ChinaClever/CleverDoc/管理软件/CleverManager项目研发资料输出一览表及相关表单/网络压力可靠性试验/Docker模拟测试/模拟udp管理程序/执行说明.txt

1.打开终端 

Ctrl + Alt + T

2.进入超级管理员权限
sudo su
password：123456

3.执行程序
./test
