ChinaClever/CleverDoc/公司文件/定制文件表格/样品定制申请表.docx

样品定制申请表

发出部门 | | | 发出日期 | | | | | | 编号
产品名称 | | | | | | | | | 客户信息
产品定制简述 （定制内容） | 技术要求简述
| 订单量 预估 | | | | | | 订单需求 时间
定制责任人（部门）确认 | 技术可行性评估及建议
| 定制完成期限
| 责任人 | | | | | | 部门
编制 | | | | 审核 | | | | 批准
公司审批
接受部门 | | | | | 市场技术支持部

存档：市场技术支持部，定制发出业务部门。 表格编号：QR-JSZC-001 A/0
