ChinaClever/CleverDoc/管理软件/CleverManager项目研发资料输出一览表及相关表单/网络压力可靠性试验/网络压力测试纪录.docx

网络压力测试纪录

100ip 500dev

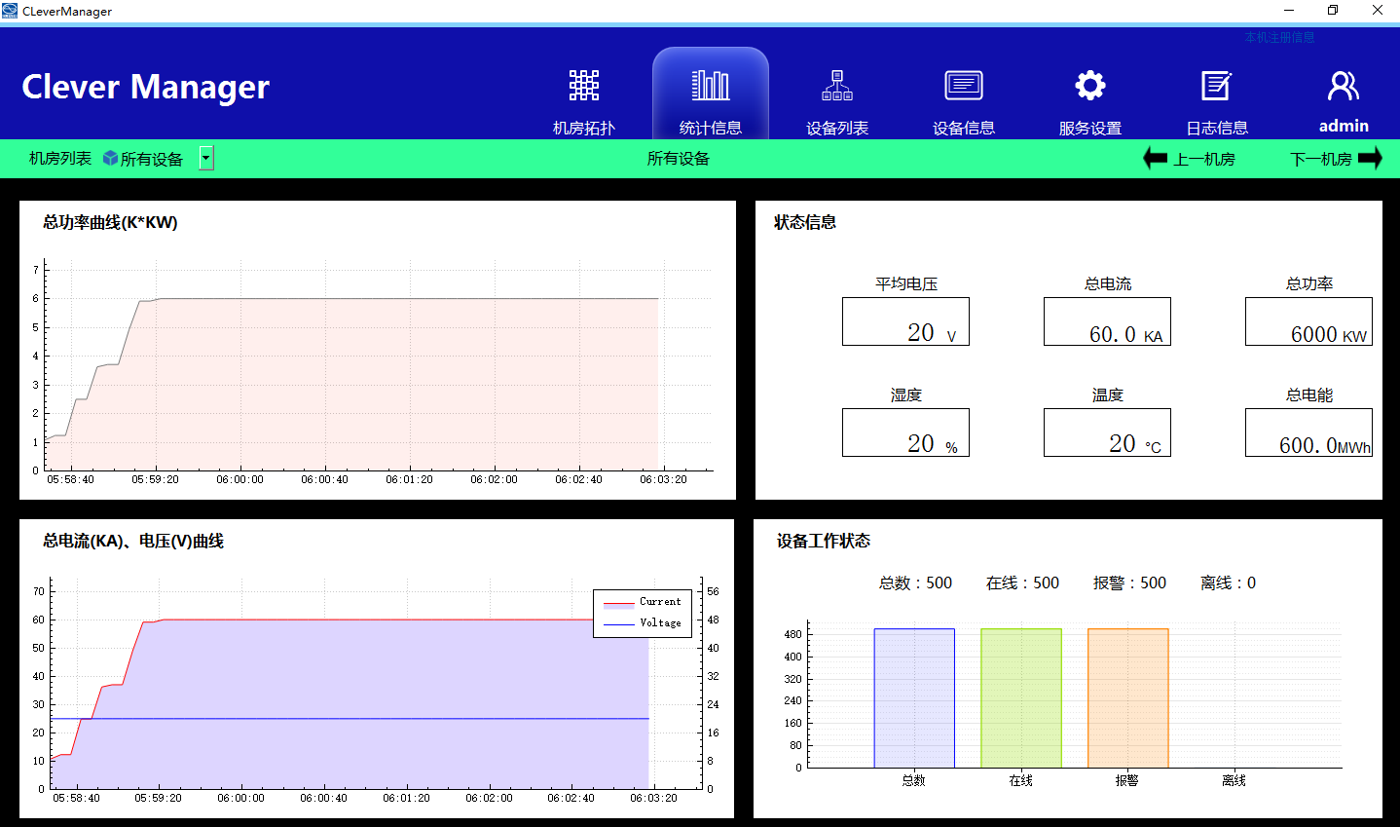
[picture p35: figure]

100ip 1000dev

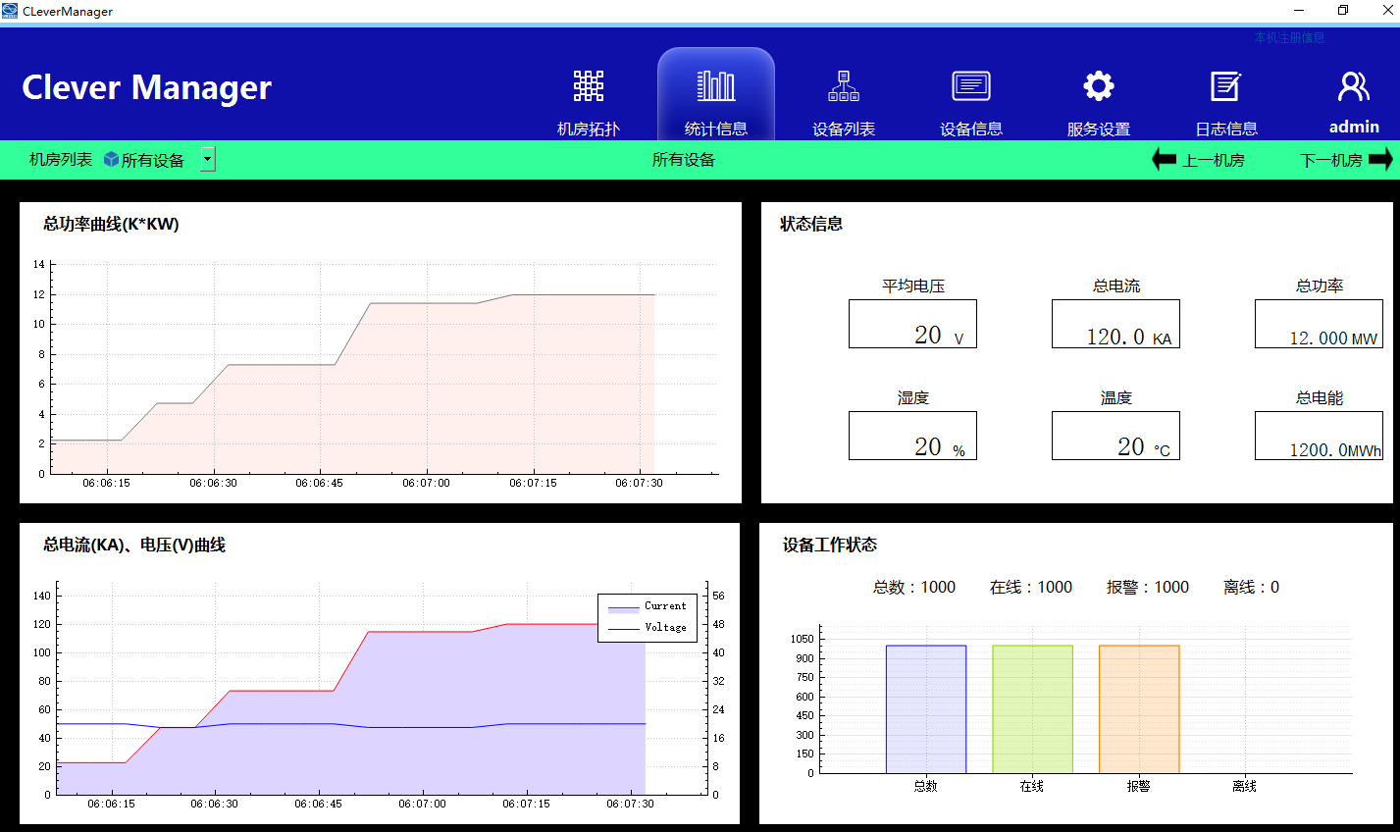
[picture p36: figure]

200ip 1000dev

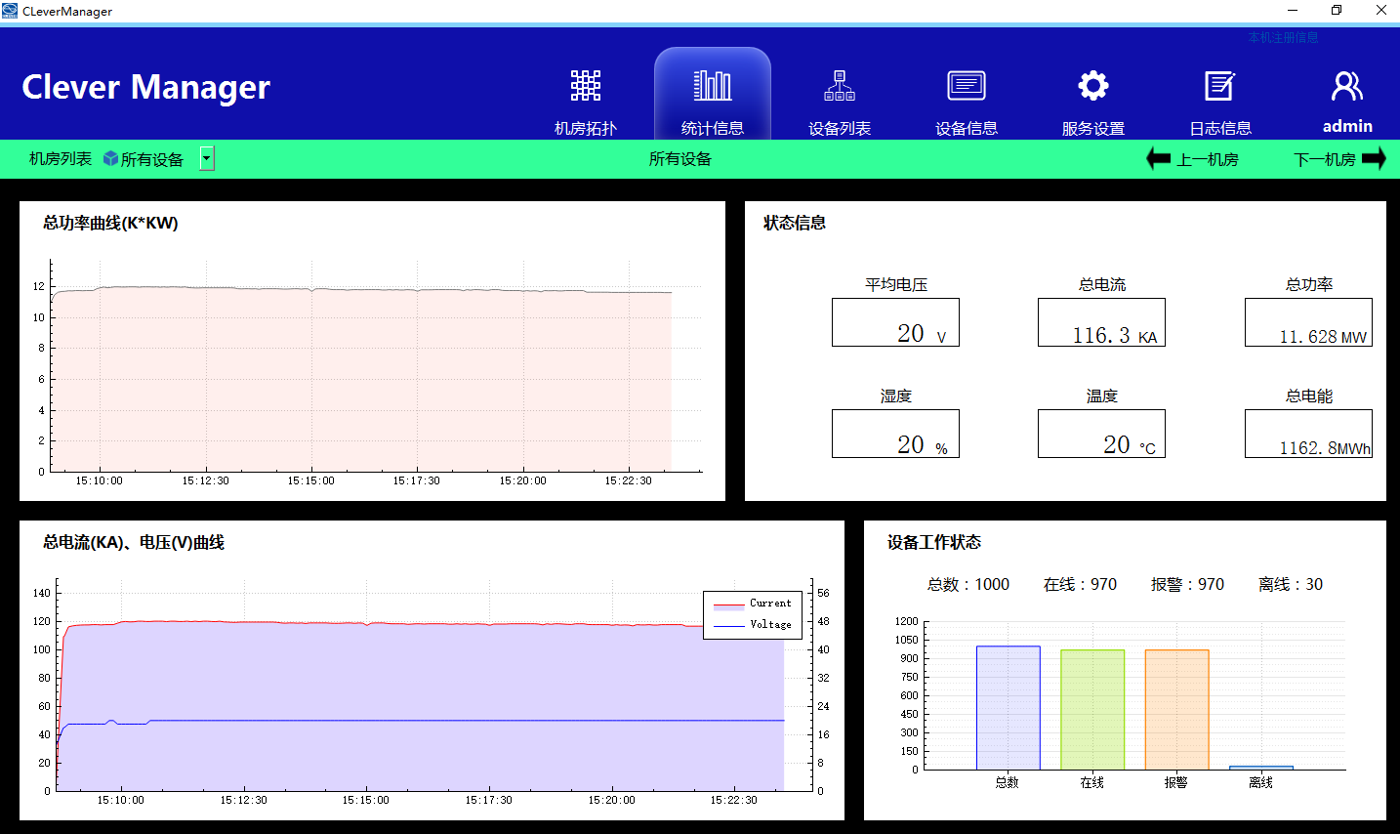
[picture p37: figure]

200ip 1200dev

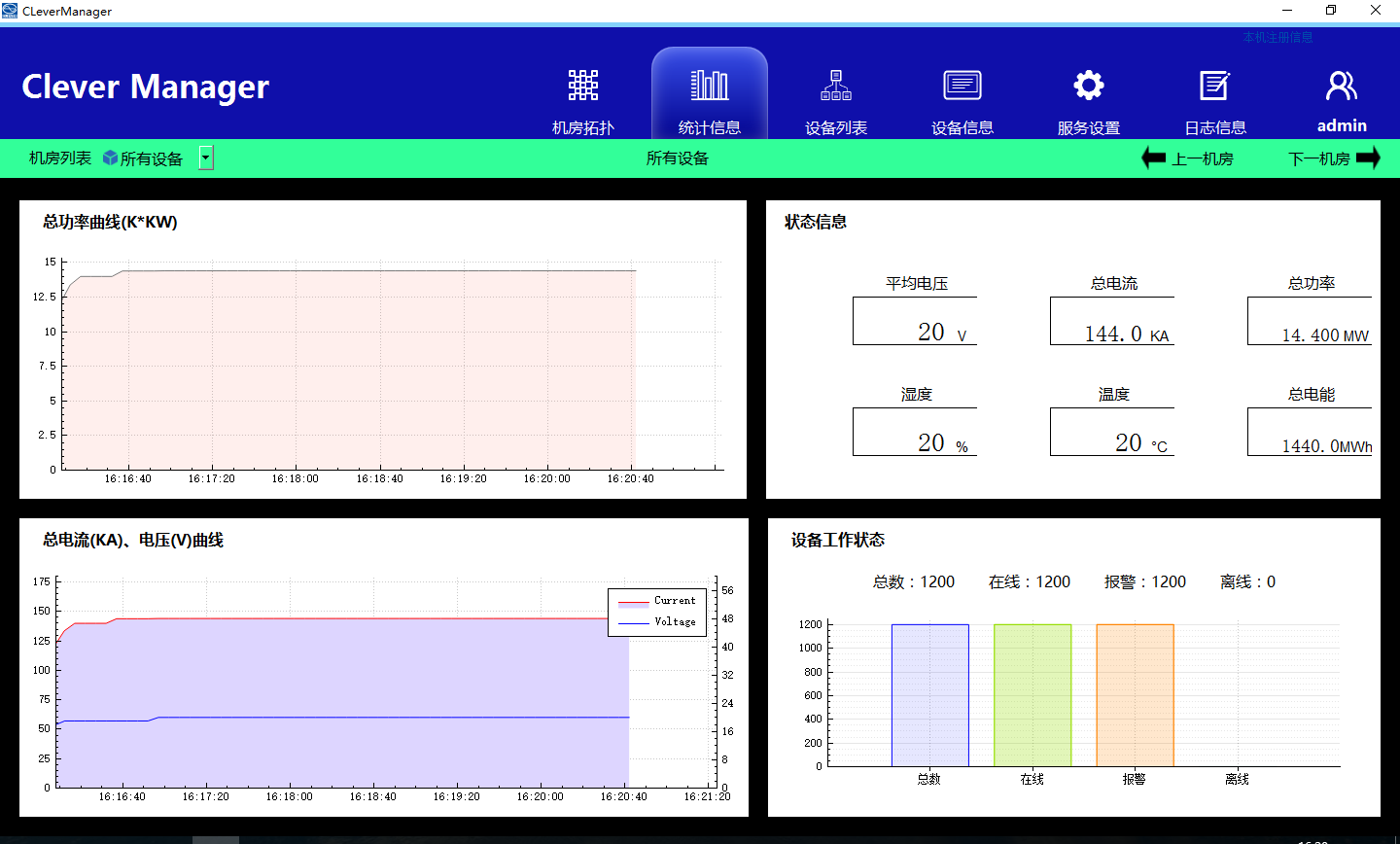
[picture p38: figure]

1000ip 1200dev

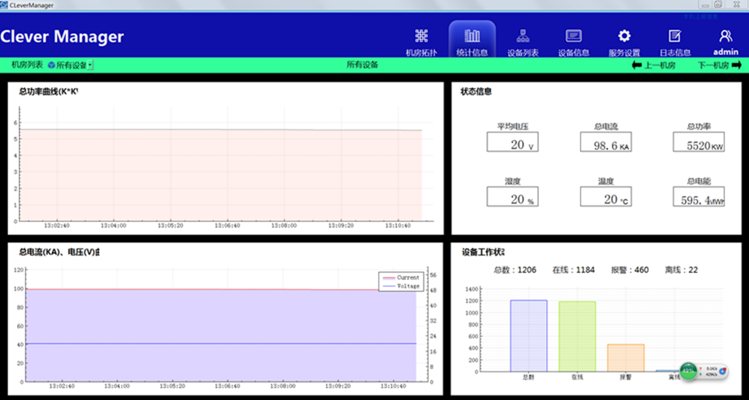
[picture p39: figure]

1000ip 2100dev

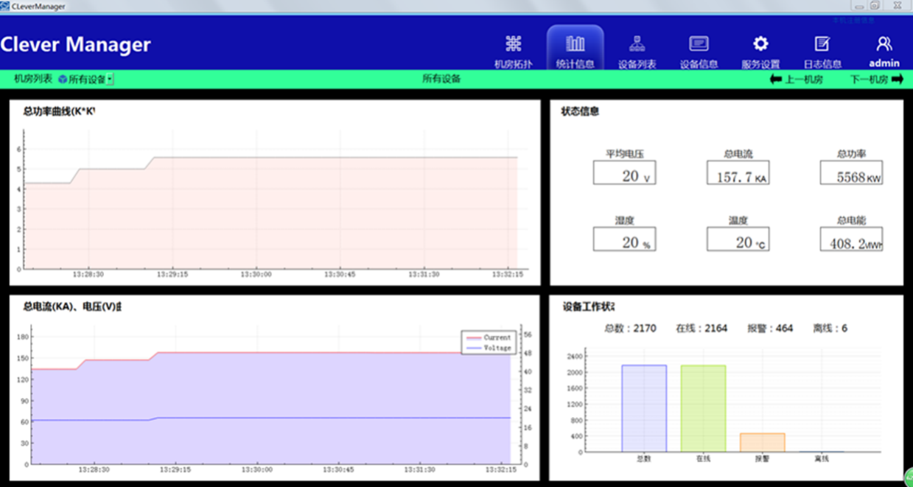
[picture p40: figure]

1000ip 1700dev 14小时长时间挂机测试

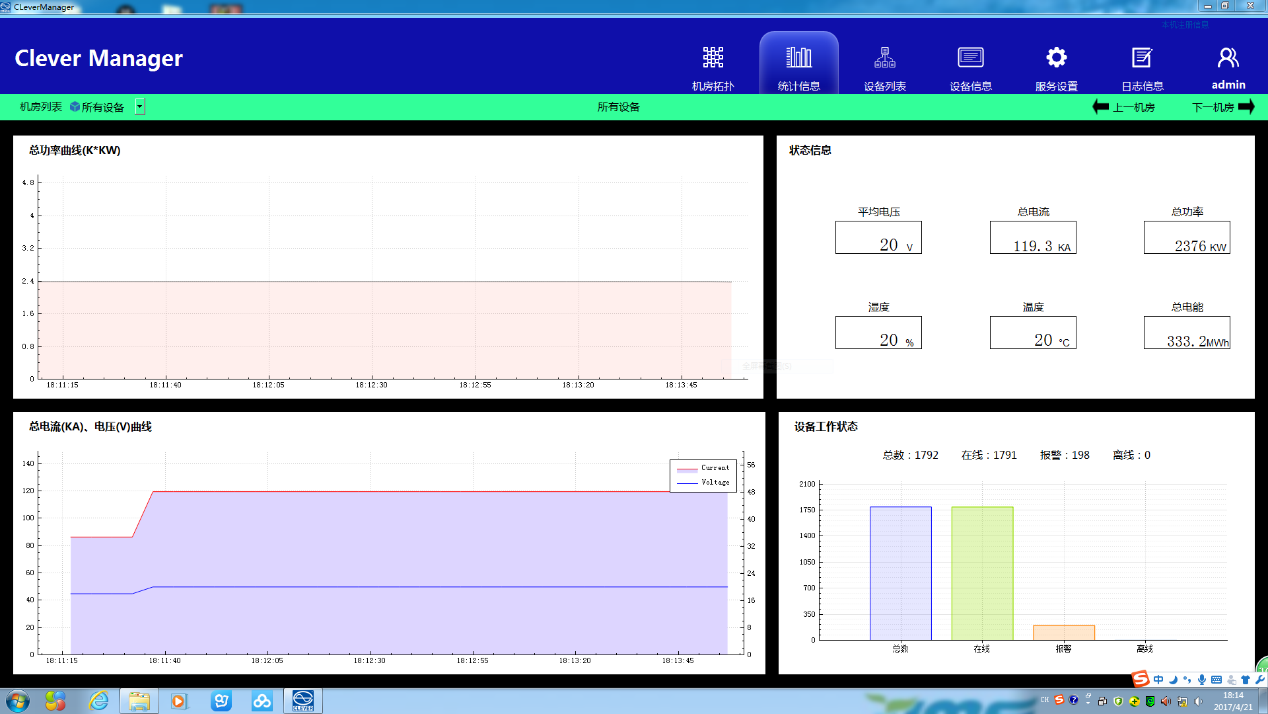
[picture p41: figure]
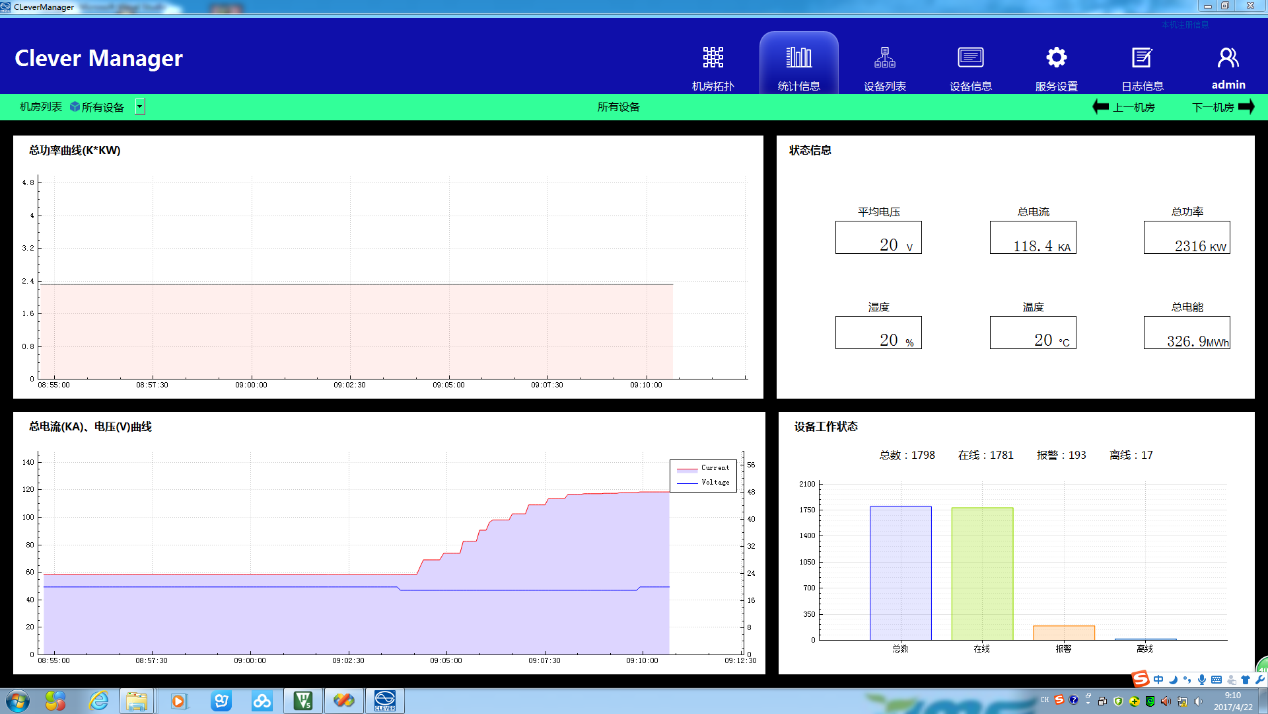
[picture p42: figure]
