ChinaClever/CleverDoc/管理软件/CleverManager项目研发资料输出一览表及相关表单/网络压力可靠性试验/Docker模拟测试/docker测试记录.docx

100ip 500dev


100ip 1000dev


200ip 1000dev


200ip 1200dev


1000ip 1200dev


1000ip 2100dev


1000ip 1700dev 14小时长时间挂机测试
