ChinaClever/CleverDoc/MPDU/MPDU 2017产品资料/MS-PDU2017-单三相32A操作显示页面流程.pdf

R:243
G:214
B:172

三相32A显示操作流程

常亮循环页面有8个：每相显示电流电压功率电能
每组电流, | ,
长按CONTROL键，进入每位插座位电流监控页面

温湿度 IP地址

长按CONTROL+UP键,进入每位插座位功率监控页面 长按CONTROL+DOWN键,进入每位插座位电能监控页面

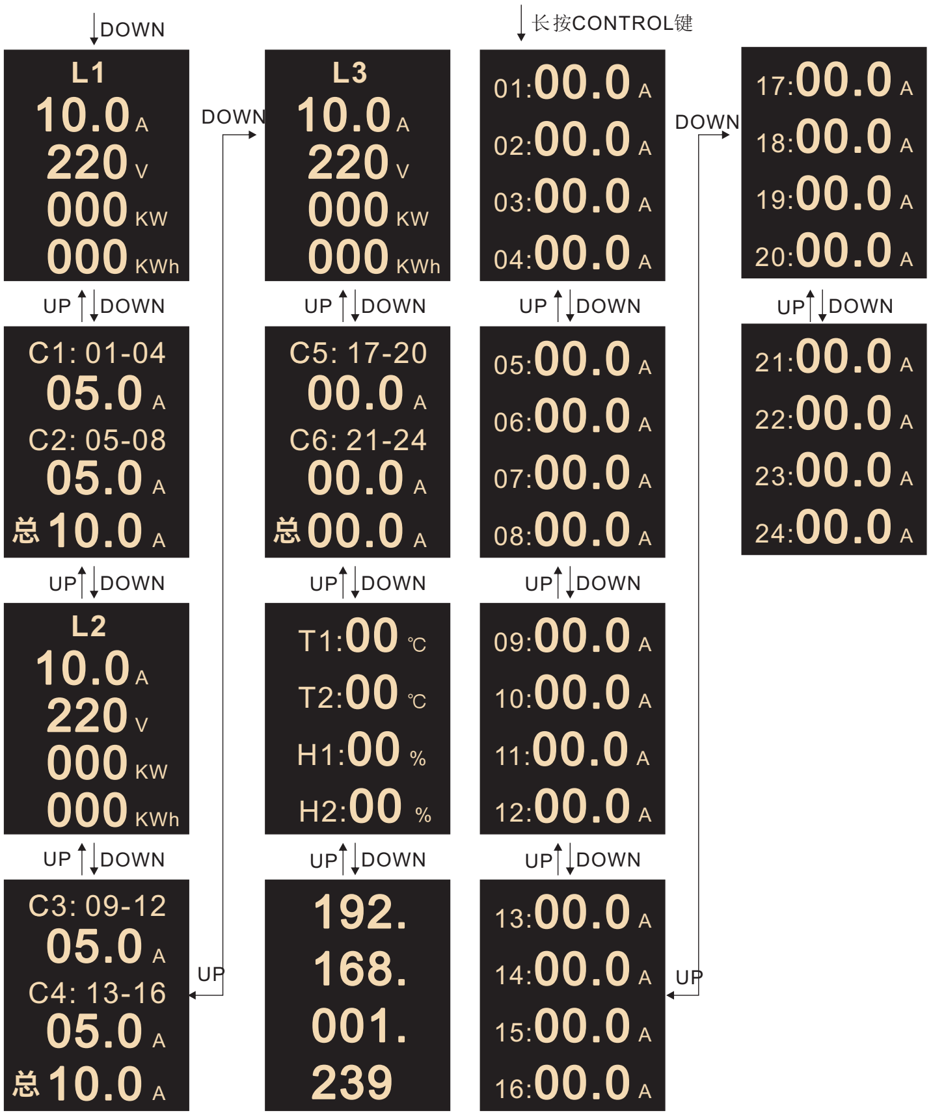
[picture p76: figure]
KWh; DOWN; 长按CONTROL键

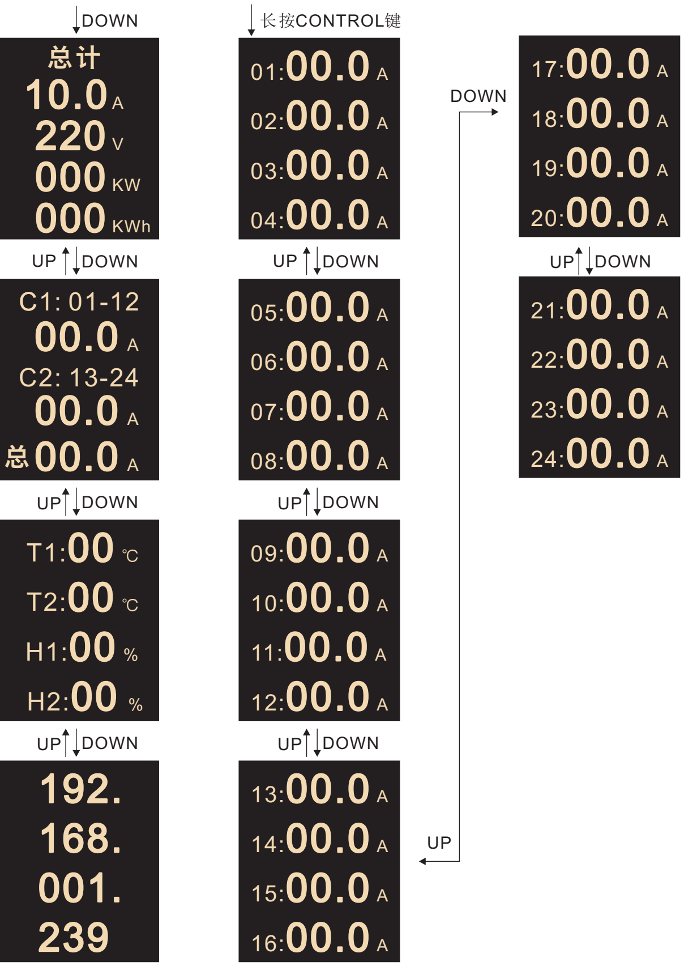
[picture p77: figure]
KWh; DOWN; 长按CONTROL键

R:243
G:214
B:172

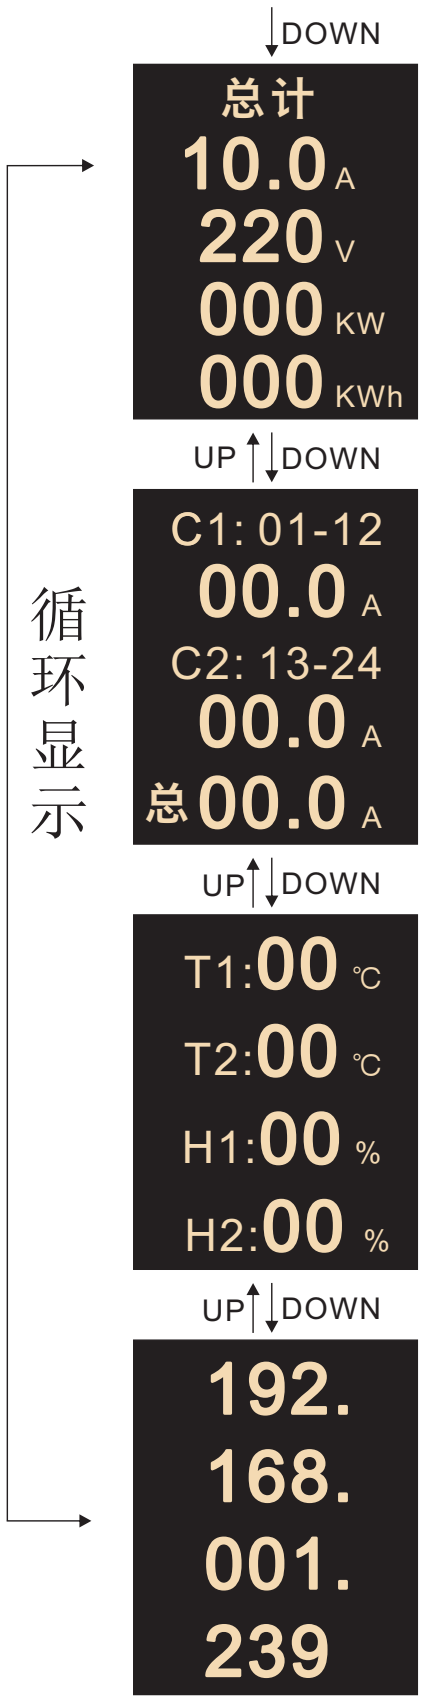
[picture p78: figure]

单相32A显示操作流程

常亮循环页面有四个：1.显示电流电压功率电能
2.每组电流 3. | 4.
长按CONTROL键，进入每位插座位电流监控页面

温湿度 IP地址

长按CONTROL+UP键,进入每位插座位功率监控页面 长按CONTROL+DOWN键,进入每位插座位电能监控页面

01:00.0 KW | 01:00.0 KWh
05:00.0 KW | 05:00.0 KWh
09:00.0 KW | 09:00.0 KWh
13:00.0 KW | 13:00.0 KWh
17:00.0 KW | 17:00.0 KWh
21:00.0 KW | 21:00.0 KWh
02:00.0 KW | 02:00.0 KWh
06:00.0 KW | 06:00.0 KWh
10:00.0 KW | 10:00.0 KWh
14:00.0 KW | 14:00.0 KWh
18:00.0 KW | 18:00.0 KWh
22:00.0 KW | 22:00.0 KWh
03:00.0 KW | 03:00.0 KWh
07:00.0 KW | 07:00.0 KWh
11:00.0 KW | 11:00.0 KWh
15:00.0 KW | 15:00.0 KWh
19:00.0 KW | 19:00.0 KWh
23:00.0 KW | 23:00.0 KWh
04:00.0 KW | 04:00.0 KWh
08:00.0 KW | 08:00.0 KWh
12:00.0 KW | 12:00.0 KWh
16:00.0 KW | 16:00.0 KWh
20:00.0 KW | 20:00.0 KWh
24:00.0 KW | 24:00.0 KWh

UP

UP

UP

DOWN | UP

DOWN

DOWN

DOWN

DOWN

DOWN | DOWN

DOWN

UP

UP | UP
UP | UP

UP

长按
CONTROL
+UP键

长按
CONTROL
+DOWN键
DOWN | DOWN
