ChinaClever/CleverDoc/MPDU/MPDU 2017产品资料/MS-PDU   2.png

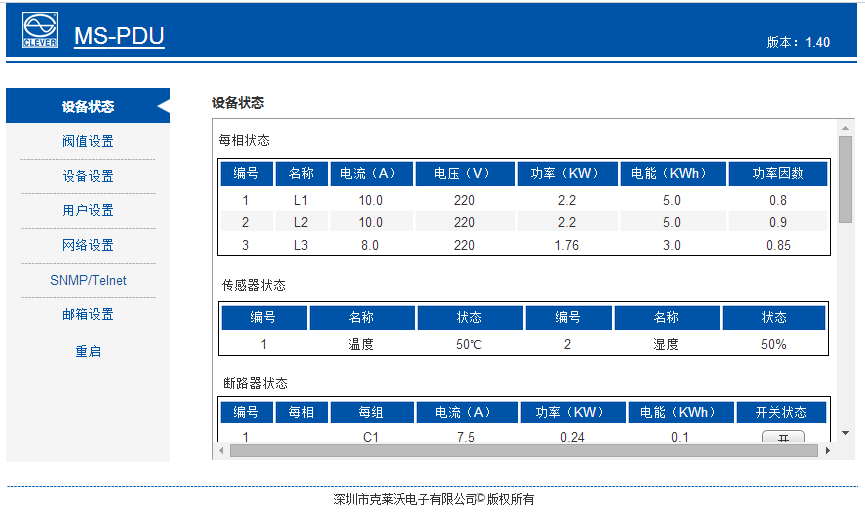
MPDU/MPDU 2017产品资料/MS-PDU 2.png
