ChinaClever/CleverDoc/MPDU/MPDU 2017产品资料/测试文档/网络压力可靠性试验/附图/2-0.png

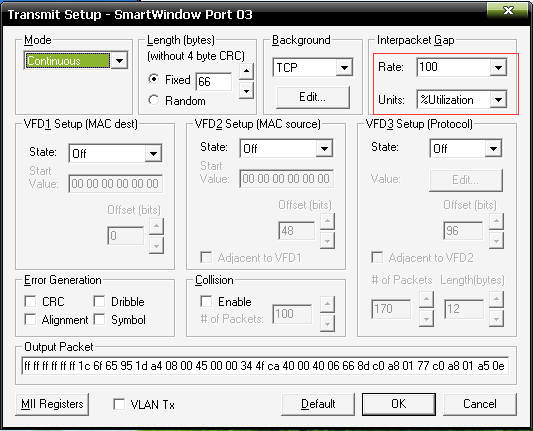
MPDU/MPDU 2017产品资料/测试文档/网络压力可靠性试验/附图/2-0.png
