ChinaClever/CleverDoc/管理软件/CleverManager项目研发资料输出一览表及相关表单/界面截图/4服务设置.png

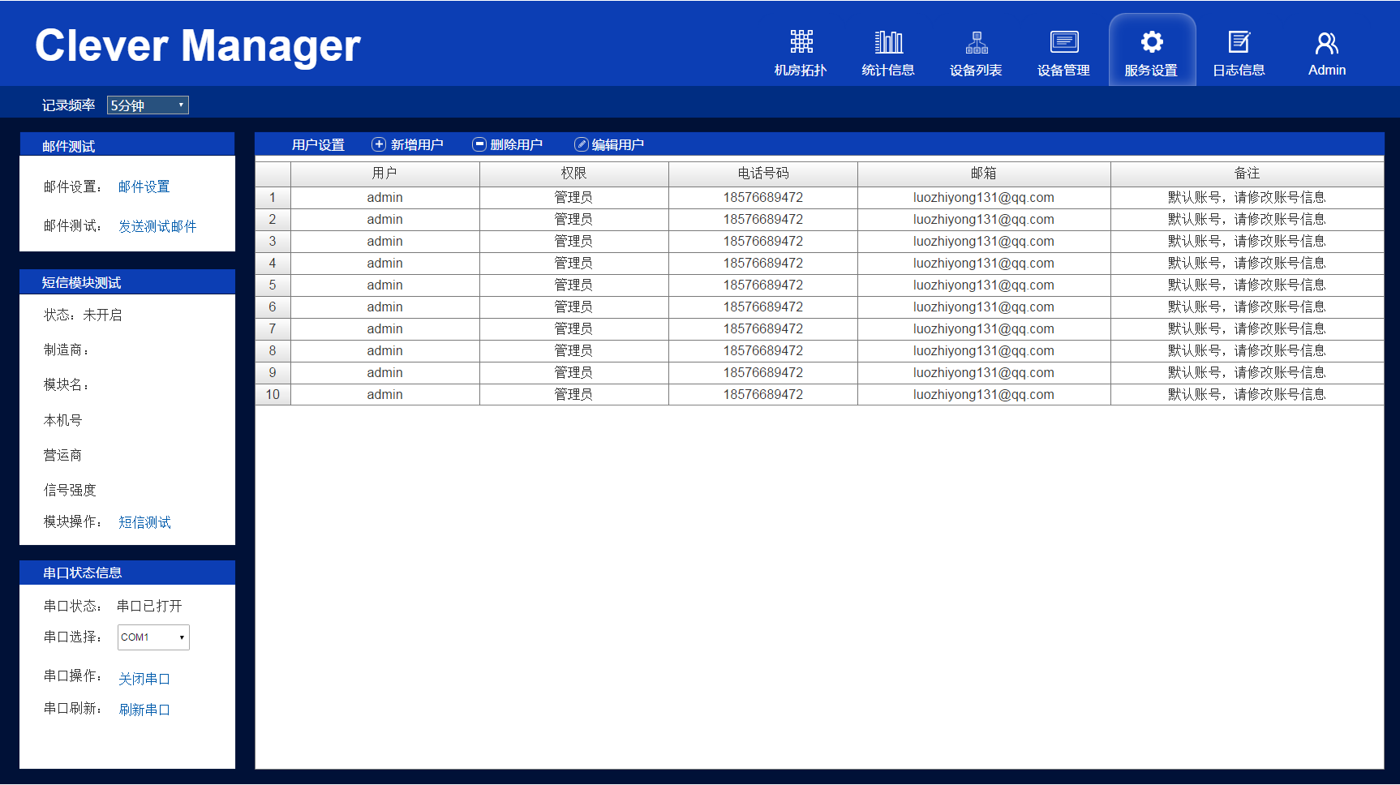
管理软件/CleverManager项目研发资料输出一览表及相关表单/界面截图/4服务设置.png
