ChinaClever/CleverDoc/管理软件/CleverManager项目研发资料输出一览表及相关表单/自检测试文档/测试说明/机房拓扑/机房拓扑1.png

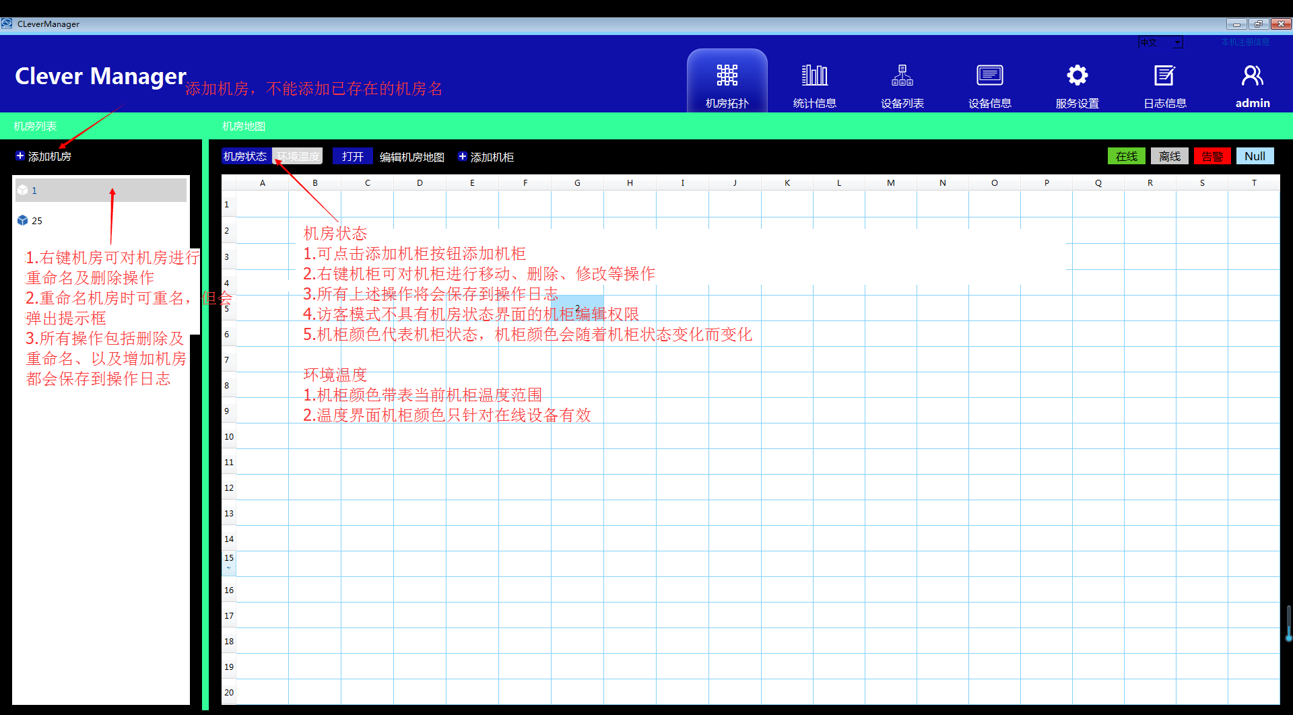
管理软件/CleverManager项目研发资料输出一览表及相关表单/自检测试文档/测试说明/机房拓扑/机房拓扑1.png
