ChinaClever/CleverDoc/MPDU/MPDU 2017产品资料/产品ERP编码/MPDU 2017 ERP物料编号.docx

Metal Monitored PDU MPDU A系列智能型铝镁回路量测配电单元 Model Number Part Number

0U, 32A 230V IEC 60309, (36)C13 & (6)C19 MA 1342-3606 J1BJ7ZC1C6EA201CNGF1825000

0U, 63A 230V IEC 60309, (36)C13 & (6)C19 MA 1642-3606 J1BJ9ZC1C6EA201CNN11825000

0U, 11kW 400V IEC 60309, (36)C13 & (6)C19 MA 3142-3606 J1BJ4ZC1C6EA20JCNKJ1825000

0U, 22kW 400V IEC 60309, (36)C13 & (6)C19 MA 3342-3606 J1BJ7ZC1C6EA20JCNLK1825000

Metal Per Port Monitored PDU MPDU B系列智能型铝镁每位量测配电单元 Model Number Part Number

0U, 32A 230V IEC 60309, (36)C13 & (6)C19 MB 1342-3606 J1BJ7ZC1C6EB201CNGF1825000

0U, 63A 230V IEC 60309, (36)C13 & (6)C19 MB 1642-3606 J1BJ9ZC1C6EB201CNN11825000

0U, 11kW 400V IEC 60309, (36)C13 & (6)C19 MB 3142-3606 J1BJ4ZC1C6EB20JCNKJ1825000

0U, 22kW 400V IEC 60309, (36)C13 & (6)C19 MB 3342-3606 J1BJ7ZC1C6EB20JCNLK1825000

Metal Switched PDU MPDU C系列智能型铝镁每位控制配电单元 Model Number Part Number

0U, 32A 230V IEC 60309, (21)C13 & (3)C19 MC 1324-2103 J1BJ7LC3E00C201CN5F1825000

0U, 32A 230V IEC 60309, (18)C13 & (6)C19 MC 1324-1806 J1BJ7IC6E00C201CN5F1825000

0U, 32A 230V IEC 60309, (20)C13 & (4)C19 MC 1324-2004 J1BJ7KC4E00C201CN5F1825000

0U, 63A 230V IEC 60309, (21)C13 & (3)C19 MC 1624-2103 J1BJ9LC3E00C201CNN11825000

0U, 63A 230V IEC 60309, (18)C13 & (6)C19 MC 1624-1806 J1BJ9IC6E00C201CNN11825000

0U, 63A 230V IEC 60309, (20)C13 & (4)C19 MC 1624-2004 J1BJ9KC4E00C201CNN11825000

0U, 11kW 400V IEC 60309, (21)C13 & (3)C19 MC 3124-2103 J1BJ4LC3E00C201CN8J1825000

0U, 11kW 400V IEC 60309, (18)C13 & (6)C19 MC 3124-1806 J1BJ4IC6E00C201CN8J1825000

0U, 11kW 400V IEC 60309, (20)C13 & (4)C19 MC 3124-2004 J1BJ4KC4E00C201CN8J1825000

0U, 22kW 400V IEC 60309, (21)C13 & (3)C19 MC 3324-2103 J1BJ7LC3E00C201CNAK1825000

0U, 22kW 400V IEC 60309, (18)C13 & (6)C19 MC 3324-1806 J1BJ7IC6E00C201CNAK1825000

0U, 22kW 400V IEC 60309, (20)C13 & (4)C19 MC 3324-2004 J1BJ7KC4E00C201CNAK1829000

Metal Per Port Monitored & Switched PDU MPDU D系列智能型铝镁每位量测控制配电单元 Model Number Part Number

0U, 32A 230V IEC 60309, (21)C13 & (3)C19 MD 1324-2103 J1BJ7LC3E00D201CN5F1829000

0U, 32A 230V IEC 60309, (18)C13 & (6)C19 MD 1324-1806 J1BJ7IC6E00D201CN5F1829000

0U, 32A 230V IEC 60309, (20)C13 & (4)C19 MD 1324-2004 J1BJ7KC4E00D201CN5F1829000

0U, 63A 230V IEC 60309, (21)C13 & (3)C19 MD 1624-2103 J1BJ9LC3E00D201CNN11825000

0U, 63A 230V IEC 60309, (18)C13 & (6)C19 MD 1624-1806 J1BJ9IC6E00D201CNN11825000

0U, 63A 230V IEC 60309, (20)C13 & (4)C19 MD 1624-2004 J1BJ9KC4E00D201CNN11825000

0U, 11kW 400V IEC 60309, (21)C13 & (3)C19 MD 3124-2103 J1BJ4LC3E00D201CN8J1829000

0U, 11kW 400V IEC 60309, (18)C13 & (6)C19 MD 3124-1806 J1BJ4IC6E00D201CN8J1829000

0U, 11kW 400V IEC 60309, (20)C13 & (4)C19 MD 3124-2004 J1BJ4KC4E00D201CN8J1829000

0U, 22kW 400V IEC 60309, (21)C13 & (3)C19 MD 3324-2103 J1BJ7LC3E00D201CNAK1829000

0U, 22kW 400V IEC 60309, (18)C13 & (6)C19 MD 3324-1806 J1BJ7IC6E00D201CNAK1829000

0U, 22kW 400V IEC 60309, (20)C13 & (4)C19 MD 3324-2004 J1BJ7KC4E00D201CNAK1829000
