ChinaClever/CleverDoc/MPDU/MPDU 2017产品资料/BOM/MPDU A系列 总计量板 物料清单.xlsx

Sheet: MPDU A系列三相
MPDU A系列三相总计量板 物料清单
No. | 物料编码 | 物料名称 | 规 格 型 号 | 数量（PCS） | 采购价格（元/RMB） |  | 计划价格（元/RMB） |  | 特别要求与说明 | 备 注
 |  |  |  |  | 单价 | 金额 | 单价 | 金额
1 | YM040070067 | MPDU-主控计量板PCB | MPDU-ZK-JL/0.2/2017-06-20/85mm*44mm*1.6 mm/双面板/沉锡/铜厚1OZ/ROHS | 1 |  |  |  |  | MODEL： MPDU -ZK-JL REV： V1.0 DATE：2017-08-25 |  | 新物料 | 重新申请物料编码
外发贴片物料
2 | YM030030054 | 贴片电容 | 0.1uF/50V 0603 ±10% | 12 |  |  |  |  | C1, C2, C5, CA3, CA7, CA12, CB3, CB7, CB12, CC3, CC7, CC12
3 | YM030030075 | 贴片钽电容 | 33uF/±10%/16V/B型 | 1 |  |  |  |  | C3,
4 | YM030030067 | 贴片钽电容 | 3528/100uF/±10%/10V/B型 | 2 |  |  |  |  | C4,C8
5 | YM030030069 | 贴片电容 | 15pF/25V 0603±5% | 7 |  |  |  |  | CA9, CA11, CB9, CB11, CC9, CC11，CC10
6 | YM030030058 | 贴片电容 | 33nF/50V 0603±10% | 12 |  |  |  |  | CA1, CA2, CA4, CA5, CB1, CB2, CB5, CB6, CC1, CC2, CC4, CC5
7 | YM030020090 | 贴片电阻 | 1KΩ 0603±1% 1/10W | 15 |  |  |  |  | RA4, RA5, RA10, RA11, RA13, RB4, RB5, RB6, RB7, RB8,, RC4, RC5, RC8, RC9, RC11
8 | YM030020102 | 贴片电阻 | 0603/49.9Ω/±1%/1/10W | 6 |  |  |  |  | RA2, RA3,RB2, RB3,RC2, RC3
9 | YM030030021 | 贴片电容 | 0805/10uF/±10%/16V | 9 |  |  |  |  | CA6, CA8, CB4, CB8, CB13, CC6, CC8, CC13，CA13
10 | YM030020098 | 贴片电阻 | 10Ω 0603 ±1% 1/10W | 3 |  |  |  |  | RA12, RB9, RC10
11 | YM030020088 | 贴片电阻 | 10KΩ 0603 ±1% 1/10W | 5 |  |  |  |  | R3, R4, R5, R9, R10
12 | YM030020091 | 贴片电阻 | 120Ω 0603±1%/1/10W | 3 |  |  |  |  | RA14, RB12, RC12
13 | YM030020092 | 贴片电阻 | 33Ω 0603±1% 1/10W | 4 |  |  |  |  | R1, R2, R6, R7
14 | YM030020131 | 贴片电阻 | 0603/5.1Ω/±1%/1/10W | 6 |  |  |  |  | RA8, RA9, RB10, RB11, RC6, RC7
15 | YM030160109 | 贴片IC | RN8207C | 3 |  |  |  |  | UA1, UB1, UC1
16 | YM030160106 | 贴片光耦 | EL3H7(E)(TA)(D)--LG | 3 |  |  |  |  | USA, USB, USC
17 | YM030160069 | 贴片IC | MAX13487/(SO-08) | 1 |  |  |  |  | U1
18 | YM030160035 | 贴片IC | SPX1117M3 SOT-223 | 1 |  |  |  |  | U2
19 | YM030160043 | 稳压管 | 78M05/(TO-252） | 1 |  |  |  |  | U3 |  | 新增
20 | YM030050020 | 贴片二极管 | 封装尺寸/IN5819 | 1 |  |  |  |  | D1
插件物料
21 | YM030020032 | 插件金属膜电阻 | 180KΩ/±1%/2W | 3 |  |  |  |  | RA1, RB1, RC1
22 | YM030200230 | 单排排母 | 间距2.0mm/带锁扣/DIP4-90度 | 1 |  |  |  |  | J1 |  | 新物料
23 | YM030130014 | 电流互感器 | CT-082-2.0/内孔/大于5.1mm(KCT135A2D) | 3 |  |  |  |  | CTA1, CTB1, CTC1 |  | 新物料
24 | YM030130010 | 电压互感器 | PT-006 | 3 |  |  |  |  | PTA1, PTB1, PTC1
25 | YM030070006 | 晶振 | 3.579545MHz | 3 |  |  |  |  | YA1, YB1, YC1
26 | 编制：杨静 2017-08-11 |  | 审核：江长胜 2017-8-11 |  |  | 0 |  | 批准：
 | 注：以上物料必须符合ROHS要求；

Sheet: 单相两路
MPDU A系列单相两路总计量板 物料清单
No. | 物料编码 | 物料名称 | 规 格 型 号 | 数量（PCS） | 采购价格（元/RMB） |  | 计划价格（元/RMB） |  | 特别要求与说明 | 备 注
 |  |  |  |  | 单价 | 金额 | 单价 | 金额
1 | YM040070067 | MPDU-主控计量板PCB | MPDU-ZK-JL/0.2/2017-06-20/85mm*44mm*1.6 mm/双面板/沉锡/铜厚1OZ/ROHS | 1 |  |  |  |  | MODEL： MPDU -ZK-JL REV： V1.0 DATE：2017-08-25 |  | 新物料 | 重新申请物料编码
外发贴片物料
2 | YM030030054 | 贴片电容 | 0.1uF/50V 0603 ±10% | 12 |  |  |  |  | C1, C2, C5, CA3, CA7, CA12, CB3, CB7, CB12, CC3, CC7, CC12
3 | YM030030075 | 贴片钽电容 | 33uF/±10%/16V/B型 | 1 |  |  |  |  | C3,
4 | YM030030067 | 贴片钽电容 | 3528/100uF/±10%/10V/B型 | 2 |  |  |  |  | C4,C8
5 | YM030030069 | 贴片电容 | 15pF/25V 0603±5% | 7 |  |  |  |  | CA9, CA11, CB9, CB11, CC9, CC11，CC10
6 | YM030030058 | 贴片电容 | 33nF/50V 0603±10% | 12 |  |  |  |  | CA1, CA2, CA4, CA5, CB1, CB2, CB5, CB6, CC1, CC2, CC4, CC5
7 | YM030020090 | 贴片电阻 | 1KΩ 0603±1% 1/10W | 15 |  |  |  |  | RA4, RA5, RA10, RA11, RA13, RB4, RB5, RB6, RB7, RB8,, RC4, RC5, RC8, RC9, RC11
8 | YM030020102 | 贴片电阻 | 0603/49.9Ω/±1%/1/10W | 6 |  |  |  |  | RA2, RA3,RB2, RB3,RC2, RC3
9 | YM030030021 | 贴片电容 | 0805/10uF/±10%/16V | 9 |  |  |  |  | CA6, CA8, CB4, CB8, CB13, CC6, CC8, CC13，CA13
10 | YM030020098 | 贴片电阻 | 10Ω 0603 ±1% 1/10W | 3 |  |  |  |  | RA12, RB9, RC10
11 | YM030020088 | 贴片电阻 | 10KΩ 0603 ±1% 1/10W | 5 |  |  |  |  | R3, R4, R5, R9, R10
12 | YM030020091 | 贴片电阻 | 120Ω 0603±1%/1/10W | 3 |  |  |  |  | RA14, RB12, RC12
13 | YM030020092 | 贴片电阻 | 33Ω 0603±1% 1/10W | 4 |  |  |  |  | R1, R2, R6, R7
14 | YM030020131 | 贴片电阻 | 0603/5.1Ω/±1%/1/10W | 6 |  |  |  |  | RA8, RA9, RB10, RB11, RC6, RC7
15 | YM030160109 | 贴片IC | RN8207C | 2 |  |  |  |  | UA1, UB1
16 | YM030160106 | 贴片光耦 | EL3H7(E)(TA)(D)--LG | 2 |  |  |  |  | USA, USB
17 | YM030160069 | 贴片IC | MAX13487/(SO-08) | 1 |  |  |  |  | U1
18 | YM030160035 | 贴片IC | SPX1117M3 SOT-223 | 1 |  |  |  |  | U2
19 | YM030160043 | 稳压管 | 78M05/(TO-252） | 1 |  |  |  |  | U3 |  | 新增
20 | YM030050020 | 贴片二极管 | 封装尺寸/IN5819 | 1 |  |  |  |  | D1
插件物料
21 | YM030020032 | 插件金属膜电阻 | 180KΩ/±1%/2W | 2 |  |  |  |  | RA1, RB1
22 | YM030200230 | 单排排母 | 间距2.0mm/带锁扣/DIP4-90度 | 1 |  |  |  |  | J1 |  | 新物料
23 | YM030130014 | 电流互感器 | CT-082-2.0/内孔/大于5.1mm(KCT135A2D) | 2 |  |  |  |  | CTA1, CTB1 |  | 新物料
24 | YM030130010 | 电压互感器 | PT-006 | 2 |  |  |  |  | PTA1, PTB1
25 | YM030070006 | 晶振 | 3.579545MHz | 2 |  |  |  |  | YA1, YB1
26 | 编制：杨静 2017-08-11 |  | 审核：江长胜 2017-8-11 |  |  | 0 |  | 批准：
 | 注：以上物料必须符合ROHS要求；

Sheet: 单相1路
MPDU A系列单相1路总计量板 物料清单
No. | 物料编码 | 物料名称 | 规 格 型 号 | 数量（PCS） | 采购价格（元/RMB） |  | 计划价格（元/RMB） |  | 特别要求与说明 | 备 注
 |  |  |  |  | 单价 | 金额 | 单价 | 金额
1 | YM040070067 | MPDU-主控计量板PCB | MPDU-ZK-JL/0.2/2017-06-20/85mm*44mm*1.6 mm/双面板/沉锡/铜厚1OZ/ROHS | 1 |  |  |  |  | MODEL： MPDU -ZK-JL REV： V1.0 DATE：2017-08-25 |  | 新物料 | 重新申请物料编码
外发贴片物料
2 | YM030030054 | 贴片电容 | 0.1uF/50V 0603 ±10% | 12 |  |  |  |  | C1, C2, C5, CA3, CA7, CA12, CB3, CB7, CB12, CC3, CC7, CC12
3 | YM030030075 | 贴片钽电容 | 33uF/±10%/16V/B型 | 1 |  |  |  |  | C3,
4 | YM030030067 | 贴片钽电容 | 3528/100uF/±10%/10V/B型 | 2 |  |  |  |  | C4,C8
5 | YM030030069 | 贴片电容 | 15pF/25V 0603±5% | 7 |  |  |  |  | CA9, CA11, CB9, CB11, CC9, CC11，CC10
6 | YM030030058 | 贴片电容 | 33nF/50V 0603±10% | 12 |  |  |  |  | CA1, CA2, CA4, CA5, CB1, CB2, CB5, CB6, CC1, CC2, CC4, CC5
7 | YM030020090 | 贴片电阻 | 1KΩ 0603±1% 1/10W | 15 |  |  |  |  | RA4, RA5, RA10, RA11, RA13, RB4, RB5, RB6, RB7, RB8,, RC4, RC5, RC8, RC9, RC11
8 | YM030020102 | 贴片电阻 | 0603/49.9Ω/±1%/1/10W | 6 |  |  |  |  | RA2, RA3,RB2, RB3,RC2, RC3
9 | YM030030021 | 贴片电容 | 0805/10uF/±10%/16V | 9 |  |  |  |  | CA6, CA8, CB4, CB8, CB13, CC6, CC8, CC13，CA13
10 | YM030020098 | 贴片电阻 | 10Ω 0603 ±1% 1/10W | 3 |  |  |  |  | RA12, RB9, RC10
11 | YM030020088 | 贴片电阻 | 10KΩ 0603 ±1% 1/10W | 5 |  |  |  |  | R3, R4, R5, R9, R10
12 | YM030020091 | 贴片电阻 | 120Ω 0603±1%/1/10W | 3 |  |  |  |  | RA14, RB12, RC12
13 | YM030020092 | 贴片电阻 | 33Ω 0603±1% 1/10W | 4 |  |  |  |  | R1, R2, R6, R7
14 | YM030020131 | 贴片电阻 | 0603/5.1Ω/±1%/1/10W | 6 |  |  |  |  | RA8, RA9, RB10, RB11, RC6, RC7
15 | YM030160109 | 贴片IC | RN8207C | 1 |  |  |  |  | UA1,
16 | YM030160106 | 贴片光耦 | EL3H7(E)(TA)(D)--LG | 1 |  |  |  |  | USA
17 | YM030160069 | 贴片IC | MAX13487/(SO-08) | 1 |  |  |  |  | U1
18 | YM030160035 | 贴片IC | SPX1117M3 SOT-223 | 1 |  |  |  |  | U2
19 | YM030160043 | 稳压管 | 78M05/(TO-252） | 1 |  |  |  |  | U3 |  | 新增
20 | YM030050020 | 贴片二极管 | 封装尺寸/IN5819 | 1 |  |  |  |  | D1
插件物料
21 | YM030020032 | 插件金属膜电阻 | 180KΩ/±1%/2W | 1 |  |  |  |  | RA1
22 | YM030200230 | 单排排母 | 间距2.0mm/带锁扣/DIP4-90度 | 1 |  |  |  |  | J1 |  | 新物料
23 | YM030130014 | 电流互感器 | CT-082-2.0/内孔/大于5.1mm(KCT135A2D) | 1 |  |  |  |  | CTA1 |  | 新物料
24 | YM030130010 | 电压互感器 | PT-006 | 1 |  |  |  |  | PTA1
25 | YM030070006 | 晶振 | 3.579545MHz | 1 |  |  |  |  | YA1
26 | 编制：杨静 2017-08-11 |  | 审核：江长胜 2017-8-11 |  |  | 0 |  | 批准：
 | 注：以上物料必须符合ROHS要求；
