ChinaClever/CleverDoc/MPDU/MPDU 2017产品资料/产品ERP编码/MPDU 2017物料编码.xlsx

Sheet: 二级物料编码
二级物料编码（
序号 | 编码 | 名称
1 | 2ZN1YLMPV0D00 | MPDU 2017D系列执行板模块4位C13+4位C19(D1-8)
2 | 2ZN1YLMPV0D01 | MPDU 2017D系列执行板模块4位C13+4位C19(D9-16)
3 | 2ZN1YLMPV0D02 | MPDU 2017D系列执行板模块4位C13+4位C19(D17-24)
4 | 2ZN1YLMPV0D03 | MPDU 2017D系列执行板模块6位C13+2位C19(D1-8)
5 | 2ZN1YLMPV0D04 | MPDU 2017D系列执行板模块6位C13+2位C19(D9-16)
6 | 2ZN1YLMPV0D05 | MPDU 2017D系列执行板模块6位C13+2位C19(D17-24)
7 | 2ZN1YLMPV0D06 | MPDU 2017D系列执行板模块7位C13+1位C19(D1-8)
8 | 2ZN1YLMPV0D07 | MPDU 2017D系列执行板模块7位C13+1位C19(D9-16)
9 | 2ZN1YLMPV0D08 | MPDU 2017D系列执行板模块7位C13+1位C19(D17-24)
10 | 2ZN1YLMPV0B00 | MPDU 2017B系列执行板模块12位C13+2位C19(B1-14)
11 | 2ZN1YLMPV0B01 | MPDU 2017B系列执行板模块12位C13+2位C19(B15-28)
12 | 2ZN1YLMPV0B02 | MPDU 2017B系列执行板模块12位C13+2位C19(B29-42)
13 | 2ZN1YLMPV0B03 | MPDU 2017B系列执行板模块4位C13+4位C19(B1-8) | 2017-4-21新增
14 | 2ZN1YLMPV0B04 | MPDU 2017B系列执行板模块4位C13+4位C19(B9-16)
15 | 2ZN1YLMPV0B05 | MPDU 2017B系列执行板模块4位C13+4位C19(B17-24)
16 | 2ZN1YLMPV0B06 | MPDU 2017B系列执行板模块6位C13+2位C19(B1-8)
17 | 2ZN1YLMPV0B07 | MPDU 2017B系列执行板模块6位C13+2位C19(B9-16)
18 | 2ZN1YLMPV0B08 | MPDU 2017B系列执行板模块6位C13+2位C19(B17-24)
19 | 2ZN1YLMPV0B09 | MPDU 2017B系列执行板模块7位C13+1位C19(B1-8)
20 | 2ZN1YLMPV0B10 | MPDU 2017B系列执行板模块7位C13+1位C19(B9-16)
21 | 2ZN1YLMPV0B11 | MPDU 2017B系列执行板模块7位C13+1位C19(B17-24)
22 | 2ZN1YLMPV0A00 | MPDU 2017A系列执行板模块12位C13+2位C19(A1-14)
23 | 2ZN1YLMPV0A01 | MPDU 2017A系列执行板模块12位C13+2位C19(A15-28)
24 | 2ZN1YLMPV0A02 | MPDU 2017A系列执行板模块12位C13+2位C19(A29-42)
25 | 2ZN1YLMPV0A03 | MPDU 2017A系列执行板模块4位C13+4位C19(A1-8) | 2017-4-21新增
26 | 2ZN1YLMPV0A04 | MPDU 2017A系列执行板模块4位C13+4位C19(A9-16)
27 | 2ZN1YLMPV0A05 | MPDU 2017A系列执行板模块4位C13+4位C19(A17-24)
28 | 2ZN1YLMPV0A06 | MPDU 2017A系列执行板模块6位C13+2位C19(A1-8)
29 | 2ZN1YLMPV0A07 | MPDU 2017A系列执行板模块6位C13+2位C19(A9-16)
30 | 2ZN1YLMPV0A08 | MPDU 2017A系列执行板模块6位C13+2位C19(A17-24)
31 | 2ZN1YLMPV0A09 | MPDU 2017A系列执行板模块7位C13+1位C19(A1-8)
32 | 2ZN1YLMPV0A10 | MPDU 2017A系列执行板模块7位C13+1位C19(A9-16)
33 | 2ZN1YLMPV0A11 | MPDU 2017A系列执行板模块7位C13+1位C19(A17-24)
34 | 2ZN1TMMPV0T00 | MPDU 2017单三相通用主控模块
35 | 2ZN1YLMPV0C00 | MPDU 2017C系列执行板模块4位C13+4位C19(C1-8)
36 | 2ZN1YLMPV0C01 | MPDU 2017C系列执行板模块4位C13+4位C19(C9-16)
37 | 2ZN1YLMPV0C02 | MPDU 2017C系列执行板模块4位C13+4位C19(C17-24)
38 | 2ZN1YLMPV0C03 | MPDU 2017C系列执行板模块6位C13+2位C19(C1-8)
39 | 2ZN1YLMPV0C04 | MPDU 2017C系列执行板模块6位C13+2位C19(C9-16)
40 | 2ZN1YLMPV0C05 | MPDU 2017C系列执行板模块6位C13+2位C19(C17-24)
41 | 2ZN1YLMPV0C06 | MPDU 2017C系列执行板模块7位C13+1位C19(C1-8)
42 | 2ZN1YLMPV0C07 | MPDU 2017C系列执行板模块7位C13+1位C19(C9-16)
43 | 2ZN1YLMPV0C08 | MPDU 2017C系列执行板模块7位C13+1位C19(C17-24)
44 | 2SRDSRMP15000 | MPDU 2017 32A底座模块
45 | 2SRDSRMP18000 | MPDU 2017 63A底座模块
46 | 2SRDSRMP32000 | MPDU 2017 3*16A底座模块
47 | 2SRDSRMP35000 | MPDU 2017 3*32A底座模块

Sheet: 三级物料编码
三级物料（包含PCB和外发贴片）
1 | 3JKPCDY001000 | MPDU 2017D系列执行采集板
2 | 3JKPEDY001000 | MPDU 2017 D系列执行板（4位C13+4位C19）
3 | 3JKPEDY001001 | MPDU 2017 D系列执行板（6位C13+2位C19）
4 | 3JKPEDY001002 | MPDU 2017 D系列执行板（7位C13+1位C19）
5 | 3JKPEBY001000 | MPDU 2017 B系列执行板1（12位C13+2位C19）
6 | 3JKPEBY001001 | MPDU 2017 B系列执行板2（12位C13+2位C19）
7 | 3JKPEBY001002 | MPDU 2017 B系列执行板（4位C13+4位C19） | 2017-4-20新增
8 | 3JKPEBY001003 | MPDU 2017 B系列执行板（6位C13+2位C19）
9 | 3JKPEBY001004 | MPDU 2017 B系列执行板（7位C13+1位C19）
10 | 3JKPEAY001000 | MPDU 2017 A系列执行板1（12位C13+2位C19）
11 | 3JKPEAY001001 | MPDU 2017 A系列执行板2（12位C13+2位C19）
12 | 3JKPEAY001002 | MPDU 2017 A系列执行板（4位C13+4位C19） | 2017-4-20新增
13 | 3JKPEAY001003 | MPDU 2017 A系列执行板（6位C13+2位C19）
14 | 3JKPEAY001004 | MPDU 2017 A系列执行板（7位C13+1位C19）
15 | 3JKPECY001000 | MPDU 2017 C系列执行板（4位C13+4位C19）
16 | 3JKPECY001001 | MPDU 2017 C系列执行板（6位C13+2位C19）
17 | 3JKPECY001002 | MPDU 2017 C系列执行板（7位C13+1位C19）
18 | 3JKPZTWYL0400 | MPDU 2017单三相通用主控板

Sheet: 成品物料编码
MPDU 2017成品编码清单
序号 | 成品编码 | 品名 | 规格型号 | 备注
1 | J1BJ4IC6E00A201CN8J1829000 | MPDU 2017-MA 3124-1806 | A系列/0U/18位C13+6位C19/11KW/400V/IEC 60309
2 | J1BJ4KC4E00A201CN8J1829000 | MPDU 2017-MA 3124-2004 | A系列/0U/20位C13+4位C19/11KW/400V/IEC 60309
3 | J1BJ4LC3E00A201CN8J1829000 | MPDU 2017-MA 3124-2103 | A系列/0U/21位C13+3位C19/11KW/400V/IEC 60309
4 | J1BJ4ZC1C6EA20JCNKJ1825000 | MPDU 2017-MA 3142-3606 | A系列/0U/36位C13+6位C19/11KW/400V/IEC 60309
5 | J1BJ7ZC1C6EA201CNGF1825000 | MPDU 2017-MA 1342-3606 | A系列/0U/36位C13+6位C19/32A/230V/IEC 60309
6 | J1BJ7ZC1C6EA20JCNLK1825000 | MPDU 2017-MA 3342-3606 | A系列/0U/36位C13+6位C19/22KW/400V/IEC 60309
7 | J1BJ9ZC1C4EA201CN711829000 | MPDU 2017-MA 1642-3606 | A系列/0U/36位C13+6位C19/63A/230V/IEC 60309
8 | J1BJ7LC3E00A201CN5F1829000 | MPDU 2017-MA 1324-2103 | A系列/0U/21位C13+3位C19/32A/230V/IEC 60309
9 | J1BJ7KC4E00A201CN5F1829000 | MPDU 2017-MA 1324-2004 | A系列/0U/20位C13+4位C19/32A/230V/IEC 60309
10 | J1BJ7IC6E00A201CN5F1829000 | MPDU 2017-MA 1324-1806 | A系列/0U/18位C13+6位C19/32A/230V/IEC 60309
11 | J1BJ7IC6E00A201CNAK1829000 | MPDU 2017-MA 3324-1806 | A系列/0U/18位C13+6位C19/22KW/400V/IEC 60309
12 | J1BJ7LC3E00A201CNAK1829000 | MPDU 2017-MA 3324-2103 | A系列/0U/21位C13+3位C19/22KW/400V/IEC 60309
13 | J1BJ7KC4E00A201CNAK1829000 | MPDU 2017-MA 3324-2004 | A系列/0U/20位C13+4位C19/22KW/400V/IEC 60309
14 | J1BJ4ZC1C6EB20JCNKJ1825000 | MPDU 2017-MB 3142-3606 | B系列/0U/36C13+6位C19/11KW/400V/IEC60309
15 | J1BJ7IC6E00B201CNAK1829000 | MPDU 2017-MB 3324-1806 | B系列/0U/18位C13+6位C19/22KW/400V/IEC60309
16 | J1BJ7KC4E00B201CNAK1829000 | MPDU 2017-MB 3324-2004 | B系列/0U/20位C13+4位C19/22KW/400V/IEC60309
17 | J1BJ7LC3E00B201CNAK1829000 | MPDU 2017-MB 3324-2103 | B系列/0U/21位C13+3位C19/22KW/400V/IEC60309
18 | J1BJ7ZC1C6EB201CNGF1825000 | MPDU 2017-MB 1342-3606 | B系列/0U/36位C13+6位C19/32A/230V/IEC60309
19 | J1BJ7ZC1C6EB20JCNLK1825000 | MPDU 2017-MB 3342-3606 | B系列/0U/36位C13+4位C19/22KW/400V/IEC60309
20 | J1BJ9ZC1C4EB201CN711829000 | MPDU 2017-MB 1642-3606 | B系列/0U/36位C13+6位C19/63A/230V/IEC60309
21 | J1BJ7LC3E00B201CN5F1829000 | MPDU 2017-MB 1324-2103 | B系列/0U/21位C13+3位C19/32A/230V/IEC60309
22 | J1BJ7KC4E00B201CN5F1829000 | MPDU 2017-MB 1324-2004 | B系列/0U/20位C13+4位C19/32A/230V/IEC60309
23 | J1BJ7IC6E00B201CN5F1829000 | MPDU 2017-MB 1324-1806 | B系列/0U/18位C13+6位C19/32A/230V/IEC60309
24 | J1BJ4IC6E00B201CN8J1829000 | MPDU 2017-MB 3124-1806 | B系列/0U/18位C13+6C19/11KW/400V/IEC60309
25 | J1BJ4KC4E00B201CN8J1829000 | MPDU 2017-MB 3124-2004 | B系列/0U/20位C13+4C19/11KW/400V/IEC60309
26 | J1BJ4LC3E00B201CN8J1829000 | MPDU 2017-MB 3124-2103 | B系列/0U/21位C13+3C19/11KW/400V/IEC60309
27 | J1BJ4IC6E00C201CN8J1829000 | MPDU 2017-MC 3124-1806 | C系列/0U/18位C13+6位C19/11kW/400V/IEC 60309
28 | J1BJ4KC4E00C201CN8J1829000 | MPDU 2017-MC 3124-2004 | C系列/0U/20位C13+4位C19/11kW/400V/IEC 60309
29 | J1BJ4LC3E00C201CN8J1829000 | MPDU 2017-MC 3124-2103 | C系列/0U/21位C13+3C19/11kW/400V/IEC60309
30 | J1BJ7IC6E00C201CN5F1829000 | MPDU 2017-MC 1324-1806 | C系列/0U/18位C13+6位C19/32A/230V/IEC 60309
31 | J1BJ7IC6E00C201CNAK1829000 | MPDU 2017-MC 3324-1806 | C系列/0U/18位C13+6位C19/22kW/400V/IEC 60309
32 | J1BJ7KC4E00C201CN5F1829000 | MPDU 2017-MC 1324-2004 | C系列/0U/20位C13+4位C19/32A/230V/ IEC 60309
33 | J1BJ7KC4E00C201CNAK1829000 | MPDU 2017-MC 3324-2004 | C系列/0U/20位C13+4位C19/22kW/400V/IEC 60309
34 | J1BJ7LC3E00C201CN5F1829000 | MPDU 2017-MC 1324-2103 | C系列/0U/21位C13+3位C19/32A/230V/IEC 60309
35 | J1BJ7LC3E00C201CNAK1829000 | MPDU 2017-MC 3324-2103 | C系列/0U/21位C13+3位C19/22kW/400V IEC 60309
36 | J1BJ9IC6E00C201CNN11825000 | MPDU 2017-MC 1624-1806 | C系列/0U/18位C13+6位C19/63A/230V/IEC 60309
37 | J1BJ9KC4E00C201CNN11825000 | MPDU 2017-MC 1624-2004 | C系列/0U/20位C13+4位C19/63A/230V/IEC 60309
38 | J1BJ9LC3E00C201CNN11825000 | MPDU 2017-MC 1624-2103 | C系列/0U/21位C13+3位C19/63A/230V/IEC 60309
39 | J1BJ4IC6E00D201CN8J1829000 | MPDU 2017-MD 3124-1806 | D系列/0U/18位C13+6位C19/11KW/400V/IEC 60309
40 | J1BJ4KC4E00D201CN8J1829000 | MPDU 2017-MD 3124-2004 | D系列/0U/20位C13+4位C19/11KW/400V/IEC 60309
41 | J1BJ4LC3E00D201CN8J1829000 | MPDU 2017-MD 3124-2103 | D系列/0U/21位C13+3位C19/11KW/400V/IEC 60309
42 | J1BJ7IC6E00D201CN5F1829000 | MPDU 2017-MD 1324-1806 | D系列/0U/18位C13+6位C19/32A/230V/IEC 60309
43 | J1BJ7IC6E00D201CNAK1829000 | MPDU 2017-MD 3324-1806 | D系列/0U/18位C13+6位C19/22KW/400V/IEC 60309
44 | J1BJ7KC4E00D201CN5F1829000 | MPDU 2017-MD 1324-2004 | D系列/0U/20位C13+4位C19/32A/230V/IEC60309
45 | J1BJ7KC4E00D201CNAK1829000 | MPDU 2017-MD 3324-2004 | D系列/0U/20位C13+4位C19/22KW/400V/IEC 60309
46 | J1BJ7LC3E00D201CN5F1829000 | MPDU 2017-MD 1324-2103 | D系列/0U/21位C13+3位C19/32A/230V/IEC 60309
47 | J1BJ7LC3E00D201CNAK1829000 | MPDU 2017-MD 3324-2103 | D系列/0U/21位C13+3位C19/22KW/400V/IEC 60309
48 | J1BJ9IC6E00D201CNN11825000 | MPDU 2017-MD 1624-1806 | D系列/0U/18位C13+6位C19/63A/230V/IEC 60309
49 | J1BJ9KC4E00D201CNN11825000 | MPDU 2017-MD 1624-2004 | D系列/0U/20位C13+4位C19/63A/230V/IEC 60309
50 | J1BJ9LC3E00D201CNN11825000 | MPDU 2017-MD 1624-2103 | D系列/0U/21位C13+3位C19/63A/230V/IEC 60309
