ChinaClever/CleverDoc/MPDU/MPDU 2017产品资料/包装图纸/M-PDU2017包装物料清单.xls

Sheet: 三相16A、单、三相32A包装
M-PDU2017 三相16A、单相、三相32A包装部分物料清单
No. | 物料编码 | 物料名称 | 规 格 型 号 | 数量 | 单位（PCS） | 采购价格（元/RMB） |  | 计划价格（元/RMB） |  | 特别要求与说明 | 备 注
 |  |  |  |  |  | 单价 | 金额 | 单价 | 金额
1 | YM060010119 | 进线端环保珍珠棉A | 210*150*126/2017智能产品(MPDU、RPDU、ZPDU) | 1 | PCS
2 | YM060010120 | 非进线端环保珍珠棉B | 170*150*126/2017智能产品(MPDU、RPDU、ZPDU) | 1 | PCS
3 | YM060010121 | 中部环保珍珠棉C | 150*150*126/2017智能产品(MPDU、RPDU、ZPDU) | 2 | PCS
4 | YM060000500 | 缓冲纸皮 | 1275*301*3mm K3K | 1 | PCS
5 | YM060000496 | 天地盒 | 2265*175*135mm/250G K=K/无字 | 1 | PCS
6 | YM060000495 | 包装箱 | 2290*385*295mm/250G K=K/无字 | 1/4 | PCS
7 | YM06001078 | 包装袋 | 2000*170*0.05mm 透明 | 1 | PCS
8 | YM060010122 | 2017智能产品珍珠棉堵头 | 150*126*50mm EPE | 1 | PCS
9 |  | 工时
10 | 价格合计（元/RMB） |  |  |  |  | 采购 |  |  | 计划
编制：王金娟 2017/04/26 |  |  | 审核：刘 轶 2017/04/26 |  |  |  | 批准：

Sheet: 单相63A包装
M-PDU2017 单相63A包装部分物料清单
No. | 物料编码 | 物料名称 | 规 格 型 号 | 数量 | 单位（PCS） | 采购价格（元/RMB） |  | 计划价格（元/RMB） |  | 特别要求与说明 | 备 注
 |  |  |  |  |  | 单价 | 金额 | 单价 | 金额
1 | YM060010119 | 进线端环保珍珠棉A | 210*150*126/2017智能产品(MPDU、RPDU、ZPDU) | 1 | PCS
2 | YM060010120 | 非进线端环保珍珠棉B | 170*150*126/2017智能产品(MPDU、RPDU、ZPDU) | 1 | PCS
3 | YM060010121 | 中部环保珍珠棉C | 150*150*126/2017智能产品(MPDU、RPDU、ZPDU) | 2 | PCS
4 | YM060000500 | 缓冲纸皮 | 1275*301*3mm K3K | 1 | PCS
5 | YM060000494 | 天地盒 | 2355*175*135mm/250G K=K/无字 | 1 | PCS
6 | YM060000497 | 包装箱 | 2380*385*295mm250G K=K/无字 | 1/4 | PCS
7 | YM06001078 | 包装袋 | 2000*170*0.05mm 透明 | 1 | PCS
8 | YM060010122 | 2017智能产品珍珠棉堵头 | 150*126*50mm EPE | 1 | PCS
9 |  | 工时
10 | 价格合计（元/RMB） |  |  |  |  | 采购 |  |  | 计划
编制：王金娟 2017/04/26 |  |  | 审核：刘 轶 2017/04/26 |  |  |  | 批准：
