ChinaClever/CleverDoc/MPDU/MPDU 2017产品资料/BOM/主控板物料清单/MPDU 2017产品主控模块物料清单.xlsx

Sheet: MPDU 2017主控板
MPDU 2017产品主控板物料清单
No. | 物料编码 | 物料名称 | 规 格 型 号 | 数量（PCS） | 采购价格（元/RMB） |  | 计划价格（元/RMB） |  | 特别要求与说明 | 备 注
 |  |  |  |  | 单价 | 金额 | 单价 | 金额
1 | YM040070055 | 主控 PCB板 | 175mm*46mm*1.6 mm (L*W*H)、双面板、沉锡、铜厚1OZ、要求ROHS | 1 |  |  |  |  | MODEL：MPDU2017-ZK PCB REV：V1.0 DATE：2017-04-06 | 升级
外发贴片物料
2 | YM030030063 | 贴片电容 | 10pF/50V 0603±0.25% | 8 |  |  |  |  | C3，C4，C46，C47， C41， C42， C44，C48，
3 | YM030030062 | 贴片电容 | 22pF/50V 0603±10% | 5 |  |  |  |  | C1， C2， C13， C35， C36
4 | YM030030085 | 贴片电容 | 820pF /50V 0603±5% | 1 |  |  |  |  | C16
5 | YM030030055 | 贴片电容 | 10nF/50V 0603 ±10% | 1 |  |  |  |  | C40
6 | YM030030076 | 贴片电容 | 68pF/50V 0603 ±10% | 1 |  |  |  |  | C18
7 | YM030030054 | 贴片电容 | 0.1uF/50V 0603 ±10% | 29 |  |  |  |  | C8， C9， C10， C19， C21， C22， C23， C24， C26， C27， C28， C29， C30， C31， C32， C37， C38， C45， C50， C51， C52， C57， C58， C59， C60， C64， C65， C68， C69
8 | YM030030069 | 贴片电容 | 15pF/25V 0603±5% | 2 |  |  |  |  | C34，C39
9 | YM030030070 | 贴片电容 | 1uF/50V 0603±10% | 6 |  |  |  |  | C6， C7， C14， C17， C55， C56
10 | YM030030084 | 贴片电容 | 2.2uF/10V 0603±10% | 5 |  |  |  |  | C11，C62，C63，C66，C67
11 | YM030030025 | 贴片钽电容 | 100uF/6.3V 3528±10% B型 | 2 |  |  |  |  | C33，C25
12 | YM030030046 | 贴片钽电容 | 10uF/16V 3216/±0.2% A型 | 1 |  |  |  |  | C61
13 | YM030030041 | 贴片钽电容 | 10uF/10V 1206 ±10% A型 | 2 |  |  |  |  | C5，C49
14 | YM030030073 | 贴片钽电容 | 220 uF/16V 2512±20% E型 | 1 |  |  |  |  | C12
15 | YM030030021 | 贴片电容 | 10uF/16V 0805±10% | 2 |  |  |  |  | C15，C53
16 | YM030020092 | 贴片电阻 | 33Ω 0603±1% 1/10W | 5 |  |  |  |  | R34， R35， R48， R61， R62
17 | YM030020102 | 贴片电阻 | 49.9Ω 0603±1% 1/10W | 4 |  |  |  |  | R53， R54， R55， R56
18 | YM030020104 | 贴片电阻 | 0Ω 0603±1% 1/10W | 4 |  |  |  |  | R47， R75， R77， R79
19 | YM030020095 | 贴片电阻 | 100Ω 0603±1% 1/10W | 1 |  |  |  |  | R5 |  | 试产修改
20 | YM030020124 | 贴片电阻 | 12.1KΩ 0603±1% 1/10W | 2 |  |  |  |  | R27，R69
21 | YM030020090 | 贴片电阻 | 1KΩ 0603±1% 1/10W | 8 |  |  |  |  | R29， R30， R31， R42， R43， R44， R51， R52
22 | YM030020088 | 贴片电阻 | 10KΩ 0603 ±1% 1/10W | 31 |  |  |  |  | R1， R3， R4， R7， R9， R10， R11， R13， R14， R15， R21， R22， R23， R24， R25， R26， R32， R33， R50， R58， R59， R70， R71， R74， R80， R85， R86， R87， R88， R89，R90 |  | 试产修改
23 | YM030020089 | 贴片电阻 | 2KΩ 0603 ±1% 1/10W | 5 |  |  |  |  | R12， R16， R18， R66， R73
24 | YM030020131 | 贴片电阻 | 5.1Ω 0603 ±1% 1/10W | 2 |  |  |  |  | R36，R37 |  | 试产修改
25 | YM030020100 | 贴片电阻 | 100KΩ 0603±1% 1/10W | 3 |  |  |  |  | R17，R60，R63
26 | YM030020056 | 贴片电阻 | 0Ω 0805±1% 1/8W | 2 |  |  |  |  | R57，R72 |  | 试产修改
27 | YM030020099 | 贴片电阻 | 1MΩ 0603±1% 1/10W | 2 |  |  |  |  | R6，R49
28 | YM030020108 | 贴片电阻 | 4.7KΩ 0603±1%/1/10W | 10 |  |  |  |  | R38， R39， R40， R41， R45， R46， R64， R65， R67， R68
29 | YM030020127 | 贴片电阻 | 51KΩ 0603±1% 1/10W | 1 |  |  |  |  | R19
30 | YM030020096 | 贴片电阻 | 51Ω 0603±1% 1/10W | 1 |  |  |  |  | R2
31 | YM030020133 | 贴片电阻 | 0603; 63.4KΩ ;±1%;1/10W | 1 |  |  |  |  | R28
32 | YM030090050 | 自恢复保险丝 | 12V/100mA/0805 | 1 |  |  |  |  | F1 | 新物料
33 | YM030200111 | 贴片磁珠 | MB-0603A-600A30T | 6 |  |  |  |  | L5，L6，L1，L3，L4，L7 |  | 试产修改
34 | YM030200046 | 贴片磁珠 | MB-0805A-102A10T | 2 |  |  |  |  | FB1，FB2 |  | 试产修改
35 | YM030160102 | 贴片IC | AT24C04/SO8 | 1 |  |  |  |  | U1
36 | YM030160114 | 贴片IC | IS62WV51216/TSOP-44 | 1 |  |  |  |  | U12 | 新物料
37 | YM030160088 | 贴片IC | PCA9306DC1/VSS0P8/NXP | 2 |  |  |  |  | U7，U8
38 | YM030160105 | 贴片IC | ADM483EARZ/SO8 | 2 |  |  |  |  | U6，U9
39 | YM030040008 | 贴片电感 | SWPA8040S220MT | 1 |  |  |  |  | L2
40 | YM030160094 | 贴片IC | LAN8720AI-CP-TR | 1 |  |  |  |  | U10
41 | YM030160096 | 贴片IC | APW7080KAI-TRG SOP-8P | 1 |  |  |  |  | U3
42 | YM030160035 | 贴片IC | SPX1117M3 SOT-223 | 1 |  |  |  |  | U5
43 | YM030160113 | 贴片IC | STM32F407ZGT6/LQPF144 | 1 |  |  |  |  | U4 | 新物料
44 | YM030160100 | 贴片IC | W25Q128FVSIG/SOP-8 | 1 |  |  |  |  | U2 | 描述上加了封装
45 | YM030050034 | TVS管 | ESD0603E002M12 0603 | 2 |  |  |  |  | TVS2，TVS3
46 | YM030050044 | TVS管 | SMBJ15CA | 1 |  |  |  |  | TVS1
47 | YM030050020 | 贴片二极管 | IN5819 | 5 |  |  |  |  | D1，D2，D3，D4，D5
48 | YM030060002 | 贴片三极管 | 2N5551（SOT-23） | 2 |  |  |  |  | Q1，Q2
插件物料
49 | YM030070009 | 晶振 | 25MHZ | 1 |  |  |  |  | Y3
50 | YM030070000 | 晶振 | 32.768MHZ | 1 |  |  |  |  | Y1
51 | YM030070015 | 晶振 | 8.0MHz/±10PPM(HC-49S) | 1 |  |  |  |  | Y2
52 | YM030140000 | 蜂鸣器 | BELL/DC 5V（9×5.0mm） | 1 |  |  |  |  | SP1
53 | YM030200011 | 纽扣电池座 | CR1220 | 1 |  |  |  |  | BT1
54 | YM030200022 | 纽扣电池 | 1220 | 1
55 | YM020050229 | 插接端子7P公座 | 间距5.08mm/长37.56mm/高度16mm/宽8.6mm/绿/第3针加长1mm | 2 |  |  |  |  | J2，J3 | 新物料
56 | YM03005031 | 发光二极管 | LED Φ3平顶绿发绿普亮 | 2 |  |  |  |  | LED2，LED3
57 | YM03005032 | 发光二极管 | LED Φ3平顶红发红普亮 | 1 |  |  |  |  | LED1
58 | YM030080045 | 贴片轻触开关 | 6×6×16.5mm | 3 |  |  |  |  | S2，S3，S4 |  | 试产修改
59 | YM03008034 | 贴片轻触开关 | 6×6×14mm | 1 |  |  |  |  | S1
60 | YM030190021 | RJ11接口 | 180度不带屏蔽/不带卡扣 | 2 |  |  |  |  | J6，J7 | 新物料 | 试产修改
61 | YM030190017 | RJ45接口 | RJ45接口 180°带滤波带灯 | 1 |  |  |  |  | J4
62 | YM030190007 | RJ45接口 | RJ45接口 180°带屏蔽 52-S-8C | 1 |  |  |  |  | J5
63 | YM030200218 | 单排双塑排针 | 脚距2.0mm/1PIN/针长15mm/中间高度6.5mm/180° | 2/40 |  |  |  |  | P3，P4 | 新物料 | 试产修改增加
64 | YM030200210 | 双排排针 | 2*19P间距2.0mm 中间高度6.5mm 针长15mm | 1 |  |  |  |  | P1 | 新物料
65 | 编制：余光英 2017-02-08 |  | 审核：江长胜 2017-02-08 |  |  |  |  | 批准：
 | 注：以上物料必须符合ROHS要求；
 |  |  | 删除了R8 10M电阻 C43，C54 4.7nF 电容
 |  |  | 将C11，C66，C67 10uF/10V贴片电容更改为2.2uF/10V

Sheet: MPDU 2017显示板
MA-PDU 2017显示板物料清单
No. | 物料编码 | 物料名称 | 规 格 型 号 | 数量（PCS） | 采购价格（元/RMB） |  | 计划价格（元/RMB） |  | 特别要求与说明 | 备 注
 |  |  |  |  | 单价 | 金额 | 单价 | 金额
1 | YM040070056 | 显示 PCB板 | 75.5mm*51mm*1.6 mm (L*W*H)、双面板、沉锡、铜厚1OZ、要求ROHS | 1 |  |  |  |  | MODEL：MPDU2017-XS. PCB REV：V2.0 DATE： 2017-06-12 | 升级
插件物料
3 | YM030180028 | 液晶显示屏 | FFC0.5-37P-A 2.8寸 | 1 |  |  |  |  | PA2.8 | 新物料 | 试产修改
5 | YM030200215 | 2.8寸排座 | 37P/间距0.5mm/翻盖/2.0mm高度/（0.5K-DX-37PWB） | 1 |  |  |  |  | PA2.8 | 新物料 | 试产修改
6
7 | 编制：余光英 2017-01-14 |  | 审核：江长胜 2017-01-14 |  |  |  |  | 批准：
 | 注：以上物料必须符合ROHS要求；公司标准产品是用的是2.8寸的显示屏和排座
 |  |  | 删除了2.4的显示屏和排座

Sheet: MPDU 2017主控板插接板
MPDU 2017主控板插接板产品物料清单
No. | 物料编码 | 物料名称 | 规 格 型 号 | 数量（PCS） | 采购价格（元/RMB） |  | 计划价格（元/RMB） |  | 特别要求与说明 | 备 注
 |  |  |  |  | 单价 | 金额 | 单价 | 金额
1 | YM040070063 | 插接 PCB板 | 50mm*48mm*1.6 mm (L*W*H)、双面板、沉锡、铜厚1OZ、要求ROHS | 1 |  |  |  |  | MODEL：MPDU 2017-ZJ-PCB REV：V 1.0 DATE：2017-04-01 | 升级
插件物料
2 | YM020050222 | 插接端子 | 7P母座 间距5.08 长37.48mm 高度19.5mm 宽8.5mm | 1 |  |  |  |  | J4 | 新物料
3 | YM030200221 | 4P插座 | 单排插座/4P/间距2.0mm/白色/90° | 2 |  |  |  |  | JP2，JP3 | 新物料 | 试产新增
4
5
6 | 编制：余光英 2017-04-20 |  | 审核：卢培森 2017-04-20 |  |  |  |  | 批准：
 | 注：以上物料必须符合ROHS要求； |  | 此物料清单为一块PCB板物料，每块主控板上需使用2块此PCB板。

Sheet: 滤波板
加固型智能钣金RPDU滤波板产品物料清单
No. | 物料编码 | 物料名称 | 规 格 型 号 | 数量（PCS） | 采购价格（元/RMB） |  | 计划价格（元/RMB） |  | 特别要求与说明 | 备 注
 |  |  |  |  | 单价 | 金额 | 单价 | 金额
1 | YM04010028 | 钣金滤波保护PCB板 | 49*42*2.0mm (L*W*H)、双层面板、(FR4)沉锡、铜厚2OZ、要求ROHS | 1 |  |  |  |  | MODEL：RPDU BOARD PCB REV：V1.0 DATE：2015-05-21
插件物料
2 | YM03003078 | 高压瓷片电容 | 400V/472M 封装脚间距为10mm | 2 |  |  |  |  | C1，C2
3 | YM03003079 | Y2电容 | MKP63300VASC103K(C43Q1103K6) | 2 |  |  |  |  | C3，C4
4 | YM02005085 | 电线接线端子 | ACTB011/额定电流45A/铜芯镀锡/尺寸11.1*9.2*10.5mm/螺丝∮4/高度8.5*6.8mm | 4 |  |  |  |  | N-in，N-out，L-in，L-out
5
6 | 编制：余光英 2017-04-20 |  | 审核：江长胜 2017-04-20 |  |  |  |  | 批准：
 | 注：以上物料必须符合ROHS要求；单相使用一块PCB，做三相产品的时候，此板需要使用2PCS。
