ChinaClever/CleverDoc/MPDU/MPDU 2017产品资料/BOM/MPDU2017-执行版/A0/12位C13+2位C19执行板物料清单/MPDU 2017产品系列12位C13+2位C19 A系列执行板物料清单.xlsx

Sheet: MPDU 2017执行板1
MPDU 2017 A系列执行板物料清单（12位C13+2位C19）
No. | 物料编码 | 物料名称 | 规 格 型 号 | 数量（PCS） | 采购价格（元/RMB） |  | 计划价格（元/RMB） |  | 特别要求与说明 | 备 注
 |  |  |  |  | 单价 | 金额 | 单价 | 金额
1 | YM040070062 | 执行主控 PCB板 | 335mm*46mm*1.6 mm (L*W*H)、双面板、沉锡、铜厚1OZ、要求ROHS | 1 |  |  |  |  | MODEL： MPDU 2017-ZX-12C13+2C19_1 REV：1.1 DATE：2017-04-01 | 升级
外发贴片物料
2 | YM030030054 | 贴片电容 | 0.1uF/50V 0603 ±10% | 6 |  |  |  |  | C1, C5, C9, C12, C18, C22
3 | YM030030063 | 贴片电容 | 10pF/50V 0603±0.25% | 4 |  |  |  |  | C10, C23, C41, C42
4 | YM030030021 | 贴片电容 | 10uF/16V 0805±10% | 6 |  |  |  |  | C2， C6， C7， C13， C19， C24
5 | YM030030069 | 贴片电容 | 15pF/25V 0603±5% | 4 |  |  |  |  | C3， C4， C15， C17
6 | YM030030058 | 贴片电容 | 33nF/50V 0603±10% | 8 |  |  |  |  | CA1， CA2， CA3， CA4， CB1， CB2， CB3， CB4
7 | YM030020098 | 贴片电阻 | 10Ω 0603 ±1% 1/10W | 2 |  |  |  |  | R31，R37
8 | YM030020091 | 贴片电阻 | 120Ω 0603±1%/1/10W | 4 |  |  |  |  | R53， R76， R78， R79
9 | YM030020090 | 贴片电阻 | 1KΩ 0603±1% 1/10W | 12 |  |  |  |  | R54, R77, R80, R81, RA1, RA2, RA3, RA4, RB1, RB2, RB3, RB4
10 | YM030020135 | 贴片电阻 | 200KΩ 0805±5%/1/8W | 28 |  |  |  |  | R17， R18， R19， R20， R21， R22， R23， R24， R25， R26， R27， R28， R29， R30， RA5， RA6， RA7， RA8， RA9， RA10， RA11， RB5， RB6， RB7， RB8， RB9， RB10， RB11
11 | YM030160109 | 贴片IC | RN8207C | 2 |  |  |  |  | U1，U3
12 | YM030160106 | 贴片光耦 | EL3H7（E）(TA)(D)--LG | 4 |  |  |  |  | US1， US3， US9， US10
插件物料
13 | YM030200211 | 双排双塑排针 | 脚距2.54mm/2*4PIN/针长17mm/中间高度11mm/180度 | 2 |  |  |  |  | J16，J18 | 新物料
14 | YM030200212 | 双排排母 | 脚距2.54mm/2*4PIN/塑料高度8.5mm/180度 | 5 |  |  |  |  | J7，J8，J9，J11，J12 | 新物料
15 | YM030200209 | 单排双塑排针 | 脚距2.0mm/1*40PIN/针长9.6mm/中间高度4mm/一端2mm,一端3.6mm/180度 | 4/40 |  |  |  |  | J14，J17 | 新物料
16 | YM030030064 | X高压电容 | 332/400V | 2 |  |  |  |  | CAP1，CAP2
17 | YM020050229 | 插接端子7P公座 | 间距5.08mm/长37.56mm/高度16mm/宽8.6mm/绿/第3针加长1mm | 2 |  |  |  |  | J2，J3 | 新物料 | 试产更改
18 | YM030200189 | 猛铜线 | D1.6*10*7mm/3mΩ ±1% | 12 |  |  |  |  | R2，R3，R4，R5，R6，R7，R8，R9，R10，R11，R12，R13
19 | YM010010126 | MPDU2017紫铜条 | 9.2mm/中间高度4mm/厚度2.5² | 9 |  |  |  |  | ZT1,ZT2，ZT3，ZZT4，ZT5，ZT6，ZT7,AC1,AC2
20 | YM030070006 | 晶振 | 3.579545MHz | 2 |  |  |  |  | Y1，Y3
21 | YM05002003 | 2.5平方线 | 2.5平方电子线（L，棕色，长度60mm） | 2 |  |  |  |  | AC3，AC5
22
23 | 编制：余光英 2017-01-14 |  | 审核：卢培森 2017-01-14 |  |  | 0 |  | 批准：
 | 注：以上物料必须符合ROHS要求；

Sheet: MPDU 2017执行板2
MPDU 2017 A系列执行板物料清单（12位C13+2位C19）
No. | 物料编码 | 物料名称 | 规 格 型 号 | 数量（PCS） | 采购价格（元/RMB） |  | 计划价格（元/RMB） |  | 特别要求与说明 | 备 注
 |  |  |  |  | 单价 | 金额 | 单价 | 金额
1 | YM040070052 | 执行主控 PCB板 | 220mm*41.1mm*1.6 mm (L*W*H)、双面板、沉锡、铜厚1OZ、要求ROHS | 1 |  |  |  |  | MODEL： MPDU 2017-ZX-12C13+2C19_2 REV：1.0 DATE：2017-01-13 | 新物料
外发贴片物料
2 | YM030030054 | 贴片电容 | 0.1uF/50V 0603 ±10% | 28 |  |  |  |  | C14， C21， C30， C32， C35， C39， C40， CC9， CC10， CC11， CC12， CD9， CD10， CD11， CD12， CE9， CE10， CE11， CE12， CF9， CF10， CF11， CF12， CV1， CV2， CV3， CV4， CV5
3 | YM030030067 | 贴片钽电容 | 100uF/10V 3528/±10% B型 | 5 |  |  |  |  | C16，C31， C34，C29， C33
4 | YM030030092 | 贴片钽电容 | 6032/22uF/±10%/25V/C型 | 1 |  |  |  |  | C38
5 | YM030030063 | 贴片电容 | 10pF/50V 0603±0.25% | 2 |  |  |  |  | C26， C27
6 | YM030030021 | 贴片电容 | 10uF/16V 0805±10% | 16 |  |  |  |  | CC13， CC14， CC15， CC16， CD13， CD14， CD15， CD16， CE13， CE14， CE15， CE16， CF13， CF14， CF15， CF16
7 | YM030030069 | 贴片电容 | 15pF/25V 0603±5% | 8 |  |  |  |  | CC17， CC18， CD17， CD18， CE17， CE18， CF17， CF18
8 | YM030030070 | 贴片电容 | 1uF/50V 0603±10% | 2 |  |  |  |  | C20， C28
9 | YM030030062 | 贴片电容 | 22pF/50V 0603±10% | 2 |  |  |  |  | C8，C11
10 | YM030030058 | 贴片电容 | 33nF/50V 0603±10% | 32 |  |  |  |  | CC1， CC2， CC3， CC4， CC5， CC6， CC7， CC8， CD1， CD2， CD3， CD4， CD5， CD6， CD7， CD8， CE1， CE2， CE3， CE4， CE5， CE6， CE7， CE8， CF1， CF2， CF3， CF4， CF5， CF6， CF7， CF8
11 | YM030020092 | 贴片电阻 | 33Ω 0603±1% 1/10W | 2 |  |  |  |  | R63，R65
12 | YM030020096 | 贴片电阻 | 51Ω 0603±1% 1/10W | 1 |  |  |  |  | R46
13 | YM030020090 | 贴片电阻 | 1KΩ 0603±1% 1/10W | 55 |  |  |  |  | R48， R50， R55， R58， R60， R62， R64， R66， R68， R70， R83， RC1， RC2， RC3， RC4， RC5， RC6， RC7， RC8， RC9， RC11， RC14， RD1， RD2， RD3， RD4， RD5， RD6， RD7， RD8， RD9， RD11， RD14， RE1， RE2， RE3， RE4， RE5， RE6， RE7， RE8， RE9， RE11， RE14， RF1， RF2， RF3， RF4， RF5， RF6， RF7， RF8， RF9， RF11， RF14
14 | YM030020088 | 贴片电阻 | 10KΩ 0603 ±1% 1/10W | 17 |  |  |  |  | R16， R32， R33， R36， R51， R52， R59， R67， R72， R73， R74， R75， RC12， RD12， RE12， RF12，R53
15 | YM030020098 | 贴片电阻 | 10Ω 0603 ±1% 1/10W | 4 |  |  |  |  | RC15， RD15， RE15， RF15
16 | YM030020091 | 贴片电阻 | 120Ω 0603±1%/1/10W | 8 |  |  |  |  | R47， R49， R56， R57， R61， R69， R71， R82
17 | YM030020099 | 贴片电阻 | 1MΩ 0603±1% 1/10W | 1 |  |  |  |  | R34
18 | YM030020134 | 贴片电阻 | 10M 0603±1% 1/10W | 4 |  |  |  |  | RC16， RD16， RE16， RF16
19 | YM030020104 | 贴片电阻 | 0Ω 0603±1% 1/10W | 4 |  |  |  |  | RC17， RD17， RE17， RF17
20 | YM030200101 | 贴片磁珠 | MB-0805A-601A20T | 2 |  |  |  |  | FB1，FB2
21 | YM030200111 | 贴片磁珠 | MB-0603A-600A30T | 1 |  |  |  |  | FB3
22 | YM030050020 | 贴片二极管 | IN5819 | 2 |  |  |  |  | D1，D2
23 | YM030160102 | 贴片IC | AT24C04/SO8 | 1 |  |  |  |  | U4
24 | YM030050041 | TVS管 | SMBJ7.0CA | 1 |  |  |  |  | TVS1
25 | YM030160105 | 贴片IC | ADM483EARZ/SO8 | 1 |  |  |  |  | U6
26 | YM030160035 | 贴片IC | SPX1117M3 SOT-223 | 2 |  |  |  |  | U8，U10
27 | YM030160043 | 稳压管 | 78M05/(TO-252） | 1 |  |  |  |  | U9
28 | YM030160112 | 贴片IC | STM32F103C8T6/ LQFP48 | 1 |  |  |  |  | U5 | 新物料
29 | YM030050015 | 贴片LED | 0805黄绿色 | 1 |  |  |  |  | LED9
插件物料
30 | YM030070015 | 晶振 | 8.0MHz/±10PPM(HC-49S) | 1 |  |  |  |  | Y2
31 | YM030200213 | 双排单塑排针 | 脚距2.54mm/2*4PIN/针长11mm/一端针长3mm/180度 | 5 |  |  |  |  | J9， J10， J13， J15， J22 | 新物料
32 | YM030120031 | 隔离电源 | B0505S-1WD/频率40KHz/转换效率85%/DIP-4 | 1 |  |  |  |  | U7
33
34
35
36
37 | 编制：余光英 2017-01-14 |  | 审核：卢培森 2017-01-14 |  |  | 0 |  | 批准：
 | 注：以上物料必须符合ROHS要求；

Sheet: MPDU 2017执行板C19焊接小板
MPDU 2017执行板C19焊接小板产品物料清单
No. | 物料编码 | 物料名称 | 规 格 型 号 | 数量（PCS） | 采购价格（元/RMB） |  | 计划价格（元/RMB） |  | 特别要求与说明 | 备 注
 |  |  |  |  | 单价 | 金额 | 单价 | 金额
1 | YM040070060 | 执行 PCB板 | 46mm*35.3mm*1.6 mm (L*W*H)、双面板、沉锡、铜厚1OZ、要求ROHS | 1 |  |  |  |  | MODEL：C19-1 REV：1.1 DATE：2017-04-01 | 升级
插件物料
4 | YM030200189 | 猛铜线 | D1.6*10*7mm/3mΩ ±1% | 2 |  |  |  |  | R1,R2
5
6
7 | 编制：余光英 2017-01-14 |  | 审核：卢培森 2017-01-14 |  |  |  |  | 批准：
 | 注：以上物料必须符合ROHS要求； |  | 此物料清单为一块PCB板物料，每块执行板上需使用2块此PCB板。

Sheet: MPDU 2017执行板插接板
MPDU 2017执行板插接板产品物料清单
No. | 物料编码 | 物料名称 | 规 格 型 号 | 数量（PCS） | 采购价格（元/RMB） |  | 计划价格（元/RMB） |  | 特别要求与说明 | 备 注
 |  |  |  |  | 单价 | 金额 | 单价 | 金额
1 | YM040070061 | 执行 PCB板 | 50mm*48mm*1.6 mm (L*W*H)、双面板、沉锡、铜厚1OZ、要求ROHS | 1 |  |  |  |  | MODEL：MPDU 2017-ZXLJ-PCB REV：1.1 DATE：2017-04-01 | 升级
插件物料
2 | YM020050222 | 插接端子7P母座 | 间距5.08mm/长37.48mm/高度16.5mm/宽8.5mm/绿 | 1 |  |  |  |  | J4 | 新物料
3 | YM030200221 | 4P插座 | 单排插座/4P/间距2.0mm/白色/90° | 2 |  |  |  |  | J1，J2 | 新物料 | 试产新增
4
5 | 编制：余光英 2017-04-20 |  | 审核：卢培森 2017-04-20 |  |  |  |  | 批准：
 | 注：以上物料必须符合ROHS要求； |  | 此物料清单为一块PCB板物料，每块执行板上需使用2块此PCB板。
