ChinaClever/CleverDoc/MPDU/MPDU 2017产品资料/BOM/MPDU2017-执行版/A0/4位C13+4位C19执行板物料清单/MPDU 2017产品系列4位C13+4位C19 B系列执行板物料清单.xlsx

Sheet: MPDU 2017执行板
MPDU 2017 B系列执行板物料清单（4位C13+4位C19）
No. | 物料编码 | 物料名称 | 规 格 型 号 | 数量（PCS） | 采购价格（元/RMB） |  | 计划价格（元/RMB） |  | 特别要求与说明 | 备 注
 |  |  |  |  | 单价 | 金额 | 单价 | 金额
1 | YM040070059 | 执行主控 PCB板 | 335mm*46mm*1.6 mm (L*W*H)、双面板、沉锡、铜厚1OZ、要求ROHS | 1 |  |  |  |  | MODEL： MPDU 2017-ZX-4C13+4C19 REV：1.1 DATE：2017-04-01 | 升级
外发贴片物料
2 | YM030030054 | 贴片电容 | 0.1uF/50V 0603 ±10% | 18 |  |  |  |  | C1， C5， C9， C12， C14， C18， C21， C22， C30， C32， C35， C39， C40， CV1， CV2， CV3， CV4， CV5
3 | YM030030067 | 贴片钽电容 | 100uF/10V 3528/±10% B型 | 5 |  |  |  |  | C16，C31， C34，C29， C33
4 | YM030030092 | 贴片钽电容 | 6032/22uF/±10%/25V/C型 | 1 |  |  |  |  | C38
5 | YM030030063 | 贴片电容 | 10pF/50V 0603±0.25% | 6 |  |  |  |  | C10， C23， C26， C27， C41， C42
6 | YM030030021 | 贴片电容 | 10uF/16V 0805±10% | 6 |  |  |  |  | C2， C6， C7， C13， C19， C24
7 | YM030030069 | 贴片电容 | 15pF/25V 0603±5% | 4 |  |  |  |  | C3， C4， C15， C17
8 | YM030030070 | 贴片电容 | 1uF/50V 0603±10% | 2 |  |  |  |  | C20， C28
9 | YM030030062 | 贴片电容 | 22pF/50V 0603±10% | 2 |  |  |  |  | C8，C11
10 | YM030030058 | 贴片电容 | 33nF/50V 0603±10% | 8 |  |  |  |  | CA1， CA2， CA3， CA4， CB1， CB2， CB3， CB4
11 | YM030020092 | 贴片电阻 | 33Ω 0603±1% 1/10W | 2 |  |  |  |  | R63，R65
12 | YM030020096 | 贴片电阻 | 51Ω 0603±1% 1/10W | 1 |  |  |  |  | R46
13 | YM030020090 | 贴片电阻 | 1KΩ 0603±1% 1/10W | 29 |  |  |  |  | R38， R39， R40， R41， R42， R43， R44， R45， R50， R54， R55， R58， R60， R62， R64， R66， R68， R70， R77， R80， R81， RA1， RA2， RA3， RA4， RB1， RB2， RB3， RB4
14 | YM030020088 | 贴片电阻 | 10KΩ 0603 ±1% 1/10W | 21 |  |  |  |  | R9， R10， R11， R12， R13， R14， R15， R16， R32， R33， R36， R51， R48，R52， R59， R67， R72， R73， R74， R75，R82
15 | YM030020098 | 贴片电阻 | 10Ω 0603 ±1% 1/10W | 2 |  |  |  |  | R31，R37
16 | YM030020091 | 贴片电阻 | 120Ω 0603±1%/1/10W | 10 |  |  |  |  | R49， R53， R56， R57， R61， R69， R71， R76， R78， R79
17 | YM030020099 | 贴片电阻 | 1MΩ 0603±1% 1/10W | 1 |  |  |  |  | R34
18 | YM030020135 | 贴片电阻 | 200KΩ 0805±5%/1/8W | 28 |  |  |  |  | R17， R18， R19， R20， R21， R22， R23， R24， R25， R26， R27， R28， R29， R30， RA5， RA6， RA7， RA8， RA9， RA10， RA11， RB5， RB6， RB7， RB8， RB9， RB10， RB11 | 新物料
19 | YM030200111 | 贴片磁珠 | MB-0603A-600A30T | 1 |  |  |  |  | FB3
20 | YM030200101 | 贴片磁珠 | MB-0805A-601A20T | 2 |  |  |  |  | FB1，FB2
21 | YM030160109 | 贴片IC | RN8207C | 2 |  |  |  |  | U1，U3
22 | YM030050020 | 贴片二极管 | IN5819 | 2 |  |  |  |  | D1，D2
23 | YM030160102 | 贴片IC | AT24C04/SO8 | 1 |  |  |  |  | U4
24 | YM030050041 | TVS管 | SMBJ7.0CA | 1 |  |  |  |  | TVS1
25 | YM030160105 | 贴片IC | ADM483EARZ/SO8 | 1 |  |  |  |  | U6
26 | YM030160035 | 贴片IC | SPX1117M3 SOT-223 | 2 |  |  |  |  | U8，U10
27 | YM030160043 | 稳压管 | 78M05/(TO-252） | 1 |  |  |  |  | U9
28 | YM030160112 | 贴片IC | STM32F103C8T6/ LQFP48 | 1 |  |  |  |  | U5 | 新物料
29 | YM030050015 | 贴片LED | 0805黄绿色 | 1 |  |  |  |  | LED9
30 | YM030160106 | 贴片光耦 | EL3H7（E）(TA)(D)--LG | 7 |  |  |  |  | US1， US3， US5， US6， US8， US9， US10
31 | YM030160115 | 贴片光耦 | IS281 GB/SSOP | 3 |  |  |  |  | US2，US4， US7， | 新物料 | 试产更改
插件物料
32 | YM030120031 | 隔离电源 | B0505S-1WD/频率40KHz/转换效率85%/DIP-4 | 1 |  |  |  |  | U7
33 | YM030200209 | 单排双塑排针 | 脚距2.0mm/1*40PIN/针长9.6mm/中间高度4mm/一端2mm,一端3.6mm/180度 | 16/40 |  |  |  |  | J10，J11，J12，J13，J14，J15，J16，J17 | 新物料
34 | YM030030064 | X高压电容 | 332/400V | 2 |  |  |  |  | CAP1，CAP2
35 | YM020050229 | 插接端子7P公座 | 间距5.08mm/长37.56mm/高度16mm/宽8.6mm/绿/第3针加长1mm | 2 |  |  |  |  | J2，J3 | 新物料 | 试产更改
36 | YM030200189 | 猛铜线 | D1.6*10*7mm/3mΩ ±1% | 4 |  |  |  |  | R3，R4，R5，R6
37 | YM010010126 | MPDU2017紫铜条 | 9.2mm/中间高度4mm/厚度2.5² | 15 |  |  |  |  | ZT1，ZT2，ZT3，ZZT4，ZT5，ZT6，ZT7，ZT8，ZT9，ZT10，ZT11，ZT12，ZT13，ZT14，ZT15 | 新物料
38 | YM030070006 | 晶振 | 3.579545MHz | 2 |  |  |  |  | Y1，Y3
39 | YM030070015 | 晶振 | 8.0MHz/±10PPM(HC-49S) | 1 |  |  |  |  | Y2
40 | 编制：余光英 2017-01-14 |  | 审核：卢培森 2017-01-14 |  |  | 0 |  | 批准：
 | 注：以上物料必须符合ROHS要求；
 |  |  | U2 | 取消
 |  |  | LED1，LED2，LED3，LED4，LED5，LED6，LED7，LED8 | 取消
 |  |  | K3， K4， K5， K6 | 取消

Sheet: MPDU 2017执行板采集板
MPDU 2017执行板采集板产品物料清单
No. | 物料编码 | 物料名称 | 规 格 型 号 | 数量（PCS） | 采购价格（元/RMB） |  | 计划价格（元/RMB） |  | 特别要求与说明 | 备 注
 |  |  |  |  | 单价 | 金额 | 单价 | 金额
1 | YM040070049 | 执行 PCB板 | 26.9mm*19mm*1.6 mm (L*W*H)、四层板、沉锡、铜厚1OZ、要求ROHS | 1 |  |  |  |  | MODEL：RN-7302 REV：1.0 DATE：2017-01-13 | 新物料
外发贴片物料
2 | YM030030054 | 贴片电容 | 0.1uF/50V 0603 ±10% | 4 |  |  |  |  | C4，C12，C36，C38
3 | YM030030069 | 贴片电容 | 15pF/25V 0603±5% | 2 |  |  |  |  | C17，C20
4 | YM030030021 | 贴片电容 | 10uF/16V 0805±10% | 4 |  |  |  |  | C2，C10，C16，C37
5 | YM030030058 | 贴片电容 | 33nF/50V 0603±10% | 10 |  |  |  |  | C1， C6， C9， C13， C19， C21， C24， C25， C26， C64
6 | YM030020100 | 贴片电阻 | 100KΩ 0603±1% 1/10W | 1 |  |  |  |  | R15
7 | YM030020134 | 贴片电阻 | 10M 0603±1% 1/10W | 1 |  |  |  |  | R24
8 | YM030020098 | 贴片电阻 | 10Ω 0603±1% 1/10W | 1 |  |  |  |  | R44
9 | YM030160107 | 贴片IC | RN7302 LQFP32 | 1 |  |  |  |  | U3
10 | YM030020104 | 贴片电阻 | 0Ω 0603±1% 1/10W | 4 |  |  |  |  | R45， R46，R6， R68
11 | YM030020090 | 贴片电阻 | 1KΩ 0603±1% 1/10W | 13 |  |  |  |  | R4， R7， R8， R10， R11， R19， R21， R28， R30， R69， R70，R66，R67
插件物料
13 | YM030070012 | 晶振 | 8.192MHZ | 1 |  |  |  |  | Y2
14
15 | 编制：余光英 2017-01-14 |  | 审核：卢培森 2017-01-14 |  |  |  |  | 批准：
 | 注：以上物料必须符合ROHS要求； |  | 此物料清单为一块PCB板物料，每块执行板上需使用2块此PCB板。

Sheet: MPDU 2017执行板C19焊接小板
MPDU 2017执行板C19焊接小板产品物料清单
No. | 物料编码 | 物料名称 | 规 格 型 号 | 数量（PCS） | 采购价格（元/RMB） |  | 计划价格（元/RMB） |  | 特别要求与说明 | 备 注
 |  |  |  |  | 单价 | 金额 | 单价 | 金额
1 | YM040070060 | 执行 PCB板 | 46mm*35.3mm*1.6 mm (L*W*H)、双面板、沉锡、铜厚1OZ、要求ROHS | 1 |  |  |  |  | MODEL：C19-1 REV：1.1 DATE：2017-04-01 | 升级
插件物料
3 | YM030200189 | 猛铜线 | D1.6*10*7mm/3mΩ ±1% | 1 |  |  |  |  | R1
4
5
6 | 编制：余光英 2017-01-14 |  | 审核：卢培森 2017-01-14 |  |  |  |  | 批准：
 | 注：以上物料必须符合ROHS要求； |  | 此物料清单为一块PCB板物料，每块执行板上需使用4块此PCB板。

Sheet: MPDU 2017执行板插接板
MPDU 2017执行板插接板产品物料清单
No. | 物料编码 | 物料名称 | 规 格 型 号 | 数量（PCS） | 采购价格（元/RMB） |  | 计划价格（元/RMB） |  | 特别要求与说明 | 备 注
 |  |  |  |  | 单价 | 金额 | 单价 | 金额
1 | YM040070061 | 执行 PCB板 | 50mm*48mm*1.6 mm (L*W*H)、双面板、沉锡、铜厚1OZ、要求ROHS | 1 |  |  |  |  | MODEL：MPDU 2017-ZXLJ-PCB REV：1.1 DATE：2017-04-01 | 升级
插件物料
2 | YM020050222 | 插接端子7P母座 | 间距5.08mm/长37.48mm/高度16.5mm/宽8.5mm/绿 | 1 |  |  |  |  | J4 | 新物料
3 | YM030200221 | 4P插座 | 单排插座/4P/间距2.0mm/白色/90° | 2 |  |  |  |  | J1，J2 | 新物料 | 试产新增
4
5 | 编制：余光英 2017-04-20 |  | 审核：卢培森 2017-04-20 |  |  |  |  | 批准：
 | 注：以上物料必须符合ROHS要求； |  | 此物料清单为一块PCB板物料，每块执行板上需使用2块此PCB板。
