ChinaClever/CleverDoc/MPDU/MPDU 2017产品资料/BOM/外发物料清单/外发插件/B系列/MPDU 2017产品系列12位C13+2位C19 B系列执行板物料清单.xlsx

Sheet: MPDU 2017执行板1
MPDU 2017 B系列执行板物料清单（12位C13+2位C19）
No. | 物料编码 | 物料名称 | 规 格 型 号 | 数量（PCS） | 采购价格（元/RMB） |  | 计划价格（元/RMB） |  | 特别要求与说明 | 备 注
 |  |  |  |  | 单价 | 金额 | 单价 | 金额
1 | YM040070062 | 执行主控 PCB板 | 335mm*46mm*1.6 mm (L*W*H)、双面板、沉锡、铜厚1OZ、要求ROHS | 1 |  |  |  |  | MODEL： MPDU 2017-ZX-12C13+2C19_1 REV：1.1 DATE：2017-04-01 | 升级
插件物料
2 | YM030200211 | 双排双塑排针 | 脚距2.54mm/2*4PIN/针长17mm/中间高度11mm/180度 | 2 |  |  |  |  | J16，J18 | 新物料
3 | YM030200212 | 双排排母 | 脚距2.54mm/2*4PIN/塑料高度8.5mm/180度 | 5 |  |  |  |  | J7，J8，J9，J11，J12 | 新物料
4 | YM030200209 | 单排双塑排针 | 脚距2.0mm/1*40PIN/针长9.6mm/中间高度4mm/一端2mm,一端3.6mm/180度 | 4/40 |  |  |  |  | J14，J17 | 新物料
5 | YM020050229 | 插接端子7P公座 | 间距5.08mm/长37.56mm/高度16mm/宽8.6mm/绿/第3针加长1mm | 2 |  |  |  |  | J2，J3 | 新物料 | 试产更改
6 | YM030200189 | 猛铜线 | D1.6*10*7mm/3mΩ ±1% | 12 |  |  |  |  | R2，R3，R4，R5，R6，R7，R8，R9，R10，R11，R12，R13
7 | YM010010126 | MPDU2017紫铜条 | 9.2mm/中间高度4mm/厚度2.5² | 7 |  |  |  |  | ZT1,ZT2，ZT3，ZZT4，ZT5，ZT6，ZT7
8 | YM030070006 | 晶振 | 3.579545MHz | 2 |  |  |  |  | Y1，Y3
9 | 编制：余光英 2017-01-14 |  | 审核：卢培森 2017-01-14 |  |  | 0 |  | 批准：
 | 注：以上物料必须符合ROHS要求；

Sheet: MPDU 2017执行板2
MPDU 2017 B系列执行板物料清单（12位C13+2位C19）
No. | 物料编码 | 物料名称 | 规 格 型 号 | 数量（PCS） | 采购价格（元/RMB） |  | 计划价格（元/RMB） |  | 特别要求与说明 | 备 注
 |  |  |  |  | 单价 | 金额 | 单价 | 金额
1 | YM040070052 | 执行主控 PCB板 | 220mm*41.1mm*1.6 mm (L*W*H)、双面板、沉锡、铜厚1OZ、要求ROHS | 1 |  |  |  |  | MODEL： MPDU 2017-ZX-12C13+2C19_2 REV：1.0 DATE：2017-01-13 | 新物料
插件物料
2 | YM030070015 | 晶振 | 8.0MHz/±10PPM(HC-49S) | 1 |  |  |  |  | Y2
3 | YM030070012 | 晶振 | 8.192MHZ | 4 |  |  |  |  | Y4， Y5， Y6， Y7
4 | YM030200213 | 双排单塑排针 | 脚距2.54mm/2*4PIN/针长11mm/一端针长3mm/180度 | 5 |  |  |  |  | J9， J10， J13， J15， J22 | 新物料
5 | YM030120031 | 隔离电源 | B0505S-1WD/频率40KHz/转换效率85%/DIP-4 | 1 |  |  |  |  | U7
6
7 | 编制：余光英 2017-01-14 |  | 审核：卢培森 2017-01-14 |  |  | 0 |  | 批准：
 | 注：以上物料必须符合ROHS要求；

Sheet: MPDU 2017执行板C19焊接小板
MPDU 2017执行板C19焊接小板产品物料清单
No. | 物料编码 | 物料名称 | 规 格 型 号 | 数量（PCS） | 采购价格（元/RMB） |  | 计划价格（元/RMB） |  | 特别要求与说明 | 备 注
 |  |  |  |  | 单价 | 金额 | 单价 | 金额
1 | YM040070060 | 执行 PCB板 | 46mm*35.3mm*1.6 mm (L*W*H)、双面板、沉锡、铜厚1OZ、要求ROHS | 1 |  |  |  |  | MODEL：C19-1 REV：1.1 DATE：2017-04-01 | 升级
插件物料
2 | YM030200189 | 猛铜线 | D1.6*10*7mm/3mΩ ±1% | 1 |  |  |  |  | R1
3
4
5 | 编制：余光英 2017-01-14 |  | 审核：卢培森 2017-01-14 |  |  |  |  | 批准：
 | 注：以上物料必须符合ROHS要求； |  | 此物料清单为一块PCB板物料，每块执行板上需使用2块此PCB板。

Sheet: MPDU 2017执行板插接板
MPDU 2017执行板插接板产品物料清单
No. | 物料编码 | 物料名称 | 规 格 型 号 | 数量（PCS） | 采购价格（元/RMB） |  | 计划价格（元/RMB） |  | 特别要求与说明 | 备 注
 |  |  |  |  | 单价 | 金额 | 单价 | 金额
1 | YM040070061 | 执行 PCB板 | 50mm*48mm*1.6 mm (L*W*H)、双面板、沉锡、铜厚1OZ、要求ROHS | 1 |  |  |  |  | MODEL：MPDU 2017-ZXLJ-PCB REV：1.1 DATE：2017-04-01 | 升级
插件物料
2 | YM020050222 | 插接端子7P母座 | 间距5.08mm/长37.48mm/高度16.5mm/宽8.5mm/绿 | 1 |  |  |  |  | J4 | 新物料
3 | YM030200221 | 4P插座 | 单排插座/4P/间距2.0mm/白色/90° | 2 |  |  |  |  | J1，J2 | 新物料 | 试产新增
4
5 | 编制：余光英 2017-04-20 |  | 审核：卢培森 2017-04-20 |  |  |  |  | 批准：
 | 注：以上物料必须符合ROHS要求； |  | 此物料清单为一块PCB板物料，每块执行板上需使用2块此PCB板。
