ChinaClever/CleverDoc/MPDU/MPDU 2017产品资料/BOM/结构物料清单/基本母线模组/三相32A-2SRDSRMP35000/三相32A基本母线模组结构部分物料清单.xlsx

MPDU 2017 三相32A基本母线模组结构部分物料清单
No. | 物料编码 | 物料名称 | 规 格 型 号 | 数量 | 单位（PCS） | 采购价格（元/RMB） |  | 计划价格（元/RMB） |  | 特别要求与说明 | 备 注 | 物料类别
 |  |  |  |  |  | 单价 | 金额 | 单价 | 金额
1 | YM010040151 | 2017智能产品面壳4（三相32A输入） |  | 1 | PCS |  |  |  |  | 需丝印 |  | 钣金
2 | YM010040155 | 2017智能产品转接件1 |  | 1 | PCS
3 | YM010040157 | 2017智能产品转接件3 |  | 1 | PCS
4 | YM010040156 | 2017智能产品转接件2 |  | 3 | PCS
5 | YM010040145 | 2017智能产品底壳 |  | 1 | PCS
6 | YM010040158 | 2017智能产品控制模组遮线板 |  | 1 | PCS
7 | YM010050449 | MPDU2017进线端固定板 |  | 1 | PCS
8 | YM010050448 | MPDU2017尾端固定板 |  | 1 | PCS
9 | YM010040181 | 2017智能产品接线盖 |  | 1 | PCS
10 | YM06003084 | 加固型智能RPDU输入PCB绝缘纸 | 98.4 X 51.4 X 0.5 mm | 2 | PCS |  |  |  |  |  |  | 绝缘纸
11 | YM060030125 | MPDU2017电源PCB绝缘纸 | 120*85*0.5mm | 1 | PCS
12 | YM060030128 | MPDU2017进线端断路器绝缘纸 | 400 X 84 X 0.5 mm | 1 | PCS
13 | YM060030129 | MPDU2017输出模组接线板绝缘纸 | 79 X 70 X 0.5 mm | 6 | PCS
14 | YM060030130 | MPDU2017控制模组接线板绝缘纸 | 79 X 70 X 0.5 mm | 2 | PCS
15 | YM060030131 | MPDU2017底座遮线绝缘纸 | 35*71.5*0.5mm | 3 | PCS
16 | YM030100196 | B2R6 16A液压断路器（定制丝印） |  | 6 | PCS |  |  |  |  |  |  | 断路器
17 | YM050020001 | 12AWG电子线（N，一端环形端子） |  | 450 | mm
18 | YM050020001 | 12AWG电子线（N） |  | 240 | mm
19 | YM050020001 | 12AWG电子线（N） |  | 390 | mm
20 | YM050020001 | 12AWG电子线（N） |  | 240 | mm
21 | YM050020001 | 12AWG电子线（N） |  | 145 | mm
22 | YM050020001 | 12AWG电子线（N） |  | 240 | mm
23 | YM05002079 | 14AWG电子线（L，黑色，俩端环形端子 180mm） |  | 2 | PCS
24 | YM05002003 | 14AWG电子线（L，棕色，俩端环形端子 250mm） |  | 2 | PCS
25 | YM05002080 | 14AWG电子线（L，灰色，俩端环形端子 320mm） |  | 2 | PCS
26 | YM05002079 | 14AWG电子线（L，黑色，一端环形端子） |  | 270 | mm
27 | YM05002079 | 14AWG电子线（L，黑色，一端环形端子） |  | 510 | mm
28 | YM05002003 | 14AWG电子线（L，棕色，一端环形端子） |  | 810 | mm
29 | YM05002003 | 14AWG电子线（L，棕色，一端环形端子） |  | 1040 | mm
30 | YM05002080 | 14AWG电子线（L，灰色，一端环形端子） |  | 1120 | mm
31 | YM05002080 | 14AWG电子线（L，灰色，一端环形端子） |  | 1600 | mm
32 | YM05002012 | 22AWG电子线（红 400mm） |  | 1 | PCS
33 | YM05002013 | 22AWG电子线（ 蓝，400mm） |  | 1 | PCS
34 | YM050030044 | 排线（230mm） | 扁平双头/4P/花白/同向 | 3 | PCS
35 | YM050030045 | 排线（130mm） | 扁平双头/4P//花白/同向 | 1 | PCS
36 | YM050030046 | 排线（90mm） | 扁平双头/4P/花白/同向 | 2 | PCS
37 | YM050030047 | 排线（170mm） | 扁平双头/4P/花白/同向 | 1 | PCS
38 | YM020000113 | M3*4 十字平头细丝螺丝 黑色 |  | 52 | PCS |  |  |  |  |  |  | 合壳
39 | YM020000029 | 6-32十字平头粗牙螺丝 黑色 |  | 8 | PCS |  |  |  |  |  |  | 锁固定板
40 | YM02003018 | M3机牙圆头十字螺丝（带垫片） |  | 38 | PCS |  |  |  |  |  |  | 锁PCB板
41 | YM060030001 | φ5热收缩套管 |  | 200 | mm
42 | YM060030036 | φ4热收缩套管 |  | 100 | mm
43 | YM010050102 | 可拆卸挂钉 |  | 2 | PCS
44 | YM02000086 | 锁挂钉螺丝 |  | 2 | PCS
45 | YM020000102 | 接线板堆叠铜螺柱 |  | 2 | PCS
46 | YM030120047 | 开关电源 |  | 1 | PCS
47 |  | 工时
48 | 价格合计（元/RMB） |  |  |  |  | 采购 |  |  | 计划
编制：肖 然 2017/04/26 |  |  | 审核：刘 轶 2017/04/26 |  |  |  | 批准：
 | *以上物料必须符合ROHS环保要求；
