ChinaClever/CleverDoc/MPDU/MPDU 2017产品资料/产品移交资料清单.docx

产品移交资料清单

项目名称 | MPDU 2017
序号 | 移交资料 | 责任人 | 移交人 | 接收人 | 接收时间 | 完成情况
| MPDU 2017技术要求
| MPDU 2017使用说明书
| MPDU 2017电路图
| MPDU 2017PCB元件图
| MPDU 2017调试方法/校准软件
| MPDU 2017生产注意事项
| MPDU 2017测试规范
| MPDU 2017检验规范
| MPDU 2017物料清单
| MPDU 2017测试计划、日志及用例
| MPDU 2017样品测试报告
| MPDU 2017作业指导书
| MPDU 2017包装图纸及包装工艺
| MPDU 2017订单评审规格书
| MPDU 2017主控板软件
| MPDU 2017执行板软件
| MPDU 2017编码规则
