ChinaClever/CleverDoc/MPDU/MPDU 2017产品资料/MPDU 2017成品二级三级物料编码.xlsx

Sheet: 二级物料编码
二级物料编码（
序号 | 编码 | 名称
1 | 2ZN1YLMPV0D00 | MPDU 2017D系列执行板模块4位C13+4位C19(D1-8)
2 | 2ZN1YLMPV0D01 | MPDU 2017D系列执行板模块4位C13+4位C19(D9-16)
3 | 2ZN1YLMPV0D02 | MPDU 2017D系列执行板模块4位C13+4位C19(D17-24)
4 | 2ZN1YLMPV0D03 | MPDU 2017D系列执行板模块6位C13+2位C19(D1-8)
5 | 2ZN1YLMPV0D04 | MPDU 2017D系列执行板模块6位C13+2位C19(D9-16)
6 | 2ZN1YLMPV0D05 | MPDU 2017D系列执行板模块6位C13+2位C19(D17-24)
7 | 2ZN1YLMPV0D06 | MPDU 2017D系列执行板模块7位C13+1位C19(D1-8)
8 | 2ZN1YLMPV0D07 | MPDU 2017D系列执行板模块7位C13+1位C19(D9-16)
9 | 2ZN1YLMPV0D08 | MPDU 2017D系列执行板模块7位C13+1位C19(D17-24)
10 | 2ZN1YLMPV0B00 | MPDU 2017B系列执行板模块12位C13+2位C19(B1-14)
11 | 2ZN1YLMPV0B01 | MPDU 2017B系列执行板模块12位C13+2位C19(B15-28)
12 | 2ZN1YLMPV0B02 | MPDU 2017B系列执行板模块12位C13+2位C19(B29-42)
13 | 2ZN1YLMPV0B03 | MPDU 2017B系列执行板模块4位C13+4位C19(B1-8) | 2017-4-21新增
14 | 2ZN1YLMPV0B04 | MPDU 2017B系列执行板模块4位C13+4位C19(B9-16)
15 | 2ZN1YLMPV0B05 | MPDU 2017B系列执行板模块4位C13+4位C19(B17-24)
16 | 2ZN1YLMPV0B06 | MPDU 2017B系列执行板模块6位C13+2位C19(B1-8)
17 | 2ZN1YLMPV0B07 | MPDU 2017B系列执行板模块6位C13+2位C19(B9-16)
18 | 2ZN1YLMPV0B08 | MPDU 2017B系列执行板模块6位C13+2位C19(B17-24)
19 | 2ZN1YLMPV0B09 | MPDU 2017B系列执行板模块7位C13+1位C19(B1-8)
20 | 2ZN1YLMPV0B10 | MPDU 2017B系列执行板模块7位C13+1位C19(B9-16)
21 | 2ZN1YLMPV0B11 | MPDU 2017B系列执行板模块7位C13+1位C19(B17-24)
22 | 2ZN1YLMPV0A00 | MPDU 2017A系列执行板模块12位C13+2位C19(A1-14)
23 | 2ZN1YLMPV0A01 | MPDU 2017A系列执行板模块12位C13+2位C19(A15-28)
24 | 2ZN1YLMPV0A02 | MPDU 2017A系列执行板模块12位C13+2位C19(A29-42)
25 | 2ZN1YLMPV0A03 | MPDU 2017A系列执行板模块4位C13+4位C19(A1-8) | 2017-4-21新增
26 | 2ZN1YLMPV0A04 | MPDU 2017A系列执行板模块4位C13+4位C19(A9-16)
27 | 2ZN1YLMPV0A05 | MPDU 2017A系列执行板模块4位C13+4位C19(A17-24)
28 | 2ZN1YLMPV0A06 | MPDU 2017A系列执行板模块6位C13+2位C19(A1-8)
29 | 2ZN1YLMPV0A07 | MPDU 2017A系列执行板模块6位C13+2位C19(A9-16)
30 | 2ZN1YLMPV0A08 | MPDU 2017A系列执行板模块6位C13+2位C19(A17-24)
31 | 2ZN1YLMPV0A09 | MPDU 2017A系列执行板模块7位C13+1位C19(A1-8)
32 | 2ZN1YLMPV0A10 | MPDU 2017A系列执行板模块7位C13+1位C19(A9-16)
33 | 2ZN1YLMPV0A11 | MPDU 2017A系列执行板模块7位C13+1位C19(A17-24)
34 | 2ZN1TMMPV0T00 | MPDU 2017单三相通用主控模块
35 | 2ZN1YLMPV0C00 | MPDU 2017C系列执行板模块4位C13+4位C19(C1-8)
36 | 2ZN1YLMPV0C01 | MPDU 2017C系列执行板模块4位C13+4位C19(C9-16)
37 | 2ZN1YLMPV0C02 | MPDU 2017C系列执行板模块4位C13+4位C19(C17-24)
38 | 2ZN1YLMPV0C03 | MPDU 2017C系列执行板模块6位C13+2位C19(C1-8)
39 | 2ZN1YLMPV0C04 | MPDU 2017C系列执行板模块6位C13+2位C19(C9-16)
40 | 2ZN1YLMPV0C05 | MPDU 2017C系列执行板模块6位C13+2位C19(C17-24)
41 | 2ZN1YLMPV0C06 | MPDU 2017C系列执行板模块7位C13+1位C19(C1-8)
42 | 2ZN1YLMPV0C07 | MPDU 2017C系列执行板模块7位C13+1位C19(C9-16)
43 | 2ZN1YLMPV0C08 | MPDU 2017C系列执行板模块7位C13+1位C19(C17-24)
44 | 2SRDSRMP15000 | MPDU 2017 32A底座模块
45 | 2SRDSRMP18000 | MPDU 2017 63A底座模块
46 | 2SRDSRMP32000 | MPDU 2017 3*16A底座模块
47 | 2SRDSRMP35000 | MPDU 2017 3*32A底座模块

Sheet: 三级物料编码
三级物料（包含PCB和外发贴片）
1 | 3JKPCDY001000 | MPDU 2017D系列执行采集板
2 | 3JKPEDY001000 | MPDU 2017 D系列执行板（4位C13+4位C19）
3 | 3JKPEDY001001 | MPDU 2017 D系列执行板（6位C13+2位C19）
4 | 3JKPEDY001002 | MPDU 2017 D系列执行板（7位C13+1位C19）
5 | 3JKPEBY001000 | MPDU 2017 B系列执行板1（12位C13+2位C19）
6 | 3JKPEBY001001 | MPDU 2017 B系列执行板2（12位C13+2位C19）
7 | 3JKPEBY001002 | MPDU 2017 B系列执行板（4位C13+4位C19） | 2017-4-20新增
8 | 3JKPEBY001003 | MPDU 2017 B系列执行板（6位C13+2位C19）
9 | 3JKPEBY001004 | MPDU 2017 B系列执行板（7位C13+1位C19）
10 | 3JKPEAY001000 | MPDU 2017 A系列执行板1（12位C13+2位C19）
11 | 3JKPEAY001001 | MPDU 2017 A系列执行板2（12位C13+2位C19）
12 | 3JKPEAY001002 | MPDU 2017 A系列执行板（4位C13+4位C19） | 2017-4-20新增
13 | 3JKPEAY001003 | MPDU 2017 A系列执行板（6位C13+2位C19）
14 | 3JKPEAY001004 | MPDU 2017 A系列执行板（7位C13+1位C19）
15 | 3JKPECY001000 | MPDU 2017 C系列执行板（4位C13+4位C19）
16 | 3JKPECY001001 | MPDU 2017 C系列执行板（6位C13+2位C19）
17 | 3JKPECY001002 | MPDU 2017 C系列执行板（7位C13+1位C19）
18 | 3JKPZTWYL0400 | MPDU 2017单三相通用主控板
19 | 3JKPZTWYL0401 | MPDU 2017单三相通用主控板外发插件 | 2017-06-03
20 | 3JKPEAY001005 | MPDU 2017 A系列执行板（7位C13+1位C19）外发插件
21 | 3JKPEAY001006 | MPDU 2017 A系列执行板（6位C13+2位C19）外发插件
22 | 3JKPEBY001005 | MPDU 2017 B系列执行板（7位C13+1位C19）外发插件
23 | 3JKPEBY001006 | MPDU 2017 B系列执行板（6位C13+2位C19）外发插件
24 | 3JKPECY001003 | MPDU 2017 C系列执行板（7位C13+1位C19）外发插件
25 | 3JKPECY001004 | MPDU 2017 C系列执行板（6位C13+2位C19）外发插件
26 | 3JKPEDY001003 | MPDU 2017 D系列执行板（7位C13+1位C19）外发插件
27 | 3JKPEDY001004 | MPDU 2017 D系列执行板（6位C13+2位C19）外发插件
28
29
30
31

Sheet: 成品物料编码
MPDU 2017成品编码清单
No. | 产品 | 规格型号 | 基本描述 | 单位 | 最新成品物料编码
 | 系列
1. | A系列 | MA 1324-2103 | IEC-60309单相32A输入，21位C13和3位C19插座输出 | 台 | J1BJ7LC3E00A201CN5F1829000
2. |  | MA 1324-1806 | IEC-60309单相32A输入，18位C13和6位C19插座输出 | 台 | J1BJ7IC6E00A201CN5F1829000
3. |  | MA 1324-2004 | IEC-60309单相32A输入，20位C13和4位C19插座输出 | 台 | J1BJ7KC4E00A201CN5F1829000
4. |  | MA 1342-3606 | IEC-60309单相32A输入，36位C13和6位C19插座输出 | 台 | J1BJ7ZC1C6EA201CN5F1829000
5. |  | MA 1624-2103 | IEC-60309单相63A输入，21位C13和3位C19插座输出 | 台 | J1BJALC3E00A201CN711829000
6. |  | MA 1624-1806 | IEC-60309单相63A输入，18位C13和6位C19插座输出 | 台 | J1BJAIC6E00A201CN711829000
7. |  | MA 1624-2004 | IEC-60309单相63A输入，20位C13和4位C19插座输出 | 台 | J1BJAKC4E00A201CN711829000
8. |  | MA 1642-3606 | IEC-60309单相63A输入，36位C13和6位C19插座输出 | 台 | J1BJAZC1C6EA201CN711829000
9. |  | MA 3124-2103 | IEC-60309三相16A输入，21位C13和3位C19插座输出 | 台 | J1BJ4LC3E00A20JCN8J1829000
10. |  | MA 3124-1806 | IEC-60309三相16A输入，18位C13和6位C19插座输出 | 台 | J1BJ4IC6E00A20JCN8J1829000
11. |  | MA 3124-2004 | IEC-60309三相16A输入，20位C13和4位C19插座输出 | 台 | J1BJ4KC4E00A20JCN8J1829000
12. |  | MA 3142-3606 | IEC-60309三相16A输入，36位C13和6位C19插座输出 | 台 | J1BJ4ZC1C6EA20JCN8J1829000
13. |  | MA 3324-2103 | IEC-60309三相32A输入，21位C13和3位C19插座输出 | 台 | J1BJ7LC3E00A20JCNAK1829000
14. |  | MA3324-1806 | IEC-60309三相32A输入，18位C13和6位C19插座输出 | 台 | J1BJ7IC6E00A20JCNAK1829000
15. |  | MA 3324-2004 | IEC-60309三相32A输入，20位C13和4位C19插座输出 | 台 | J1BJ7KC4E00A20JCNAK1829000
16. |  | MA 3342-3606 | IEC-60309三相32A输入，36位C13和6位C19插座输出 | 台 | J1BJ7ZC1C6EA20JCNAK1829000
17. | B系列 | MB 1324-2103 | IEC-60309单相32A输入，21位C13和3位C19插座输出 | 台 | J1BJ7LC3E00B201CN5F1829000
18. |  | MB 1324-1806 | IEC-60309单相32A输入，18位C13和6位C19插座输出 | 台 | J1BJ7IC6E00B201CN5F1829000
19. |  | MB 1324-2004 | IEC-60309单相32A输入，20位C13和4位C19插座输出 | 台 | J1BJ7KC4E00B201CN5F1829000
20. |  | MB 1342-3606 | IEC-60309单相32A输入，36位C13和6位C19插座输出 | 台 | J1BJ7ZC1C6EB201CN5F1829000
21. |  | MB 1624-2103 | IEC-60309单相63A输入，21位C13和3位C19插座输出 | 台 | J1BJALC3E00B201CN711829000
22. |  | MB 1624-1806 | IEC-60309单相63A输入，18位C13和6位C19插座输出 | 台 | J1BJAIC6E00B201CN711829000
23. |  | MB 1624-2004 | IEC-60309单相63A输入，20位C13和4位C19插座输出 | 台 | J1BJAKC4E00B201CN711829000
24. |  | MB 1642-3606 | IEC-60309单相63A输入，36位C13和6位C19插座输出 | 台 | J1BJAZC1C6EB201CN711829000
25. |  | MB 3124-2103 | IEC-60309三相16A输入，21位C13和3位C19插座输出 | 台 | J1BJ4LC3E00B20JCN8J1829000
26. |  | MB 3124-1806 | IEC-60309三相16A输入，18位C13和6位C19插座输出 | 台 | J1BJ4IC6E00B20JCN8J1829000
27. |  | MB 3124-2004 | IEC-60309三相16A输入，20位C13和4位C19插座输出 | 台 | J1BJ4KC4E00B20JCN8J1829000
28. |  | MB 3142-3606 | IEC-60309三相16A输入，36位C13和6位C19插座输出 | 台 | J1BJ4ZC1C6EB20JCN8J1829000
29. |  | MB 3324-2103 | IEC-60309三相32A输入，21位C13和3位C19插座输出 | 台 | J1BJ7LC3E00B20JCNAK1829000
30. |  | MB 3324-1806 | IEC-60309三相32A输入，18位C13和6位C19插座输出 | 台 | J1BJ7IC6E00B20JCNAK1829000
31. |  | MB 3324-2004 | IEC-60309三相32A输入，20位C13和4位C19插座输出 | 台 | J1BJ7KC4E00B20JCNAK1829000
32. |  | MB 3342-3606 | IEC-60309三相32A输入，36位C13和6位C19插座输出 | 台 | J1BJ7ZC1C6EB20JCNAK1829000
33. | C系列 | MC 1324-2103 | IEC-60309单相32A输入，21位C13和3位C19插座输出 | 台 | J1BJ7LC3E00C201CN5F1829000
34. |  | MC 1324-1806 | IEC-60309单相32A输入，18位C13和6位C19插座输出 | 台 | J1BJ7IC6E00C201CN5F1829000
35. |  | MC 1324-2004 | IEC-60309单相32A输入，20位C13和4位C19插座输出 | 台 | J1BJ7KC4E00C201CN5F1829000
36. |  | MC 1624-2103 | IEC-60309单相63A输入，21位C13和3位C19插座输出 | 台 | J1BJALC3E00C201CN711829000
37. |  | MC 1624-1806 | IEC-60309单相63A输入，18位C13和6位C19插座输出 | 台 | J1BJAIC6E00C201CN711829000
38. |  | MC 1624-2004 | IEC-60309单相63A输入，20位C13和4位C19插座输出 | 台 | J1BJAKC4E00C201CN711829000
39. |  | MC 3124-2103 | IEC-60309三相16A输入，21位C13和3位C19插座输出 | 台 | J1BJ4LC3E00C20JCN8J1829000
40. |  | MC 3124-1806 | IEC-60309三相16A输入，18位C13和6位C19插座输出 | 台 | J1BJ4IC6E00C20JCN8J1829000
41. |  | MC 3124-2004 | IEC-60309三相16A输入，20位C13和4位C19插座输出 | 台 | J1BJ4KC4E00C20JCN8J1829000
42. |  | MC 3324-2103 | IEC-60309三相32A输入，21位C13和3位C19插座输出 | 台 | J1BJ7LC3E00C20JCNAK1829000
43. |  | MC 3324-1806 | IEC-60309三相32A输入，18位C13和6位C19插座输出 | 台 | J1BJ7IC6E00C20JCNAK1829000
44. |  | MC 3324-2004 | IEC-60309三相32A输入，20位C13和4位C19插座输出 | 台 | J1BJ7KC4E00C20JCNAK1829000
45. | D系列 | MD 1324-2103 | IEC-60309单相32A输入，21位C13和3位C19插座输出 | 台 | J1BJ7LC3E00D201CN5F1829000
46. |  | MD 1324-1806 | IEC-60309单相32A输入，18位C13和6位C19插座输出 | 台 | J1BJ7IC6E00D201CN5F1829000
47. |  | MD 1324-2004 | IEC-60309单相32A输入，20位C13和4位C19插座输出 | 台 | J1BJ7KC4E00D201CN5F1829000
48. |  | MD 1624-2103 | IEC-60309单相63A输入，21位C13和3位C19插座输出 | 台 | J1BJALC3E00D201CN711829000
49. |  | MD 1624-1806 | IEC-60309单相63A输入，18位C13和6位C19插座输出 | 台 | J1BJAIC6E00D201CN711829000
50. |  | MD 1624-2004 | IEC-60309单相63A输入，20位C13和4位C19插座输出 | 台 | J1BJAKC4E00D201CN711829000
51. |  | MD 3124-2103 | IEC-60309三相16A输入，21位C13和3位C19插座输出 | 台 | J1BJ4LC3E00D20JCN8J1829000
52. |  | MD 3124-1806 | IEC-60309三相16A输入，18位C13和6位C19插座输出 | 台 | J1BJ4IC6E00D20JCN8J1829000
53. |  | MD 3124-2004 | IEC-60309三相16A输入，20位C13和4位C19插座输出 | 台 | J1BJ4KC4E00D20JCN8J1829000
54. |  | MD 3324-2103 | IEC-60309三相32A输入，21位C13和3位C19插座输出 | 台 | J1BJ7LC3E00D20JCNAK1829000
55. |  | MD 3324-1806 | IEC-60309三相32A输入，18位C13和6位C19插座输出 | 台 | J1BJ7IC6E00D20JCNAK1829000
56. |  | MD 3324-2004 | IEC-60309三相32A输入，20位C13和4位C19插座输出 | 台 | J1BJ7KC4E00D20JCNAK1829000
