ChinaClever/CleverDoc/MPDU/MPDU 2017产品资料/产品ERP编码/M-PDU2017成品物料清单.xls

Sheet: A系列
0U, 32A 230V IEC 60309, (36)C13 & (6)C19 MA 1342-3606 （J1BJ7ZC1C6EA201CNGF1825000）
No. | 物料编码 | 物料名称 | 规 格 型 号 | 数量 | 单位（PCS） | 采购价格（元/RMB） |  | 计划价格（元/RMB） |  | 特别要求与说明 | 备 注
 |  |  |  |  |  | 单价 | 金额 | 单价 | 金额
1 | 2SRDSRMP15000 | MPDU 2017 32A底座模块 |  | 1 | PCS
2 | 2ZN1YLMPV0A00 | MPDU 2017A系列执行板模块12位C13+2位C19(A1-14) |  | 1 | PCS
3 | 2ZN1YLMPV0A01 | MPDU 2017A系列执行板模块12位C13+2位C19(A15-28) |  | 1 | PCS
4 | 2ZN1YLMPV0A02 | MPDU 2017A系列执行板模块12位C13+2位C19(A29-42) |  | 1 | PCS
5 | 2ZN1TMMPV0T00 | MPDU 2017单三相通用主控模块 |  | 1 | PCS
6
7 |  | 工时
8 | 价格合计（元/RMB） |  |  |  |  | 采购 |  |  | 计划
编制：肖 然 2017/01/13 |  |  | 审核：刘 轶 2017/01/13 |  |  |  | 批准：
0U, 63A 230V IEC 60309, (36)C13 & (6)C19 MA 1642-3606 (J1BJ9ZC1C4EA201CN711829000)
No. | 物料编码 | 物料名称 | 规 格 型 号 | 数量 | 单位（PCS） | 采购价格（元/RMB） |  | 计划价格（元/RMB） |  | 特别要求与说明 | 备 注
 |  |  |  |  |  | 单价 | 金额 | 单价 | 金额
1 | 2SRDSRMP18000 | MPDU 2017 63A底座模块 |  | 1 | PCS
2 | 2ZN1YLMPV0A00 | MPDU 2017A系列执行板模块12位C13+2位C19(A1-14) |  | 1 | PCS
3 | 2ZN1YLMPV0A01 | MPDU 2017A系列执行板模块12位C13+2位C19(A15-28) |  | 1 | PCS
4 | 2ZN1YLMPV0A02 | MPDU 2017A系列执行板模块12位C13+2位C19(A29-42) |  | 1 | PCS
5 | 2ZN1TMMPV0T00 | MPDU 2017单三相通用主控模块 |  | 1 | PCS
6
7 |  | 工时
8 | 价格合计（元/RMB） |  |  |  |  | 采购 |  |  | 计划
编制：肖 然 2017/01/13 |  |  | 审核：刘 轶 2017/01/13 |  |  |  | 批准：
0U, 11kW 400V IEC 60309, (36位C13+6位C19 MA 3142-3606 (J1BJ4ZC1C6EA20JCNKJ1825000)
No. | 物料编码 | 物料名称 | 规 格 型 号 | 数量 | 单位（PCS） | 采购价格（元/RMB） |  | 计划价格（元/RMB） |  | 特别要求与说明 | 备 注
 |  |  |  |  |  | 单价 | 金额 | 单价 | 金额
1 | 2SRDSRMP32000 | MPDU 2017 3*16A底座模块 |  | 1 | PCS
2 | 2ZN1YLMPV0A00 | MPDU 2017A系列执行板模块12位C13+2位C19(A1-14) |  | 1 | PCS
3 | 2ZN1YLMPV0A01 | MPDU 2017A系列执行板模块12位C13+2位C19(A15-28) |  | 1 | PCS
4 | 2ZN1YLMPV0A02 | MPDU 2017A系列执行板模块12位C13+2位C19(A29-42) |  | 1 | PCS
5 | 2ZN1TMMPV0T00 | MPDU 2017单三相通用主控模块 |  | 1 | PCS
6
7 |  | 工时
8 | 价格合计（元/RMB） |  |  |  |  | 采购 |  |  | 计划
编制：肖 然 2017/01/13 |  |  | 审核：刘 轶 2017/01/13 |  |  |  | 批准：
0U, 22kW 400V IEC 60309, (20)C13 & (4)C19 MA 3342-3606 (J1BJ7ZC1C6EA20JCNLK1825000)
No. | 物料编码 | 物料名称 | 规 格 型 号 | 数量 | 单位（PCS） | 采购价格（元/RMB） |  | 计划价格（元/RMB） |  | 特别要求与说明 | 备 注
 |  |  |  |  |  | 单价 | 金额 | 单价 | 金额
1 | 2SRDSRMP35000 | MPDU 2017 3*32A底座模块 |  | 1 | PCS
2 | 2ZN1YLMPV0A00 | MPDU 2017A系列执行板模块12位C13+2位C19(A1-14) |  | 1 | PCS
3 | 2ZN1YLMPV0A01 | MPDU 2017A系列执行板模块12位C13+2位C19(A15-28) |  | 1 | PCS
4 | 2ZN1YLMPV0A02 | MPDU 2017A系列执行板模块12位C13+2位C19(A29-42) |  | 1 | PCS
5 | 2ZN1TMMPV0T00 | MPDU 2017单三相通用主控模块 |  | 1 | PCS
6
7 |  | 工时
8 | 价格合计（元/RMB） |  |  |  |  | 采购 |  |  | 计划
编制：肖 然 2017/01/13 |  |  | 审核：刘 轶 2017/01/13 |  |  |  | 批准：

Sheet: B系列
0U, 32A 230V IEC 60309, (36)C13 & (6)C19 MB 1342-3606 （J1BJ7ZC1C6EB201CNGF1825000）
No. | 物料编码 | 物料名称 | 规 格 型 号 | 数量 | 单位（PCS） | 采购价格（元/RMB） |  | 计划价格（元/RMB） |  | 特别要求与说明 | 备 注
 |  |  |  |  |  | 单价 | 金额 | 单价 | 金额
1 | 2SRDSRMP15000 | MPDU 2017 32A底座模块 |  | 1 | PCS
2 | 2ZN1YLMPV0B00 | MPDU 2017B系列执行板模块12位C13+2位C19(B1-14) |  | 1 | PCS
3 | 2ZN1YLMPV0B01 | MPDU 2017B系列执行板模块12位C13+2位C19(B15-28) |  | 1 | PCS
4 | 2ZN1YLMPV0B02 | MPDU 2017B系列执行板模块12位C13+2位C19(B29-42) |  | 1 | PCS
5 | 2ZN1TMMPV0T00 | MPDU 2017单三相通用主控模块 |  | 1 | PCS
6
7 |  | 工时
8 | 价格合计（元/RMB） |  |  |  |  | 采购 |  |  | 计划
编制：肖 然 2017/01/13 |  |  | 审核：刘 轶 2017/01/13 |  |  |  | 批准：
0U, 63A 230V IEC 60309, (36)C13 & (6)C19 MB 1642-3606 (J1BJ9ZC1C4EB201CN711829000)
No. | 物料编码 | 物料名称 | 规 格 型 号 | 数量 | 单位（PCS） | 采购价格（元/RMB） |  | 计划价格（元/RMB） |  | 特别要求与说明 | 备 注
 |  |  |  |  |  | 单价 | 金额 | 单价 | 金额
1 | 2SRDSRMP18000 | MPDU 2017 63A底座模块 |  | 1 | PCS
2 | 2ZN1YLMPV0B00 | MPDU 2017B系列执行板模块12位C13+2位C19(B1-14) |  | 1 | PCS
3 | 2ZN1YLMPV0B01 | MPDU 2017B系列执行板模块12位C13+2位C19(B15-28) |  | 1 | PCS
4 | 2ZN1YLMPV0B02 | MPDU 2017B系列执行板模块12位C13+2位C19(B29-42) |  | 1 | PCS
5 | 2ZN1TMMPV0T00 | MPDU 2017单三相通用主控模块 |  | 1 | PCS
6
7 |  | 工时
8 | 价格合计（元/RMB） |  |  |  |  | 采购 |  |  | 计划
编制：肖 然 2017/01/13 |  |  | 审核：刘 轶 2017/01/13 |  |  |  | 批准：
0U, 11kW 400V IEC 60309, (36)C13 & (6)C19 MB 3142-3606 (J1BJ4ZC1C6EB20JCNKJ1825000)
No. | 物料编码 | 物料名称 | 规 格 型 号 | 数量 | 单位（PCS） | 采购价格（元/RMB） |  | 计划价格（元/RMB） |  | 特别要求与说明 | 备 注
 |  |  |  |  |  | 单价 | 金额 | 单价 | 金额
1 | 2SRDSRMP32000 | MPDU 2017 3*16A底座模块 |  | 1 | PCS
2 | 2ZN1YLMPV0B00 | MPDU 2017B系列执行板模块12位C13+2位C19(B1-14) |  | 1 | PCS
3 | 2ZN1YLMPV0B01 | MPDU 2017B系列执行板模块12位C13+2位C19(B15-28) |  | 1 | PCS
4 | 2ZN1YLMPV0B02 | MPDU 2017B系列执行板模块12位C13+2位C19(B29-42) |  | 1 | PCS
5 | 2ZN1TMMPV0T00 | MPDU 2017单三相通用主控模块 |  | 1 | PCS
6
7 |  | 工时
8 | 价格合计（元/RMB） |  |  |  |  | 采购 |  |  | 计划
编制：肖 然 2017/01/13 |  |  | 审核：刘 轶 2017/01/13 |  |  |  | 批准：
0U, 22kW 400V IEC 60309, (20)C13 & (4)C19 MB 3342-3606 (J1BJ7ZC1C6EB20JCNLK1825000)
No. | 物料编码 | 物料名称 | 规 格 型 号 | 数量 | 单位（PCS） | 采购价格（元/RMB） |  | 计划价格（元/RMB） |  | 特别要求与说明 | 备 注
 |  |  |  |  |  | 单价 | 金额 | 单价 | 金额
1 | 2SRDSRMP35000 | MPDU 2017 3*32A底座模块 |  | 1 | PCS
2 | 2ZN1YLMPV0B00 | MPDU 2017B系列执行板模块12位C13+2位C19(B1-14) |  | 1 | PCS
3 | 2ZN1YLMPV0B01 | MPDU 2017B系列执行板模块12位C13+2位C19(B15-28) |  | 1 | PCS
4 | 2ZN1YLMPV0B02 | MPDU 2017B系列执行板模块12位C13+2位C19(B29-42) |  | 1 | PCS
5 | 2ZN1TMMPV0T00 | MPDU 2017单三相通用主控模块 |  | 1 | PCS
6
7 |  | 工时
8 | 价格合计（元/RMB） |  |  |  |  | 采购 |  |  | 计划
编制：肖 然 2017/01/13 |  |  | 审核：刘 轶 2017/01/13 |  |  |  | 批准：

Sheet: C系列
0U, 32A 230V IEC 60309, (21)C13 & (3)C19 MC 1324-2103（J1BJ7LC3E00C201CN5F1829000）
No. | 物料编码 | 物料名称 | 规 格 型 号 | 数量 | 单位（PCS） | 采购价格（元/RMB） |  | 计划价格（元/RMB） |  | 特别要求与说明 | 备 注
 |  |  |  |  |  | 单价 | 金额 | 单价 | 金额
1 | 2SRDSRMP15000 | MPDU 2017 32A底座模块 |  | 1 | PCS
2 | 2ZN1YLMPV0C06 | MPDU 2017C系列执行板模块7位C13+1位C19(C1-8) |  | 1 | PCS
3 | 2ZN1YLMPV0C07 | MPDU 2017C系列执行板模块7位C13+1位C19(C9-16) |  | 1 | PCS
4 | 2ZN1YLMPV0C08 | MPDU 2017C系列执行板模块7位C13+1位C19(C17-24) |  | 1 | PCS
5 | 2ZN1TMMPV0T00 | MPDU 2017单三相通用主控模块 |  | 1 | PCS
6
7 |  | 工时
8 | 价格合计（元/RMB） |  |  |  |  | 采购 |  |  | 计划
编制：肖 然 2017/01/13 |  |  | 审核：刘 轶 2017/01/13 |  |  |  | 批准：
0U, 32A 230V IEC 60309, (18)C13 & (6)C19 MC 1324-1806 (J1BJ7IC6E00C201CN5F1829000)
No. | 物料编码 | 物料名称 | 规 格 型 号 | 数量 | 单位（PCS） | 采购价格（元/RMB） |  | 计划价格（元/RMB） |  | 特别要求与说明 | 备 注
 |  |  |  |  |  | 单价 | 金额 | 单价 | 金额
1 | 2SRDSRMP15000 | MPDU 2017 32A底座模块 |  | 1 | PCS
2 | 2ZN1YLMPV0C03 | MPDU 2017C系列执行板模块6位C13+2位C19(C1-8) |  | 1 | PCS
3 | 2ZN1YLMPV0C04 | MPDU 2017C系列执行板模块6位C13+2位C19(C9-16) |  | 1 | PCS
4 | 2ZN1YLMPV0C05 | MPDU 2017C系列执行板模块6位C13+2位C19(C17-24) |  | 1 | PCS
5 | 2ZN1TMMPV0T00 | MPDU 2017单三相通用主控模块 |  | 1 | PCS
6
7 |  | 工时
8 | 价格合计（元/RMB） |  |  |  |  | 采购 |  |  | 计划
编制：肖 然 2017/01/13 |  |  | 审核：刘 轶 2017/01/13 |  |  |  | 批准：
0U, 32A 230V IEC 60309, (20)C13 & (4)C19 MC 1324-2004 (J1BJ7KC4E00C201CN5F1829000)
No. | 物料编码 | 物料名称 | 规 格 型 号 | 数量 | 单位（PCS） | 采购价格（元/RMB） |  | 计划价格（元/RMB） |  | 特别要求与说明 | 备 注
 |  |  |  |  |  | 单价 | 金额 | 单价 | 金额
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
6
7 |  | 工时
8 | 价格合计（元/RMB） |  |  |  |  | 采购 |  |  | 计划
编制：肖 然 2017/01/13 |  |  | 审核：刘 轶 2017/01/13 |  |  |  | 批准：
0U, 22kW 400V IEC 60309, (21)C13 & (3)C19 MC 3324-2103 ( J1BJ7LC3E00C201CNAK1829000)
No. | 物料编码 | 物料名称 | 规 格 型 号 | 数量 | 单位（PCS） | 采购价格（元/RMB） |  | 计划价格（元/RMB） |  | 特别要求与说明 | 备 注
 |  |  |  |  |  | 单价 | 金额 | 单价 | 金额
1 | 2SRDSRMP35000 | MPDU 2017 3*32A底座模块 |  | 1 | PCS
2 | 2ZN1YLMPV0C06 | MPDU 2017C系列执行板模块7位C13+1位C19(C1-8) |  | 1 | PCS
3 | 2ZN1YLMPV0C07 | MPDU 2017C系列执行板模块7位C13+1位C19(C9-16) |  | 1 | PCS
4 | 2ZN1YLMPV0C08 | MPDU 2017C系列执行板模块7位C13+1位C19(C17-24) |  | 1 | PCS
5 | 2ZN1TMMPV0T00 | MPDU 2017单三相通用主控模块 |  | 1 | PCS
6
7 |  | 工时
8 | 价格合计（元/RMB） |  |  |  |  | 采购 |  |  | 计划
编制：肖 然 2017/01/13 |  |  | 审核：刘 轶 2017/01/13 |  |  |  | 批准：
0U, 22kW 400V IEC 60309, (18)C13 & (6)C19 MC 3324-1806 ( J1BJ7IC6E00C201CNAK1829000)
No. | 物料编码 | 物料名称 | 规 格 型 号 | 数量 | 单位（PCS） | 采购价格（元/RMB） |  | 计划价格（元/RMB） |  | 特别要求与说明 | 备 注
 |  |  |  |  |  | 单价 | 金额 | 单价 | 金额
1 | 2SRDSRMP35000 | MPDU 2017 3*32A底座模块 |  | 1 | PCS
2 | 2ZN1YLMPV0C03 | MPDU 2017C系列执行板模块6位C13+2位C19(C1-8) |  | 1 | PCS
3 | 2ZN1YLMPV0C04 | MPDU 2017C系列执行板模块6位C13+2位C19(C9-16) |  | 1 | PCS
4 | 2ZN1YLMPV0C05 | MPDU 2017C系列执行板模块6位C13+2位C19(C17-24) |  | 1 | PCS
5 | 2ZN1TMMPV0T00 | MPDU 2017单三相通用主控模块 |  | 1 | PCS
6
7 |  | 工时
8 | 价格合计（元/RMB） |  |  |  |  | 采购 |  |  | 计划
编制：肖 然 2017/01/13 |  |  | 审核：刘 轶 2017/01/13 |  |  |  | 批准：
0U, 22kW 400V IEC 60309, (20)C13 & (4)C19 MC 3324-2004 (J1BJ7KC4E00C201CNAK1829000)
No. | 物料编码 | 物料名称 | 规 格 型 号 | 数量 | 单位（PCS） | 采购价格（元/RMB） |  | 计划价格（元/RMB） |  | 特别要求与说明 | 备 注
 |  |  |  |  |  | 单价 | 金额 | 单价 | 金额
1 | 2SRDSRMP35000 | MPDU 2017 3*32A底座模块 |  | 1 | PCS
2 | 2ZN1YLMPV0C06 | MPDU 2017C系列执行板模块7位C13+1位C19(C1-8) |  | 1 | PCS
3 | 2ZN1YLMPV0C04 | MPDU 2017C系列执行板模块6位C13+2位C19(C9-16) |  | 1 | PCS
4 | 2ZN1YLMPV0C08 | MPDU 2017C系列执行板模块7位C13+1位C19(C17-24) |  | 1 | PCS
5 | 2ZN1TMMPV0T00 | MPDU 2017单三相通用主控模块 |  | 1 | PCS
6
7 |  | 工时
8 | 价格合计（元/RMB） |  |  |  |  | 采购 |  |  | 计划
编制：肖 然 2017/01/13 |  |  | 审核：刘 轶 2017/01/13 |  |  |  | 批准：

Sheet: D系列
0U, 32A 230V IEC 60309, (21)C13 & (3)C19 MD 1324-2103（J1BJ7LC3E00D201CN5F1829000）
No. | 物料编码 | 物料名称 | 规 格 型 号 | 数量 | 单位（PCS） | 采购价格（元/RMB） |  | 计划价格（元/RMB） |  | 特别要求与说明 | 备 注
 |  |  |  |  |  | 单价 | 金额 | 单价 | 金额
1 | 2SRDSRMP15000 | MPDU 2017 32A底座模块 |  | 1 | PCS
2 | 2ZN1YLMPV0D06 | MPDU 2017D系列执行板模块7位C13+1位C19(D1-8) |  | 1 | PCS
3 | 2ZN1YLMPV0D07 | MPDU 2017D系列执行板模块7位C13+1位C19(D9-16) |  | 1 | PCS
4 | 2ZN1YLMPV0D08 | MPDU 2017D系列执行板模块7位C13+1位C19(D17-24) |  | 1 | PCS
5 | 2ZN1TMMPV0T00 | MPDU 2017单三相通用主控模块 |  | 1 | PCS
6
7 |  | 工时
8 | 价格合计（元/RMB） |  |  |  |  | 采购 |  |  | 计划
编制：肖 然 2017/01/13 |  |  | 审核：刘 轶 2017/01/13 |  |  |  | 批准：
0U, 32A 230V IEC 60309, (18)C13 & (6)C19 MD 1324-1806 (J1BJ7IC6E00D201CN5F1829000)
No. | 物料编码 | 物料名称 | 规 格 型 号 | 数量 | 单位（PCS） | 采购价格（元/RMB） |  | 计划价格（元/RMB） |  | 特别要求与说明 | 备 注
 |  |  |  |  |  | 单价 | 金额 | 单价 | 金额
1 | 2SRDSRMP15000 | MPDU 2017 32A底座模块 |  | 1 | PCS
2 | 2ZN1YLMPV0D03 | MPDU 2017D系列执行板模块6位C13+2位C19(D1-8) |  | 1 | PCS
3 | 2ZN1YLMPV0D04 | MPDU 2017D系列执行板模块6位C13+2位C19(D9-16) |  | 1 | PCS
4 | 2ZN1YLMPV0D05 | MPDU 2017D系列执行板模块6位C13+2位C19(D17-24) |  | 1 | PCS
5 | 2ZN1TMMPV0T00 | MPDU 2017单三相通用主控模块 |  | 1 | PCS
6
7 |  | 工时
8 | 价格合计（元/RMB） |  |  |  |  | 采购 |  |  | 计划
编制：肖 然 2017/01/13 |  |  | 审核：刘 轶 2017/01/13 |  |  |  | 批准：
0U, 32A 230V IEC 60309, (20)C13 & (4)C19 MD 1324-2004 (J1BJ7KC4E00D201CN5F1829000)
No. | 物料编码 | 物料名称 | 规 格 型 号 | 数量 | 单位（PCS） | 采购价格（元/RMB） |  | 计划价格（元/RMB） |  | 特别要求与说明 | 备 注
 |  |  |  |  |  | 单价 | 金额 | 单价 | 金额
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
6
7 |  | 工时
8 | 价格合计（元/RMB） |  |  |  |  | 采购 |  |  | 计划
编制：肖 然 2017/01/13 |  |  | 审核：刘 轶 2017/01/13 |  |  |  | 批准：
0U, 22kW 400V IEC 60309, (21)C13 & (3)C19 MD 3324-2103 (J1BJ7LC3E00D201CNAK1829000)
No. | 物料编码 | 物料名称 | 规 格 型 号 | 数量 | 单位（PCS） | 采购价格（元/RMB） |  | 计划价格（元/RMB） |  | 特别要求与说明 | 备 注
 |  |  |  |  |  | 单价 | 金额 | 单价 | 金额
1 | 2SRDSRMP35000 | MPDU 2017 3*32A底座模块 |  | 1 | PCS
2 | 2ZN1YLMPV0D06 | MPDU 2017D系列执行板模块7位C13+1位C19(D1-8) |  | 1 | PCS
3 | 2ZN1YLMPV0D07 | MPDU 2017D系列执行板模块7位C13+1位C19(D9-16) |  | 1 | PCS
4 | 2ZN1YLMPV0D08 | MPDU 2017D系列执行板模块7位C13+1位C19(D17-24) |  | 1 | PCS
5 | 2ZN1TMMPV0T00 | MPDU 2017单三相通用主控模块 |  | 1 | PCS
6
7 |  | 工时
8 | 价格合计（元/RMB） |  |  |  |  | 采购 |  |  | 计划
编制：肖 然 2017/01/13 |  |  | 审核：刘 轶 2017/01/13 |  |  |  | 批准：
0U, 22kW 400V IEC 60309, (18)C13 & (6)C19 MD 3324-1806 (J1BJ7IC6E00D201CNAK1829000)
No. | 物料编码 | 物料名称 | 规 格 型 号 | 数量 | 单位（PCS） | 采购价格（元/RMB） |  | 计划价格（元/RMB） |  | 特别要求与说明 | 备 注
 |  |  |  |  |  | 单价 | 金额 | 单价 | 金额
1 | 2SRDSRMP35000 | MPDU 2017 3*32A底座模块 |  | 1 | PCS
2 | 2ZN1YLMPV0D03 | MPDU 2017D系列执行板模块6位C13+2位C19(D1-8) |  | 1 | PCS
3 | 2ZN1YLMPV0D04 | MPDU 2017D系列执行板模块6位C13+2位C19(D9-16) |  | 1 | PCS
4 | 2ZN1YLMPV0D05 | MPDU 2017D系列执行板模块6位C13+2位C19(D17-24) |  | 1 | PCS
5 | 2ZN1TMMPV0T00 | MPDU 2017单三相通用主控模块 |  | 1 | PCS
6
7 |  | 工时
8 | 价格合计（元/RMB） |  |  |  |  | 采购 |  |  | 计划
编制：肖 然 2017/01/13 |  |  | 审核：刘 轶 2017/01/13 |  |  |  | 批准：
0U, 22kW 400V IEC 60309, (20)C13 & (4)C19 MD 3324-2004 (J1BJ7KC4E00D201CNAK1829000)
No. | 物料编码 | 物料名称 | 规 格 型 号 | 数量 | 单位（PCS） | 采购价格（元/RMB） |  | 计划价格（元/RMB） |  | 特别要求与说明 | 备 注
 |  |  |  |  |  | 单价 | 金额 | 单价 | 金额
1 | 2SRDSRMP35000 | MPDU 2017 3*32A底座模块 |  | 1 | PCS
2 | 2ZN1YLMPV0D06 | MPDU 2017D系列执行板模块7位C13+1位C19(D1-8) |  | 1 | PCS
3 | 2ZN1YLMPV0D04 | MPDU 2017D系列执行板模块6位C13+2位C19(D9-16) |  | 1 | PCS
4 | 2ZN1YLMPV0D08 | MPDU 2017D系列执行板模块7位C13+1位C19(D17-24) |  | 1 | PCS
5 | 2ZN1TMMPV0T00 | MPDU 2017单三相通用主控模块 |  | 1 | PCS
6
7 |  | 工时
8 | 价格合计（元/RMB） |  |  |  |  | 采购 |  |  | 计划
编制：肖 然 2017/01/13 |  |  | 审核：刘 轶 2017/01/13 |  |  |  | 批准：
