ChinaClever/CleverDoc/MPDU/MPDU 2017产品资料/BOM/结构物料清单/主控模组/MPDU 2017产品主控模组结构部分物料清单.xlsx

MPDU 2017 控制模组结构部分物料清单
No. | 物料编码 | 物料名称 | 规 格 型 号 | 数量 | 单位（PCS） | 采购价格（元/RMB） |  | 计划价格（元/RMB） |  | 特别要求与说明 | 备 注
 |  |  |  |  |  | 单价 | 金额 | 单价 | 金额
1 | YM010040154 | MPDU2017控制模组面板 |  | 1 | PCS |  |  |  |  | 需丝印
2 | YM000180080 | MPDU2017控制模组镜片 |  | 1 | PCS
3 | YM010050450 | MPDU2017镜片压件 |  | 1 | PCS
4 | YM02001010 | M3螺母 |  | 4 | PCS
5 | YM020030018 | M3机牙圆头十字螺丝（带垫片） |  | 5 | PCS
6 | YM060030126 | MPDU2017控制模组PCB绝缘纸 | 225 X 46 X 0.5 mm | 1 | PCS
7 | YM020000113 | M3*4 十字平头细丝螺丝 黑色 |  | 4 | PCS
8
9 |  | 工时
10 | 价格合计（元/RMB） |  |  |  |  | 采购 |  |  | 计划
编制：肖 然 2017/04/26 |  |  | 审核：刘 轶 2017/04/26 |  |  |  | 批准：
 | *以上物料必须符合ROHS环保要求；
