ChinaClever/CleverDoc/MPDU/MPDU 2017产品资料/BOM/结构物料清单/输入部分/三相32A输入部分/三相32A输入部分物料清单.xlsx

MPDU 2017 三相32A输入部分物料清单
No. | 物料编码 | 物料名称 | 规 格 型 号 | 数量 | 单位（PCS） | 采购价格（元/RMB） |  | 计划价格（元/RMB） |  | 特别要求与说明 | 备 注 | 物料类别
 |  |  |  |  |  | 单价 | 金额 | 单价 | 金额
1 | YM03001005 | 3P+N+E 3*32A 怡达工业插头 |  | 1 | PCS |  |  |  |  |  |  | 插头
2 | YM020040033 | PG21固线座（蓝科） |  | 1 | PCS |  |  |  |  |  |  | 固线座
3 | YM050010015 | 5*6电缆线（一端环形端子） |  | 3 | M |  |  |  |  |  |  | 线材
4 |  | 工时
5 | 价格合计（元/RMB） |  |  |  |  | 采购 |  |  | 计划
编制：肖 然 2017/04/26 |  |  | 审核：刘 轶 2017/04/26 |  |  |  | 批准：
 | *以上物料必须符合ROHS环保要求；
