ChinaClever/CleverDoc/MPDU/MPDU 2017产品资料/BOM/结构物料清单/输出模组/A系列输出模组/12位C13+2位C19输出模组/A1-14-2ZN1YLMPV0A00物料清单/12+2结构部分物料清单(A1-14).xlsx

MPDU 2017 12+2输出模块结构部分物料清单（A1-14）
No. | 物料编码 | 物料名称 | 规 格 型 号 | 数量 | 单位（PCS） | 采购价格（元/RMB） |  | 计划价格（元/RMB） |  | 特别要求与说明 | 备 注
 |  |  |  |  |  | 单价 | 金额 | 单价 | 金额
1 | YM010040149 | 2017智能产品12+2输出面壳A1-14 | 372.7*56*21.8 | 1 | PCS |  |  |  |  | 需丝印
2 | YM030000155 | 双联C13插座 |  | 6 | PCS |  |  |  |  |  | 新物料
3 | YM03000036 | C19插座 | SS-3D/Ф4.0椭圆孔/黑色 | 2 | PCS
4 | YM020030018 | M3机牙圆头十字螺丝（带垫片） |  | 4 | PCS
6 | YM060030127 | MPDU2017输出模组PCB绝缘纸 | 368*111.5*0.5mm | 1 | PCS
7 | YM020000113 | M3*4 十字平头细丝螺丝 黑色 |  | 4 | PCS
8
9 |  | 工时
10 | 价格合计（元/RMB） |  |  |  |  | 采购 |  |  | 计划
编制：肖 然 2017/04/26 |  |  | 审核：刘 轶 2017/04/26 |  |  |  | 批准：
 | *以上物料必须符合ROHS环保要求；
