ChinaClever/CleverDoc/(list of files, cad)

Other CAD files:
MPDU/MPDU 2017产品资料/PCB图/MPDU 2017-ZX 12C13-2C19-1-20170401.dwg
MPDU/MPDU 2017产品资料/元件图/MPDU 2017-ZX 12C13-2C19-2.dwg
MPDU/MPDU 2017产品资料/PCB图/RN7302-V1.0.dwg
MPDU/MPDU 2017产品资料/元件图/MPDU 2017-ZX 12C13-2C19-1.dwg
MPDU/MPDU 2017产品资料/PCB图/C19-1-20170401.dwg
MPDU/MPDU 2017产品资料/元件图/C19-1.DWG
MPDU/MPDU 2017产品资料/PCB图/MPDU 2017-ZJ PCB V1.dwg
MPDU/MPDU 2017产品资料/元件图/MPUD2017-ZXLJ-PCB 20170401.DWG
MPDU/MPDU 2017产品资料/PCB图/MPDU 2017-ZX6c13-2c19-20170401-1.dwg
MPDU/MPDU 2017产品资料/元件图/MPDU 2017-ZX4c13-4c19.DWG
MPDU/MPDU 2017产品资料/PCB图/MPDU 2017-ZX 12C13-2C19-2-20170113.dwg
MPDU/MPDU 2017产品资料/元件图/MPDU2017-ZK PCB888 2004 V1.0.dwg
MPDU/MPDU 2017产品资料/PCB图/MPDU 2017-ZX7c13-1c19-20170401-1.dwg
MPDU/MPDU 2017产品资料/元件图/MPDU 2017-ZJ PCB V1.DWG
MPDU/MPDU 2017产品资料/PCB图/MPUD2017-ZXLJ-PCB 20170401.dwg
MPDU/MPDU 2017产品资料/元件图/MPDU 2017-XS PCB V1.DWG
MPDU/MPDU 2017产品资料/PCB图/MPDU 2017-XS PCB V1.dwg
MPDU/MPDU 2017产品资料/元件图/MPDU 2017-ZX7c13-1c19.dwg
MPDU/MPDU 2017产品资料/元件图/RN7302-V1.DWG
MPDU/MPDU 2017产品资料/元件图/MPDU 2017-ZX6c13-2c19.dwg
