ChinaClever/CleverDoc/IP/IP-PDU-2017计量板(新电源）2016-08-05.pdf

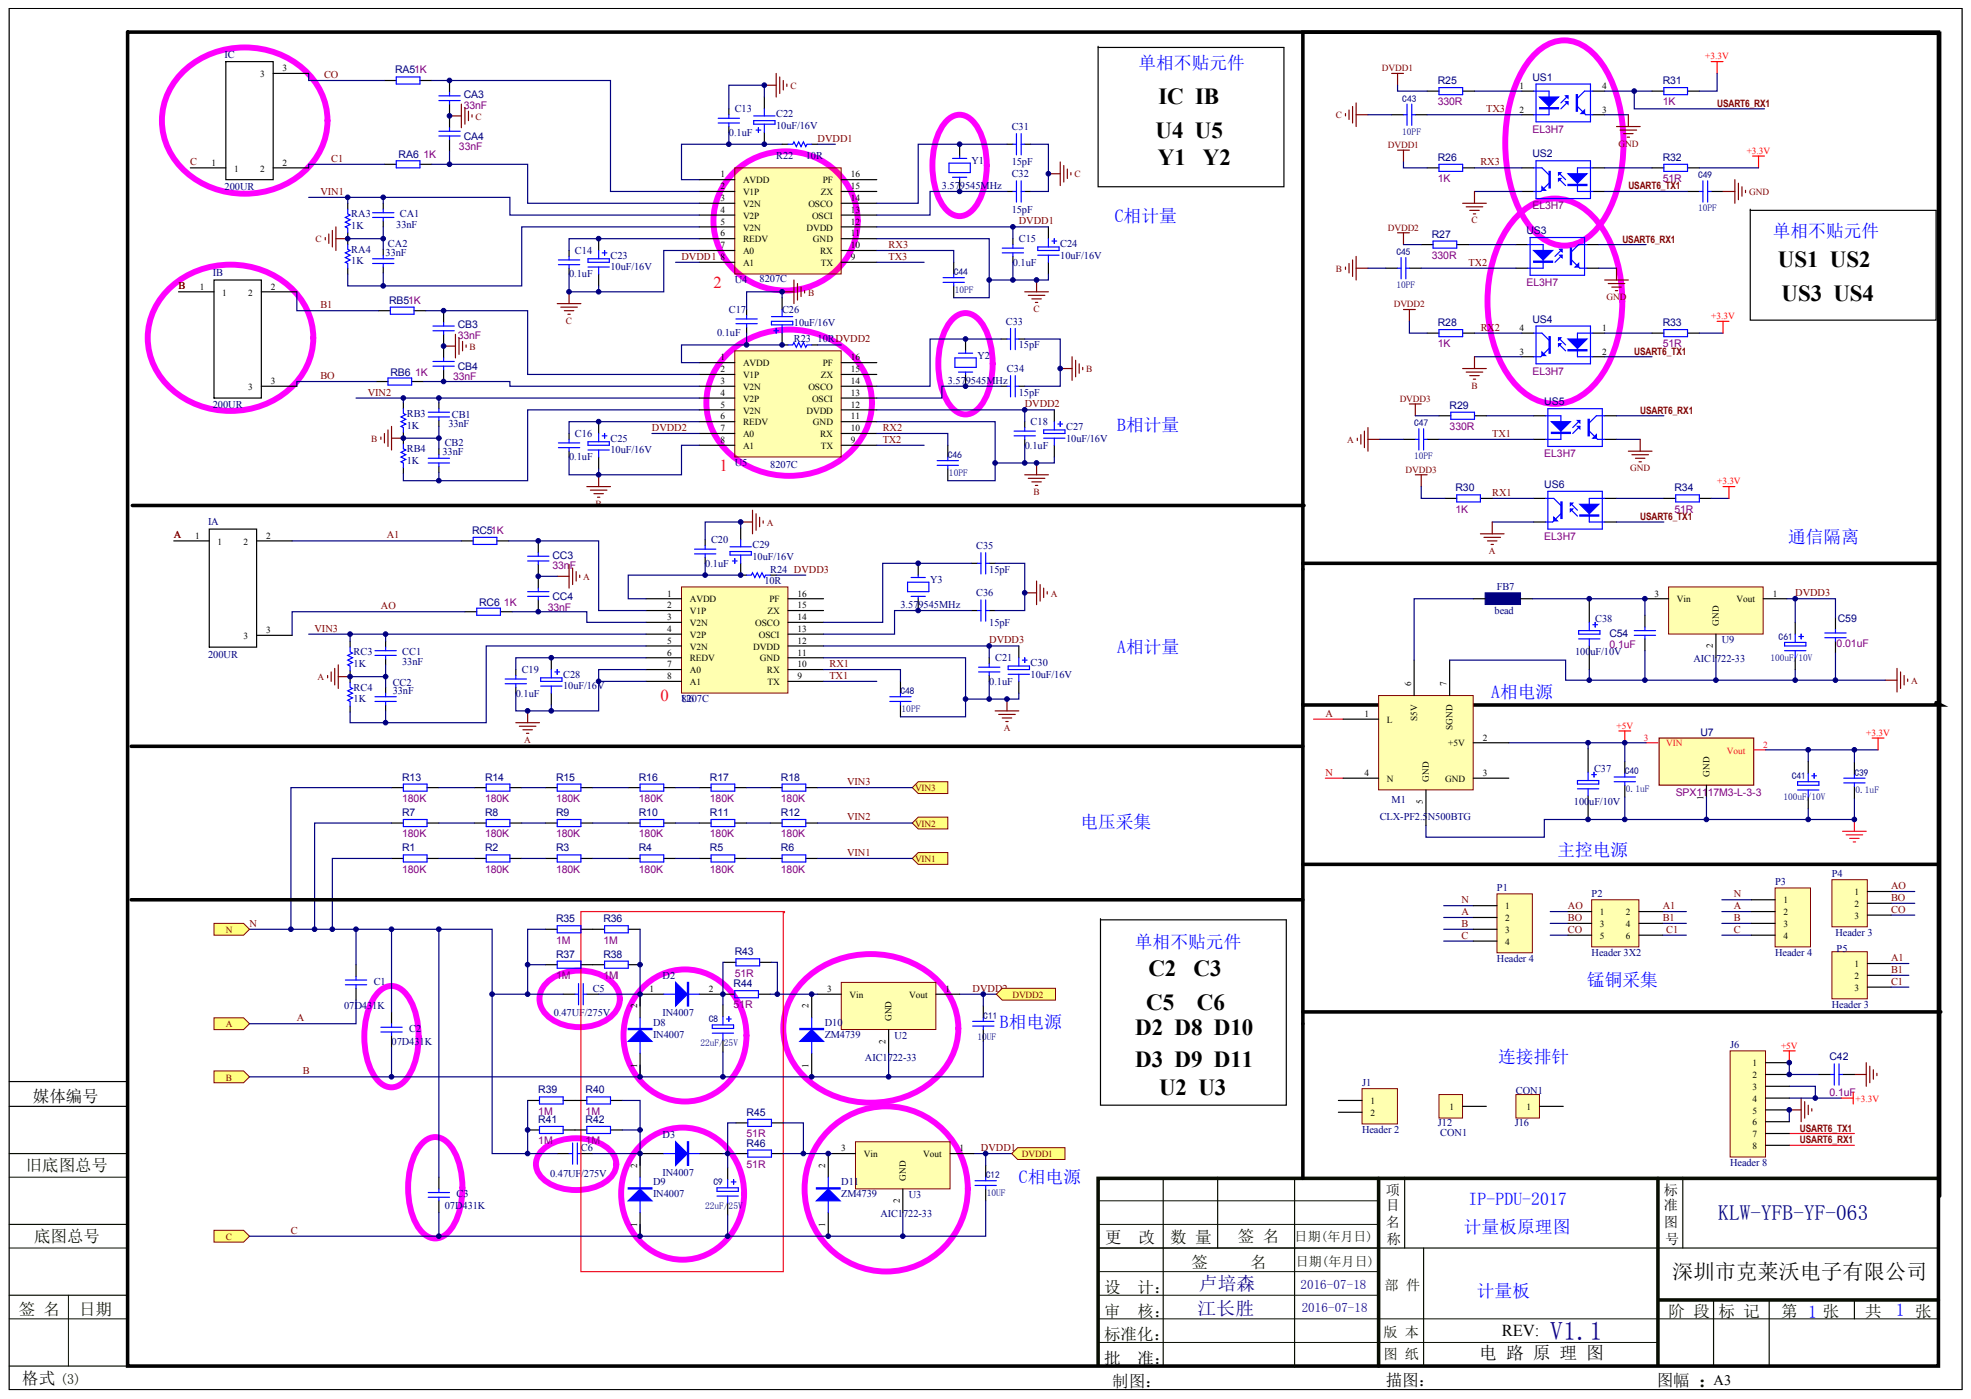
[picture p112: page 1]

REDV 6

C23 DVDD1 10uF/16V | TX3

AIC1722-33

更 改 | 数 量 | 签 名 | 日期(年月日)

名 | 日期(年月日) | 部 件 | 计量板 | 深圳市克莱沃电子有限公司 签

设 计： | 卢培森 | 2016-07-18
审 核： | 江长胜 | 2016-07-18 | | | 阶 段 | 标 记 | 第 1 张 | 共 1 张
标准化： | | | 版 本 | V1.1 REV:
批 准： | | | 图 纸 | 电 路 原 理 图
