ChinaClever/CleverDoc/IP/NPDU2017-ZK PCB  V0.4.pdf

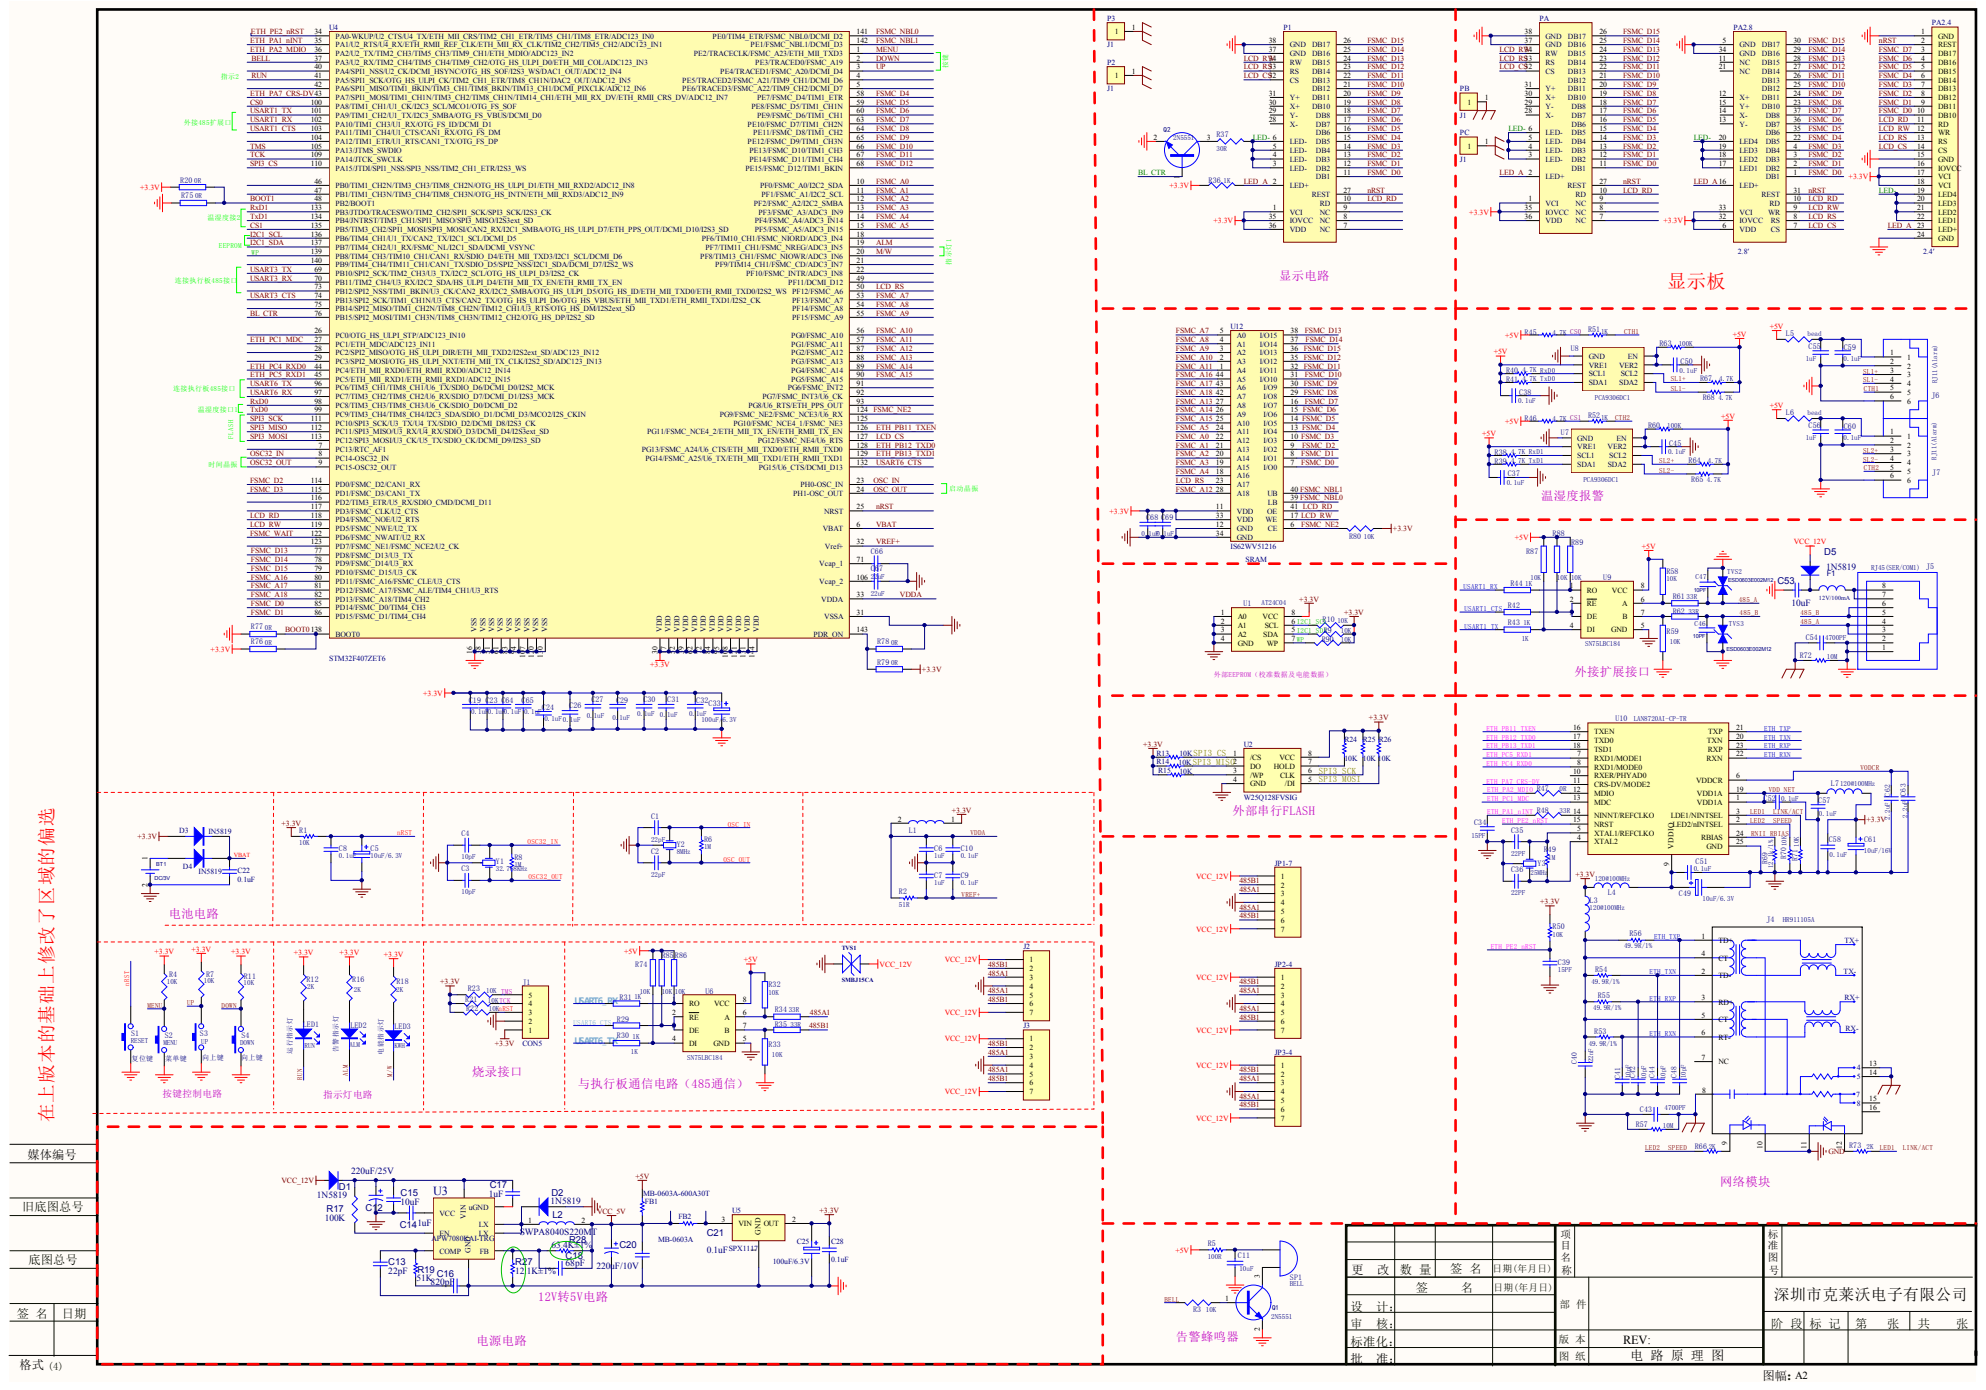
[picture p113: page 1]

PB12/SPI2_NSS/TIM1_BKIN/U3_CK/CAN2_RX/I2C2_SMBA/OTG_HS_ULPI_D5/OTG_HS_ID/ETH_MII_TXD0/ETH_RMII_TXD0/I2S2_WS 73 | LCD_RS

nRST 复位键 菜单键 向上键 向上键 运行指示灯

名 | 日期(年月日) | 部 件 | 深圳市克莱沃电子有限公司 签

设 计：
审 核： | | | 阶 段 | 标 记 | 第 张 | 共 张
标准化： | 版 本 | REV:
批 准： | 图 纸 | 电 路 原 理 图
