ChinaClever/CleverDoc/MPDU/MPDU 2017产品资料/原理图/NPDU2017-ZK PCB  V1.0.pdf

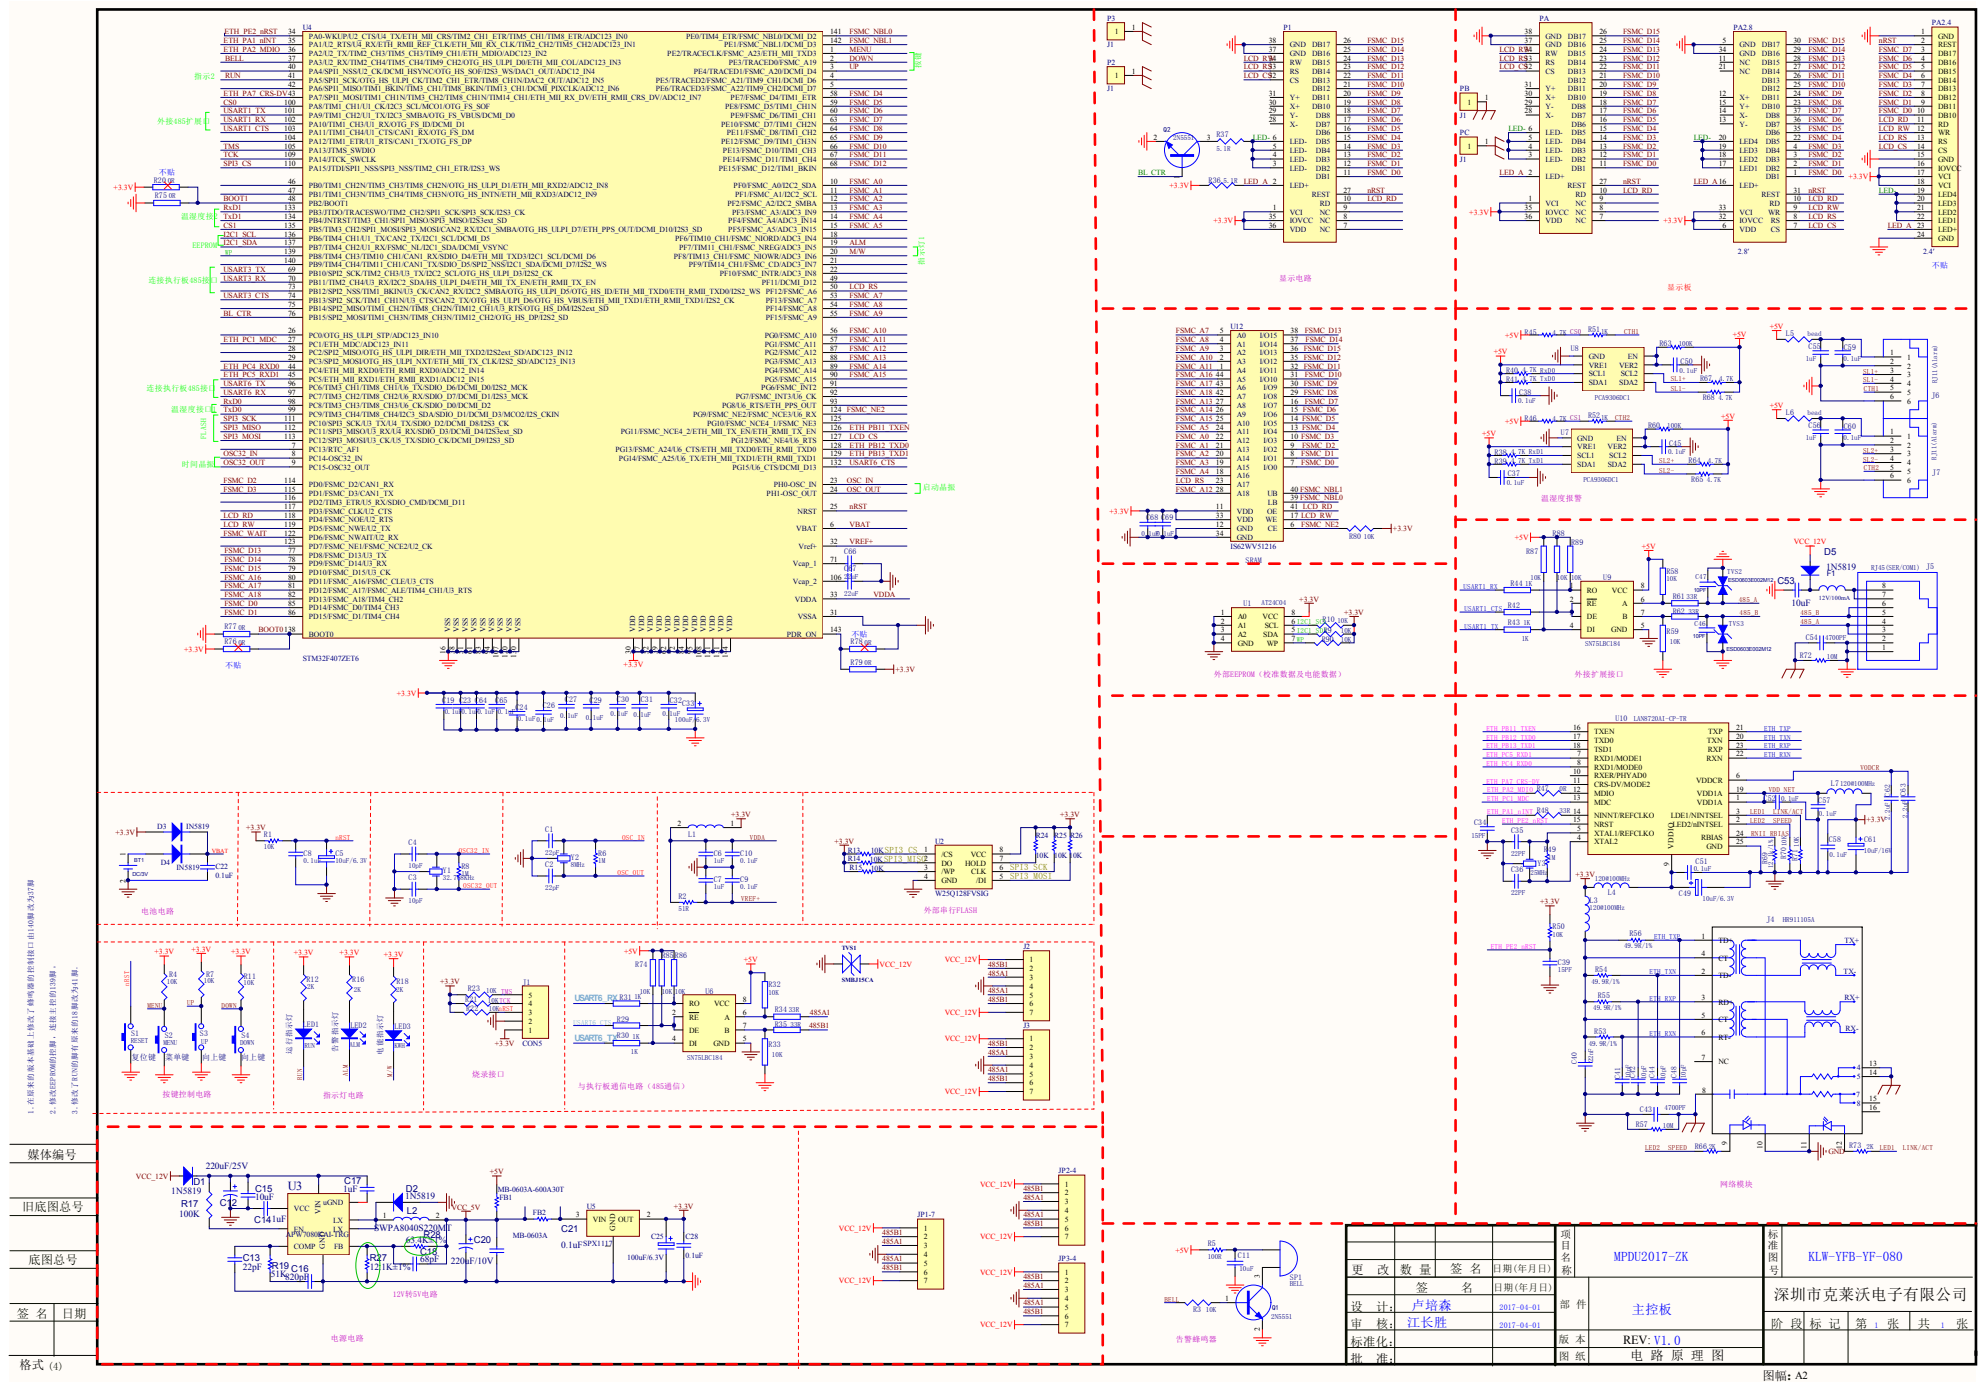
[picture p114: page 1]

PB12/SPI2_NSS/TIM1_BKIN/U3_CK/CAN2_RX/I2C2_SMBA/OTG_HS_ULPI_D5/OTG_HS_ID/ETH_MII_TXD0/ETH_RMII_TXD0/I2S2_WS 73 | LCD_RS

nRST 复位键 菜单键 向上键 向上键 运行指示灯

标准化： | 版 本 | REV: V1.0
批 准： | 图 纸 | 电 路 原 理 图
