ChinaClever/CleverDoc/MPDU/MPDU 2017产品资料/丝印图纸/插座模块/4+4/20170207--2017智能产品D系列输出模块丝印图-4位C13+4位C19  17-24.pdf

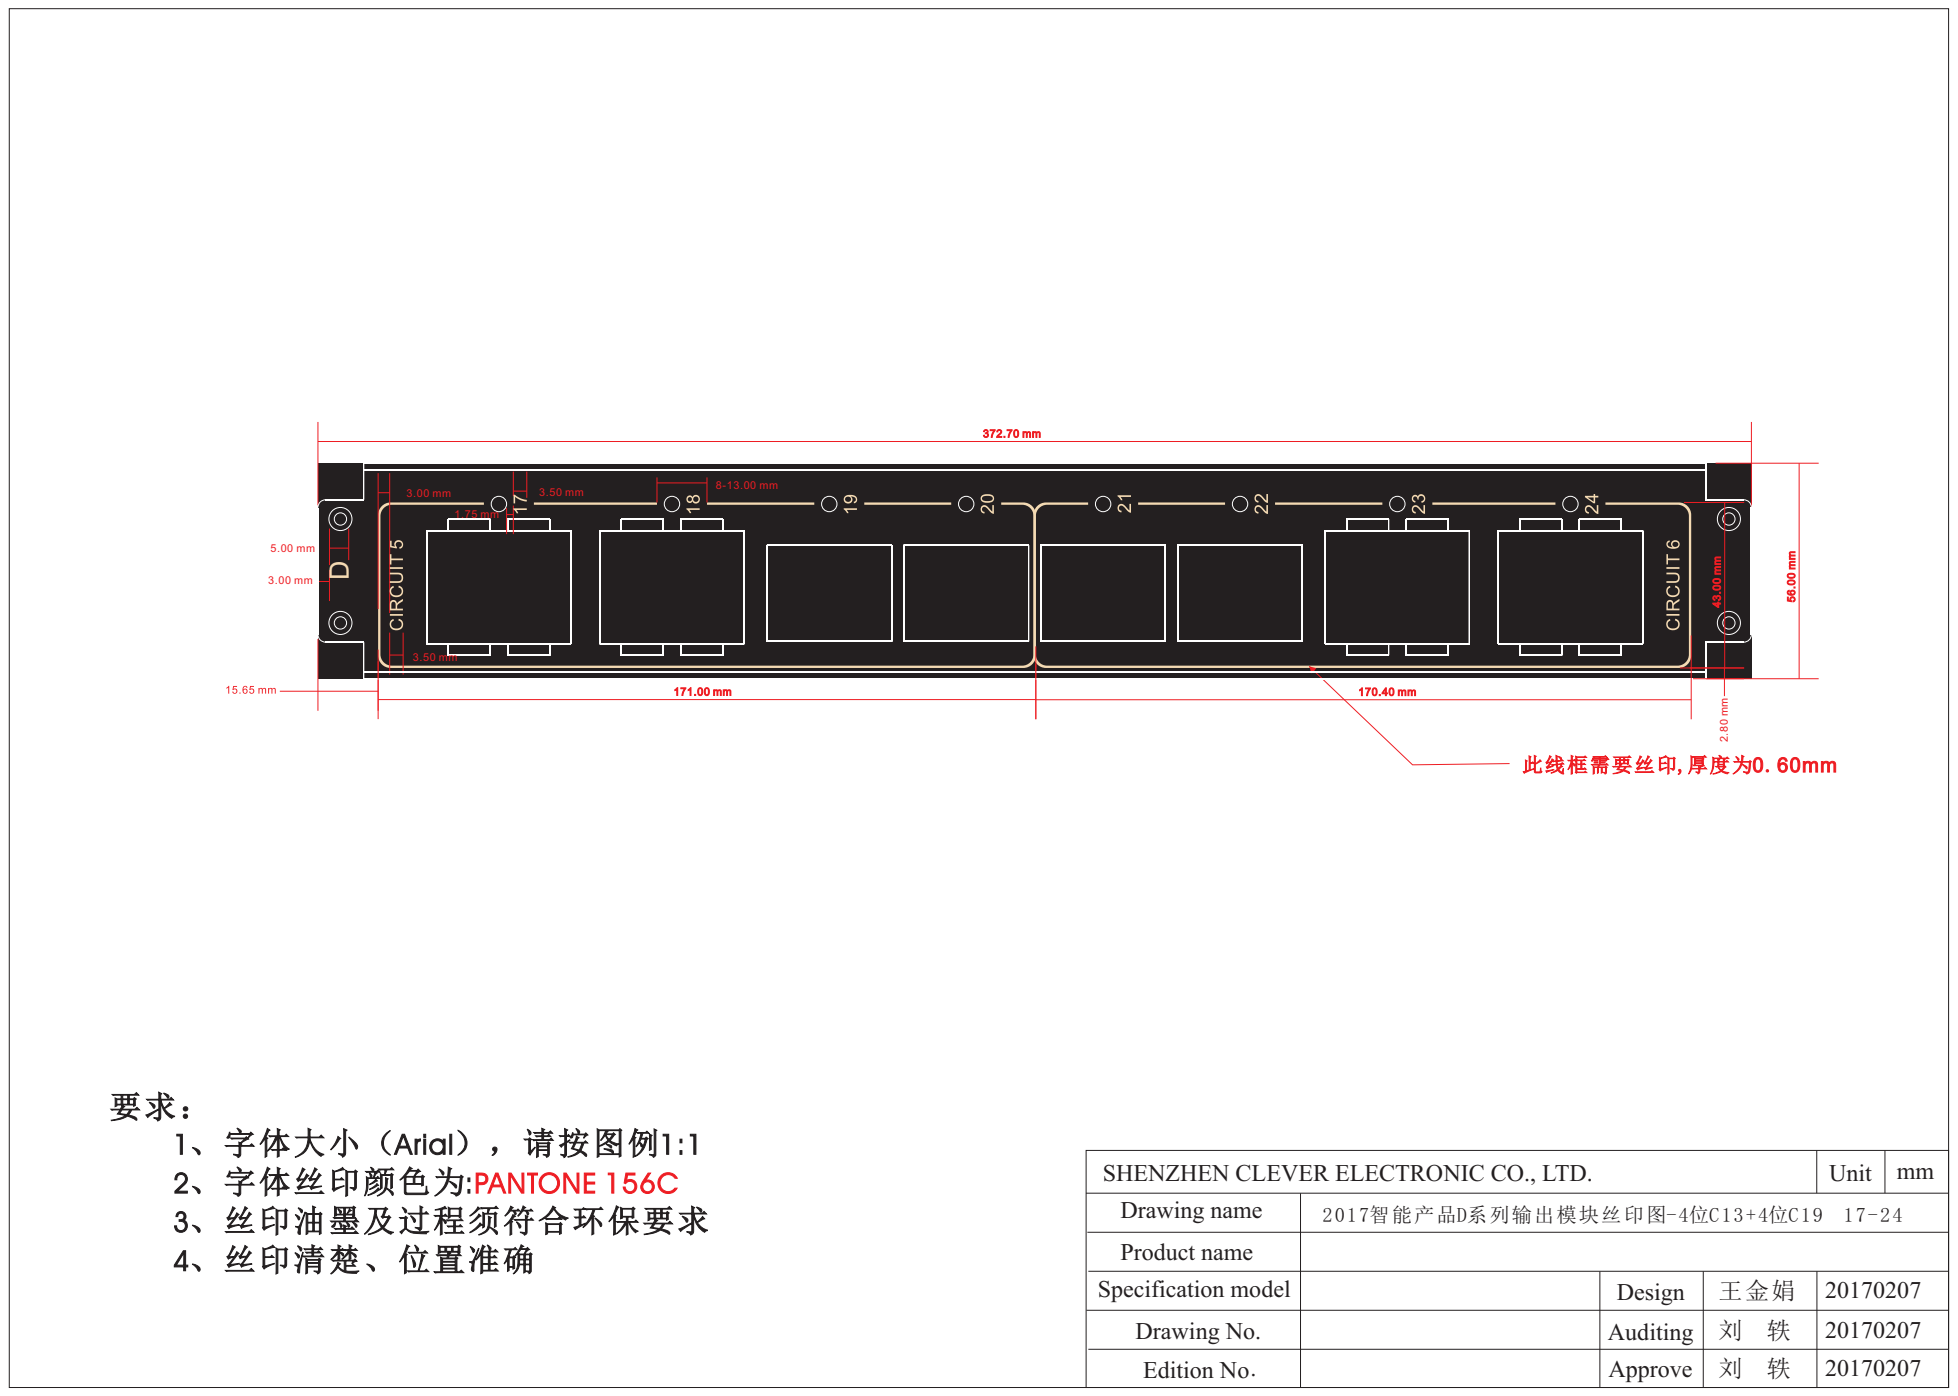
[picture p116: page 1]
Product name; Specification model; Design; Auditing; Approve; Edition No.; Drawing No.; Unit; 2017智能产品D系列输出模块丝印图-4位C13+4位C19 17-24; 王金娟; 要求： 1、字体大小（Arial），请按图例1:1 2、字体丝印颜色为: 3、丝印油墨及过程须符合环保要求 4、丝印清楚、位置准确; PANTONE 156C; 此线框需要丝印,厚度为0.60mm

SHENZHEN CLEVER ELECTRONIC CO., LTD.
Drawing name
