ChinaClever/CleverDoc/IP/IP-PDU-2017主控板2016-08-18(认证修改）.pdf

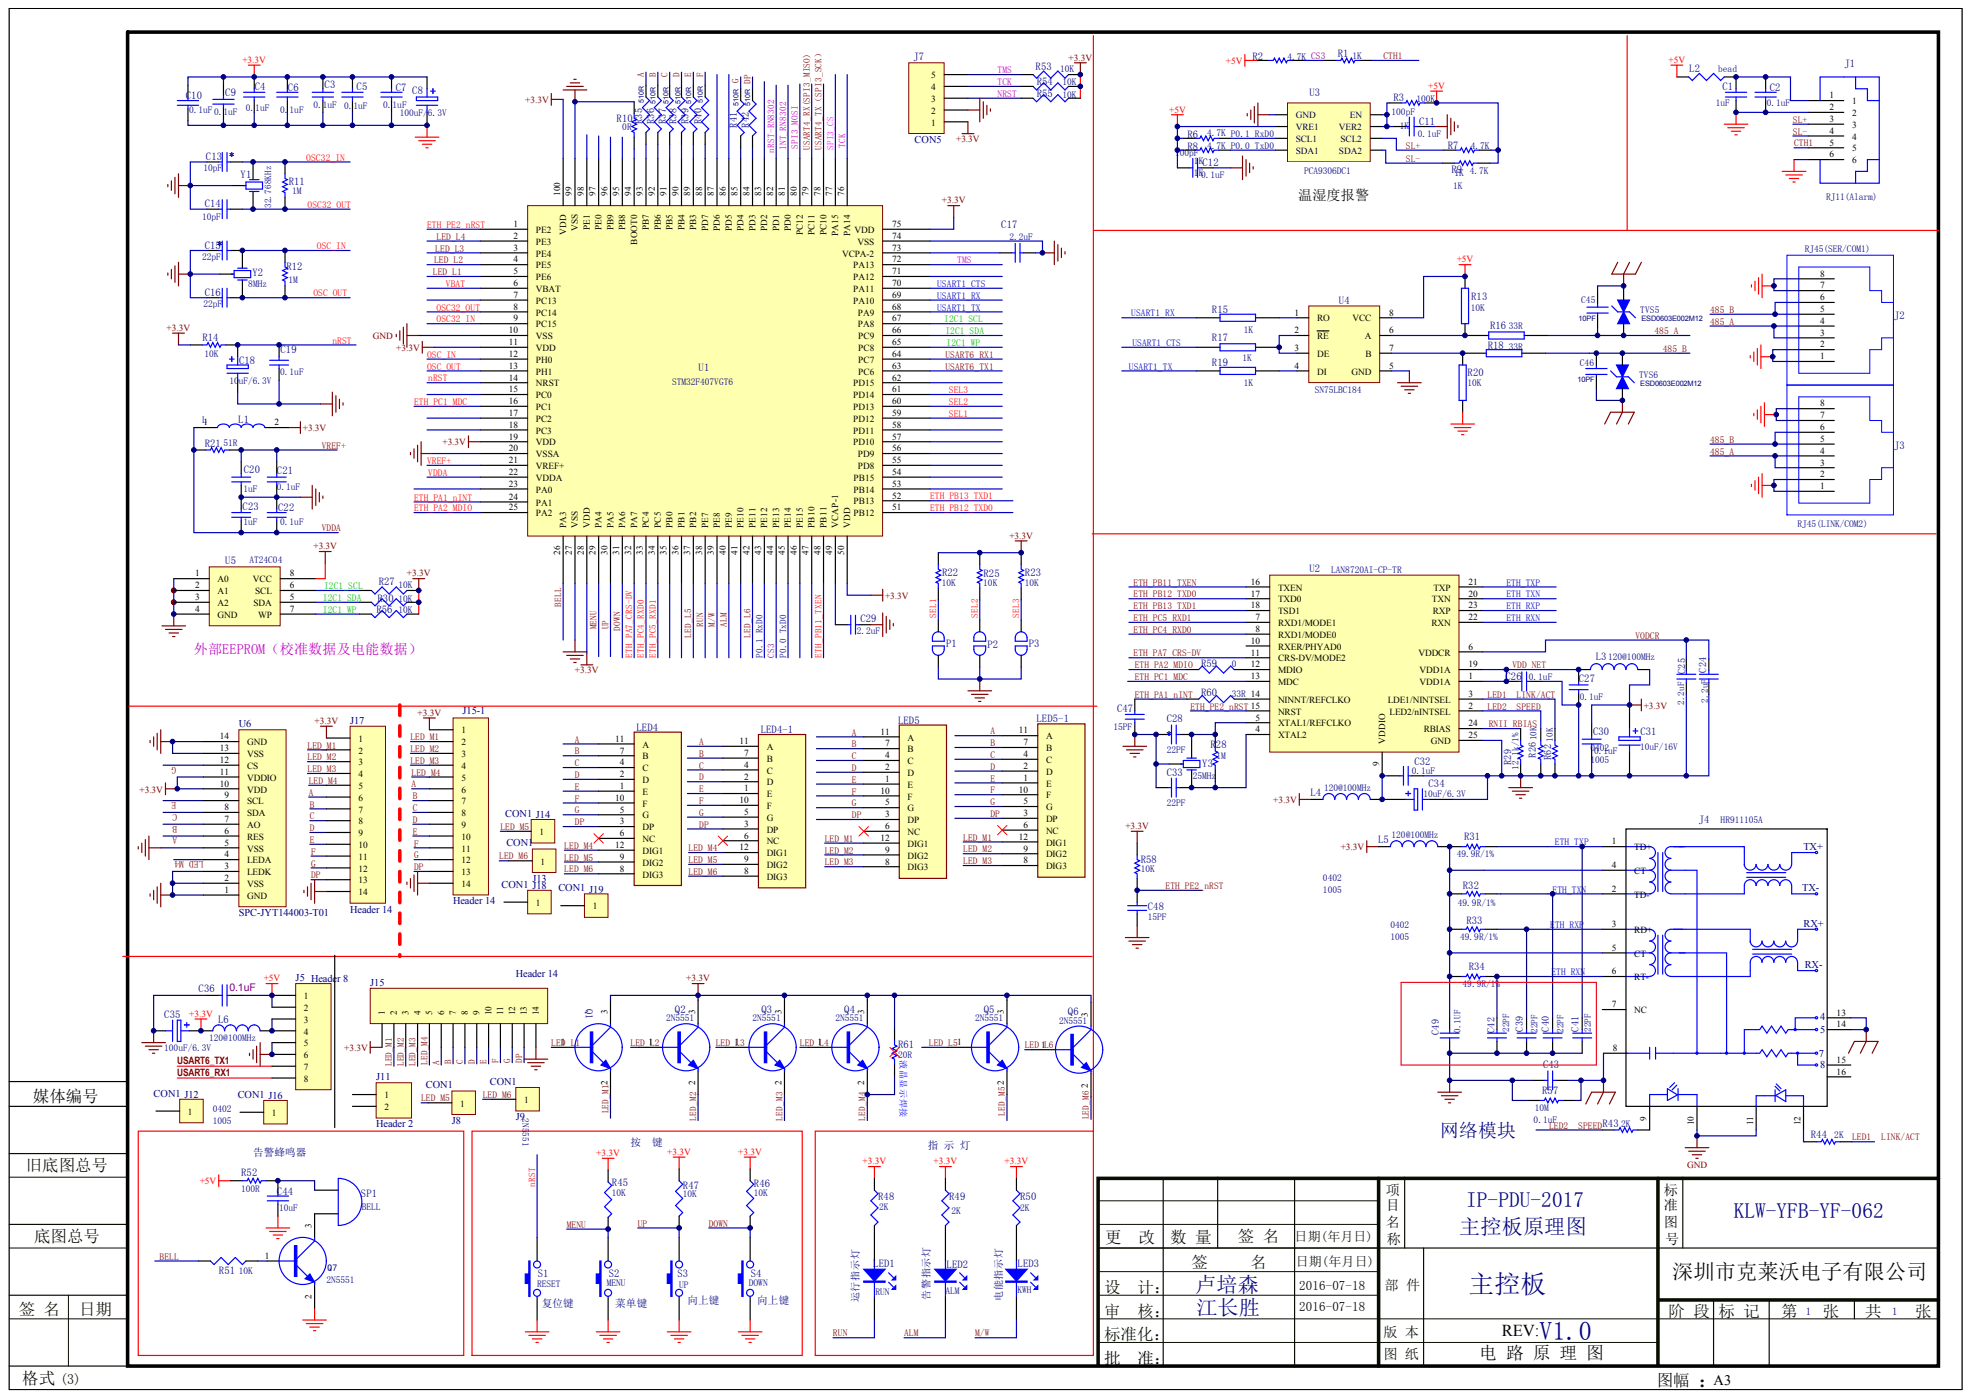
[picture p118: page 1]

R34 | ETH_RXN | RT- 6

项 目 名 称 | IP-PDU-2017 主控板原理图 | 标 准 图 号 | KLW-YFB-YF-062

更 改 | 数 量 | 签 名 | 日期(年月日)

名 | 日期(年月日) | 部 件 | 主控板 V1.0 | 深圳市克莱沃电子有限公司 签

设 计： | 卢培森 | 2016-07-18
审 核： | 江长胜 | 2016-07-18 | | | 阶 段 | 标 记 | 第 1 张 | 共 1 张
标准化： | | | 版 本 | REV:
批 准： | | | 图 纸 | 电 路 原 理 图
