ChinaClever/CleverDoc/IP/IP-PDU2017 Plus V01.pdf

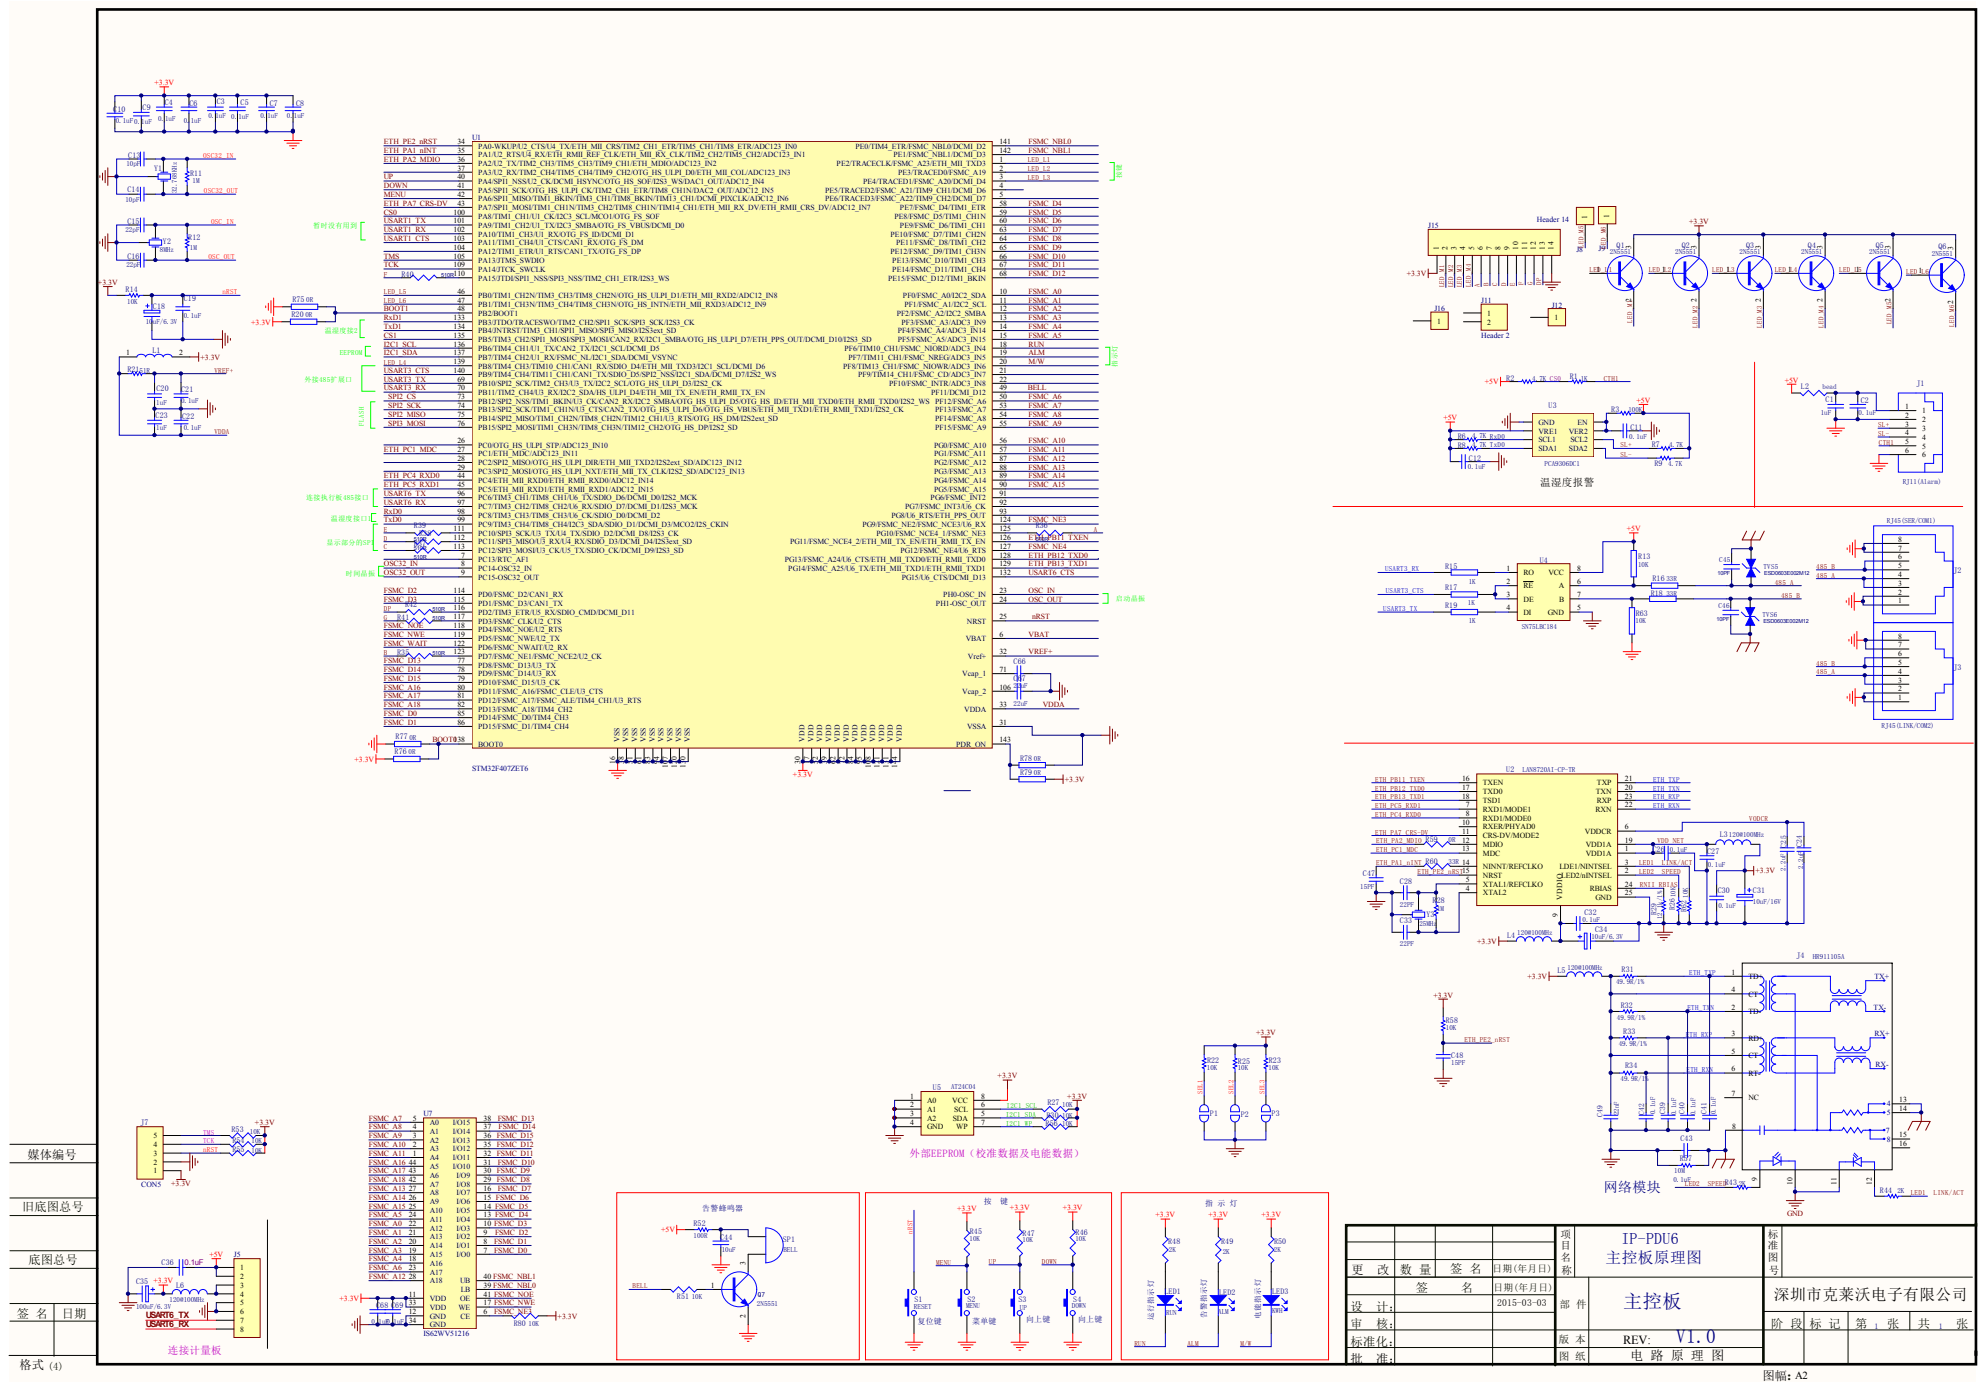
[picture p119: page 1]

R32 R33 | ETH_TXN | | TD- 2

ETH_RXP | | RD+ 3

R34 | ETH_RXN | | RT- 6

nRST 复位键 菜单键 向上键 向上键 运行指示灯
