ChinaClever/CleverDoc/工作母线/工业母线原理图/IP-BUSBAR主控板 V0.1.pdf

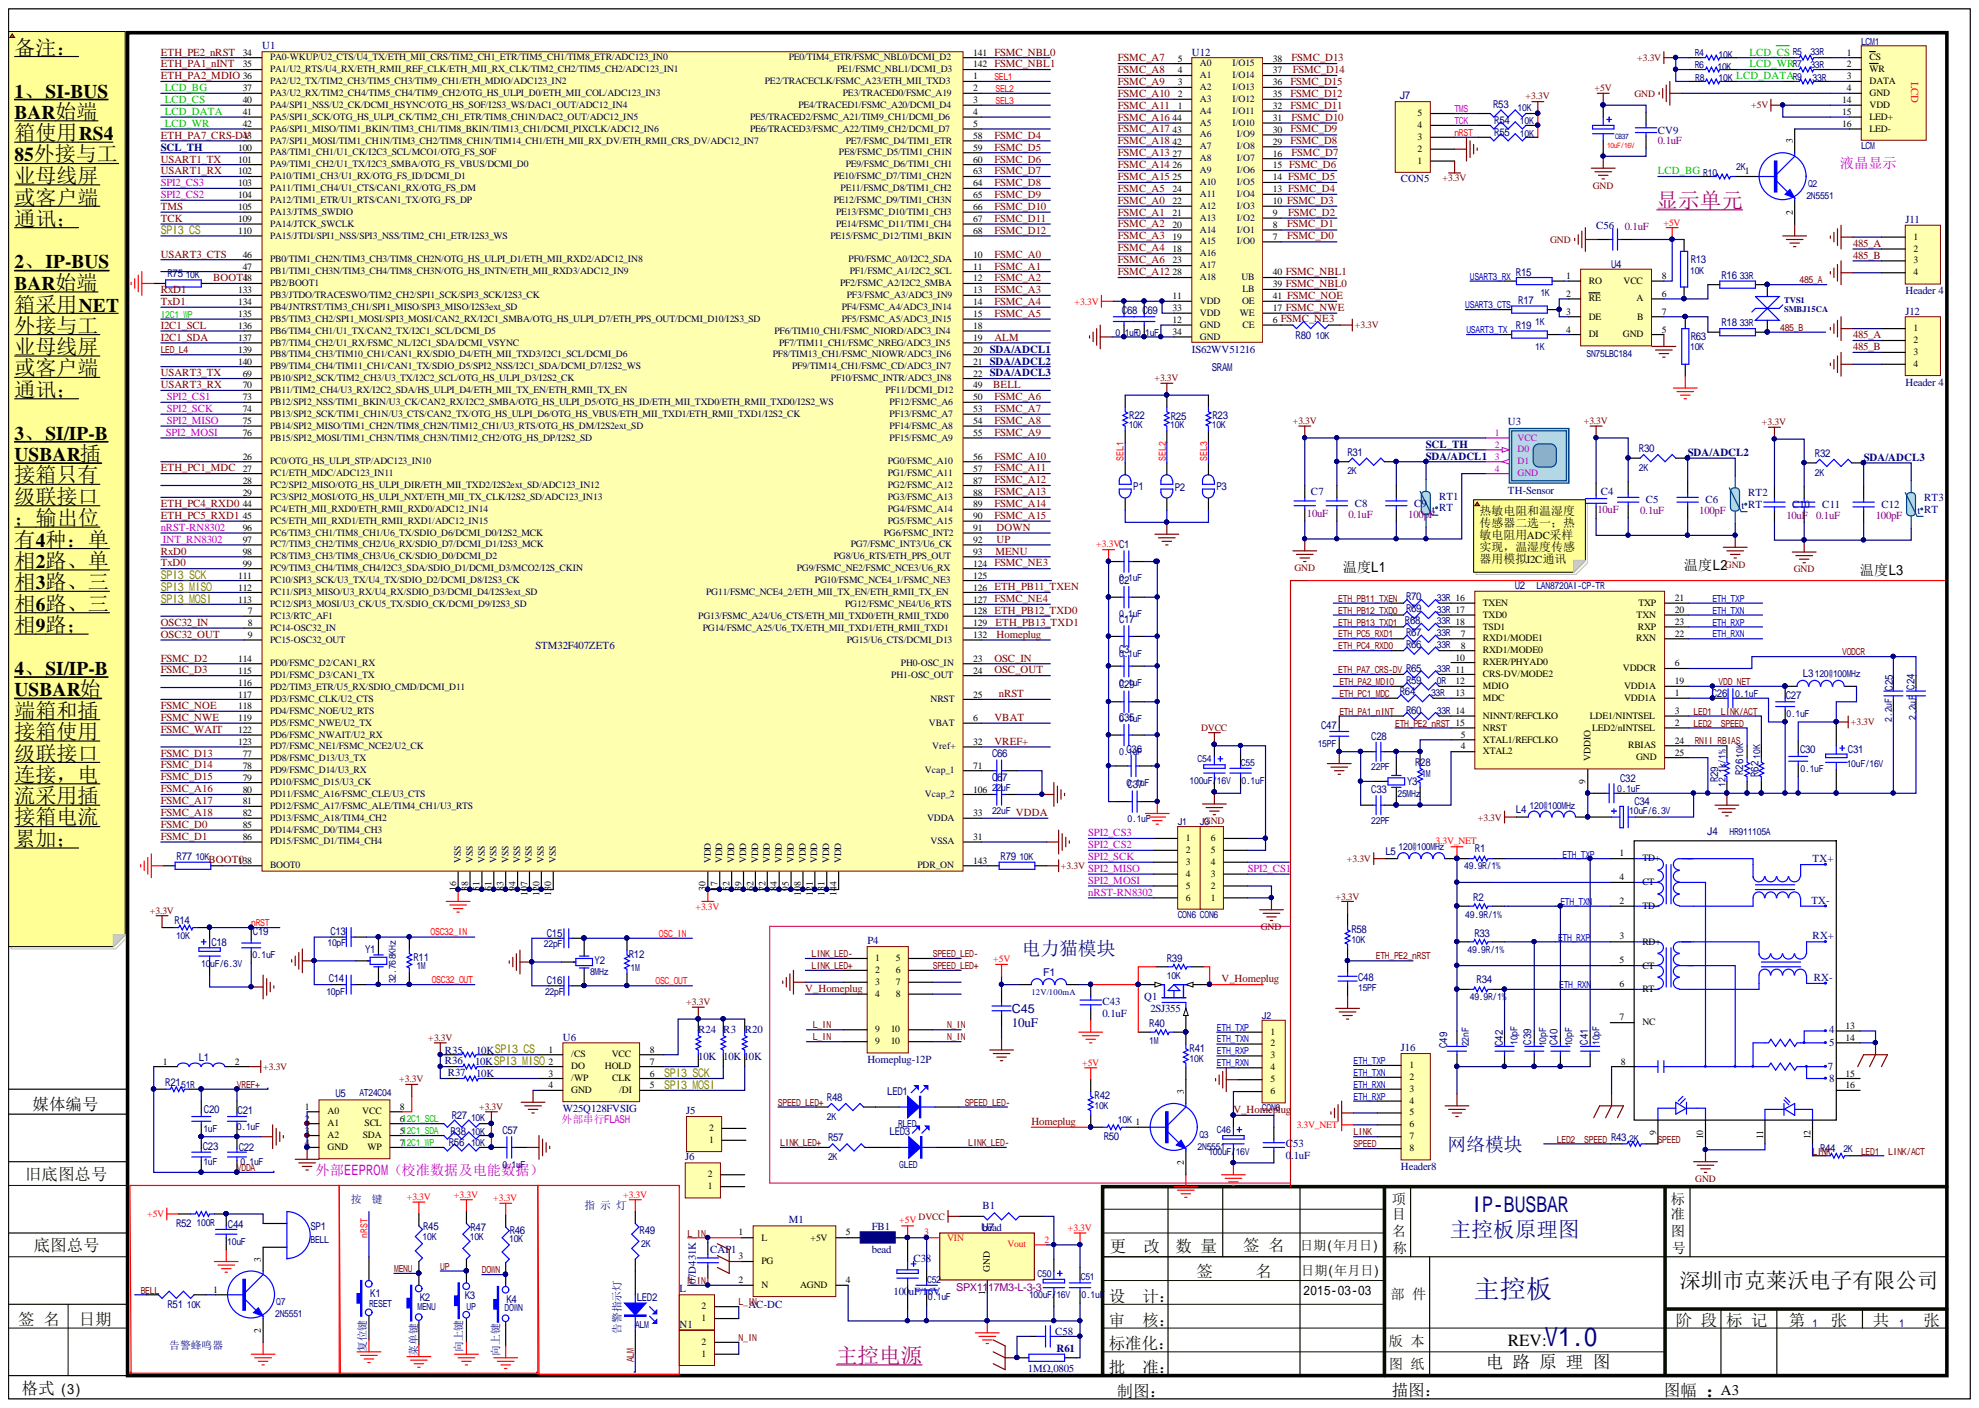
[picture p120: page 1]
