ChinaClever/CleverDoc/工作母线/工业母线原理图/SI-BUSBAR  V0.1.pdf

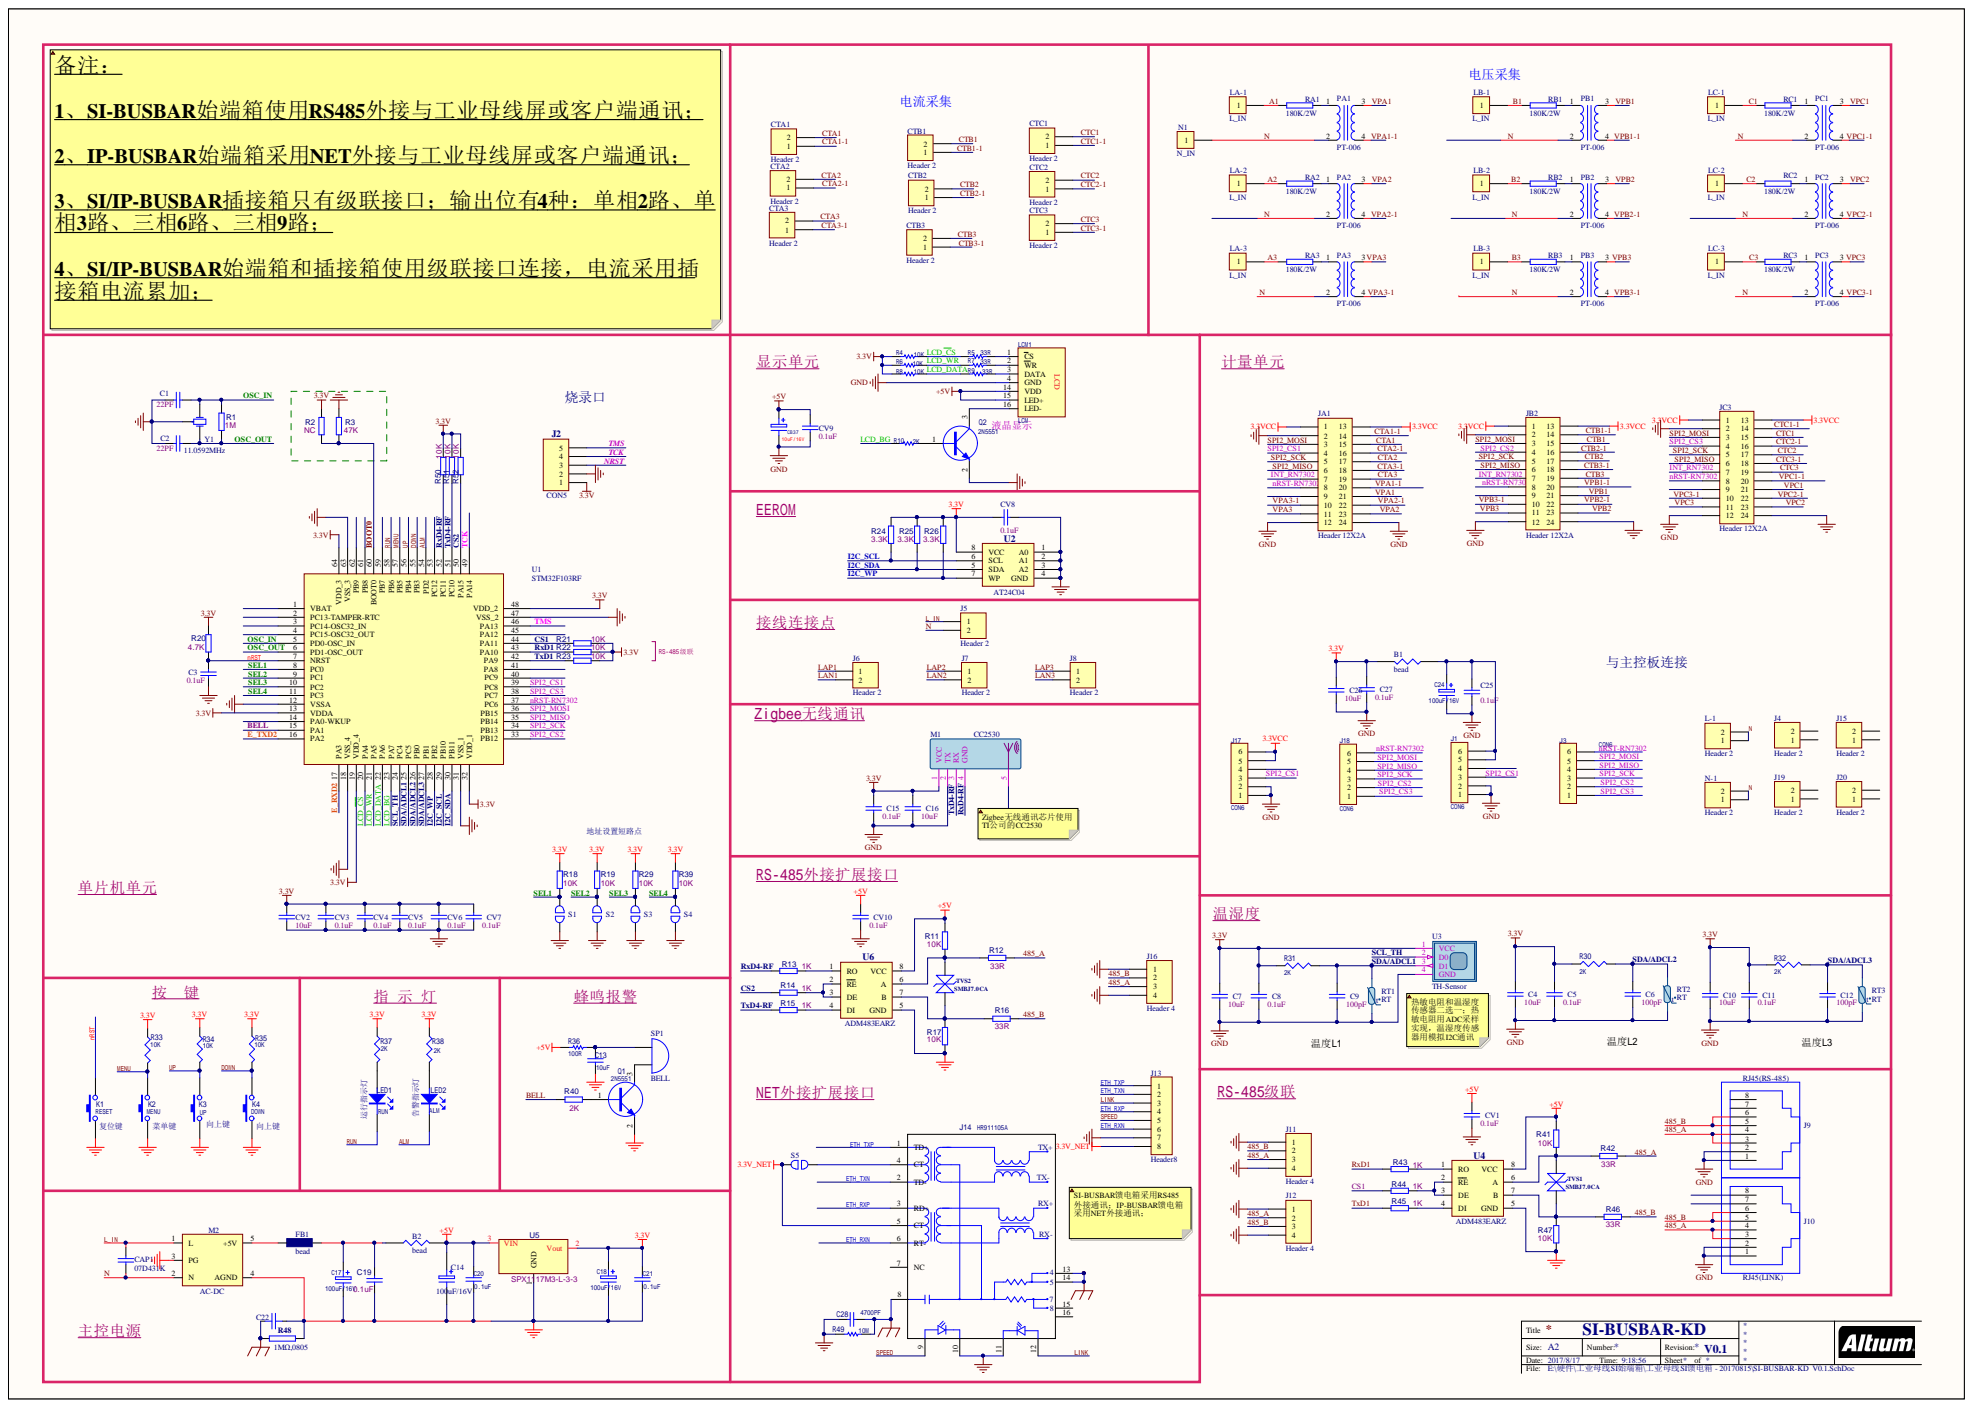
[picture p121: page 1]

4、SI/IP-BUSBAR始端箱和插接箱使用级联接口连接，电流采用插
接箱电流累加；

E:\硬件\工业母线SI始端箱\工业母线SI馈电箱 - 20170815\SI-BUSBAR-KD V0.1.SchDoc
