ChinaClever/CleverDoc/公司文件/研发相关/克莱沃与原要求冲突或不完善解决流程.pdf

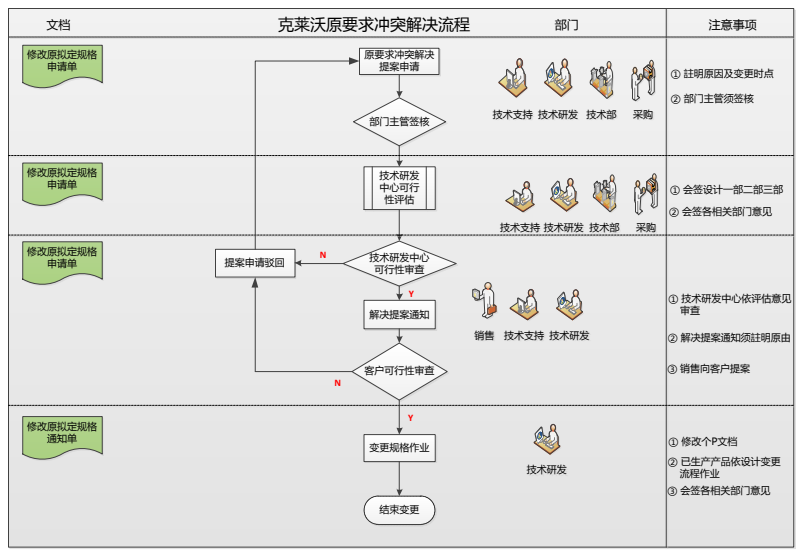
[picture p122: page 1]
原要求冲突解决 提案申请; 部门主管签核; 技术研发 中心可行 性评估; 技术研发中心 可行性审查; 解决提案通知; 变更规格作业; 结束变更; 克莱沃原要求冲突解决流程; 注意事项; 修改原拟定规格 申请单; 修改原拟定规格 通知单; 技技术术支支持持; 技技术术研研发发; 技技术术研研发发 技技术术部部; 采采购购; ① 註明原因及变更时点; ② 部门主管须签核; 技技术术支支持持 技技术术研研发发 技技术术部部; ① 会签设计一部二部三部; ② 会签各相关部门意见; ① 技术研发中心依评估意见 审查; ② 解决提案通知须註明原由; ① 修改个P文档; ② 已生产产品依设计变更 流程作业; 提案申请驳回; ③ 销售向客户提案; 销销售售; 客户可行性审查; ③ 会签各相关部门意见
