ChinaClever/CleverDoc/公司文件/研发相关/克莱沃在售产品可靠性测试流程.pdf

文档 | 克莱沃在售产品可靠性测试流程 | 部门 | 注意事项

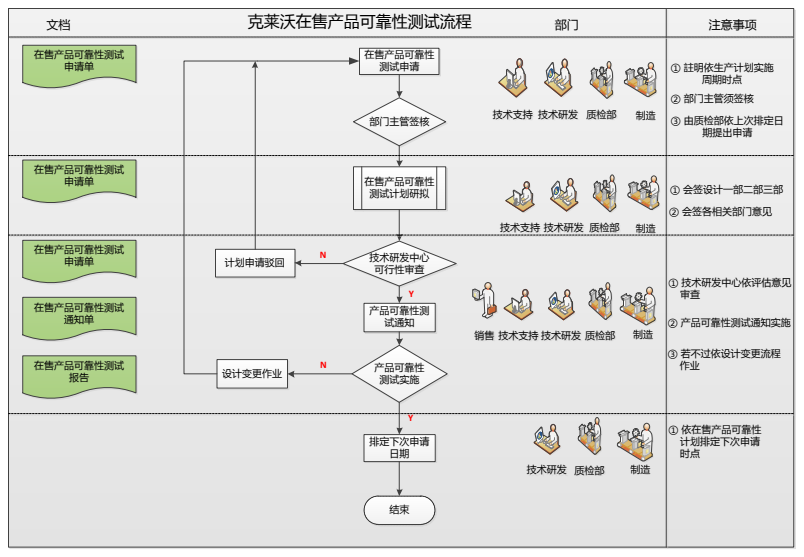
[picture p123: page 1]
在售产品可靠性 测试申请; 部门主管签核; 在售产品可靠性 测试计划研拟; 技术研发中心 可行性审查; 产品可靠性测 试通知; 排定下次申请 日期; 在售产品可靠性测试 申请单; 技技术术支支持持; 技技术术研研发发; 技技术术研研发发 质质检检部部; ① 註明依生产计划实施 周期时点; ② 部门主管须签核; ① 会签设计一部二部三部; ② 会签各相关部门意见; ① 技术研发中心依评估意见 审查; ② 产品可靠性测试通知实施; ① 依在售产品可靠性 计划排定下次申请 时点; 计划申请驳回; 销销售售; 产品可靠性 测试实施; 设计变更作业; 质质检检部部; ③ 由质检部依上次排定日 期提出申请; ③ 若丌过依设计变更流程 作业; 在售产品可靠性测试 通知单; 在售产品可靠性测试 报告

技术支持 技术研发 质检部
