ChinaClever/CleverDoc/MPDU/MPDU 2017产品资料/包装图纸/2017智能产品(MPDU、RPDU、ZPDU)包装盒及缓冲纸皮(16A、32A)2265-175-135.pdf

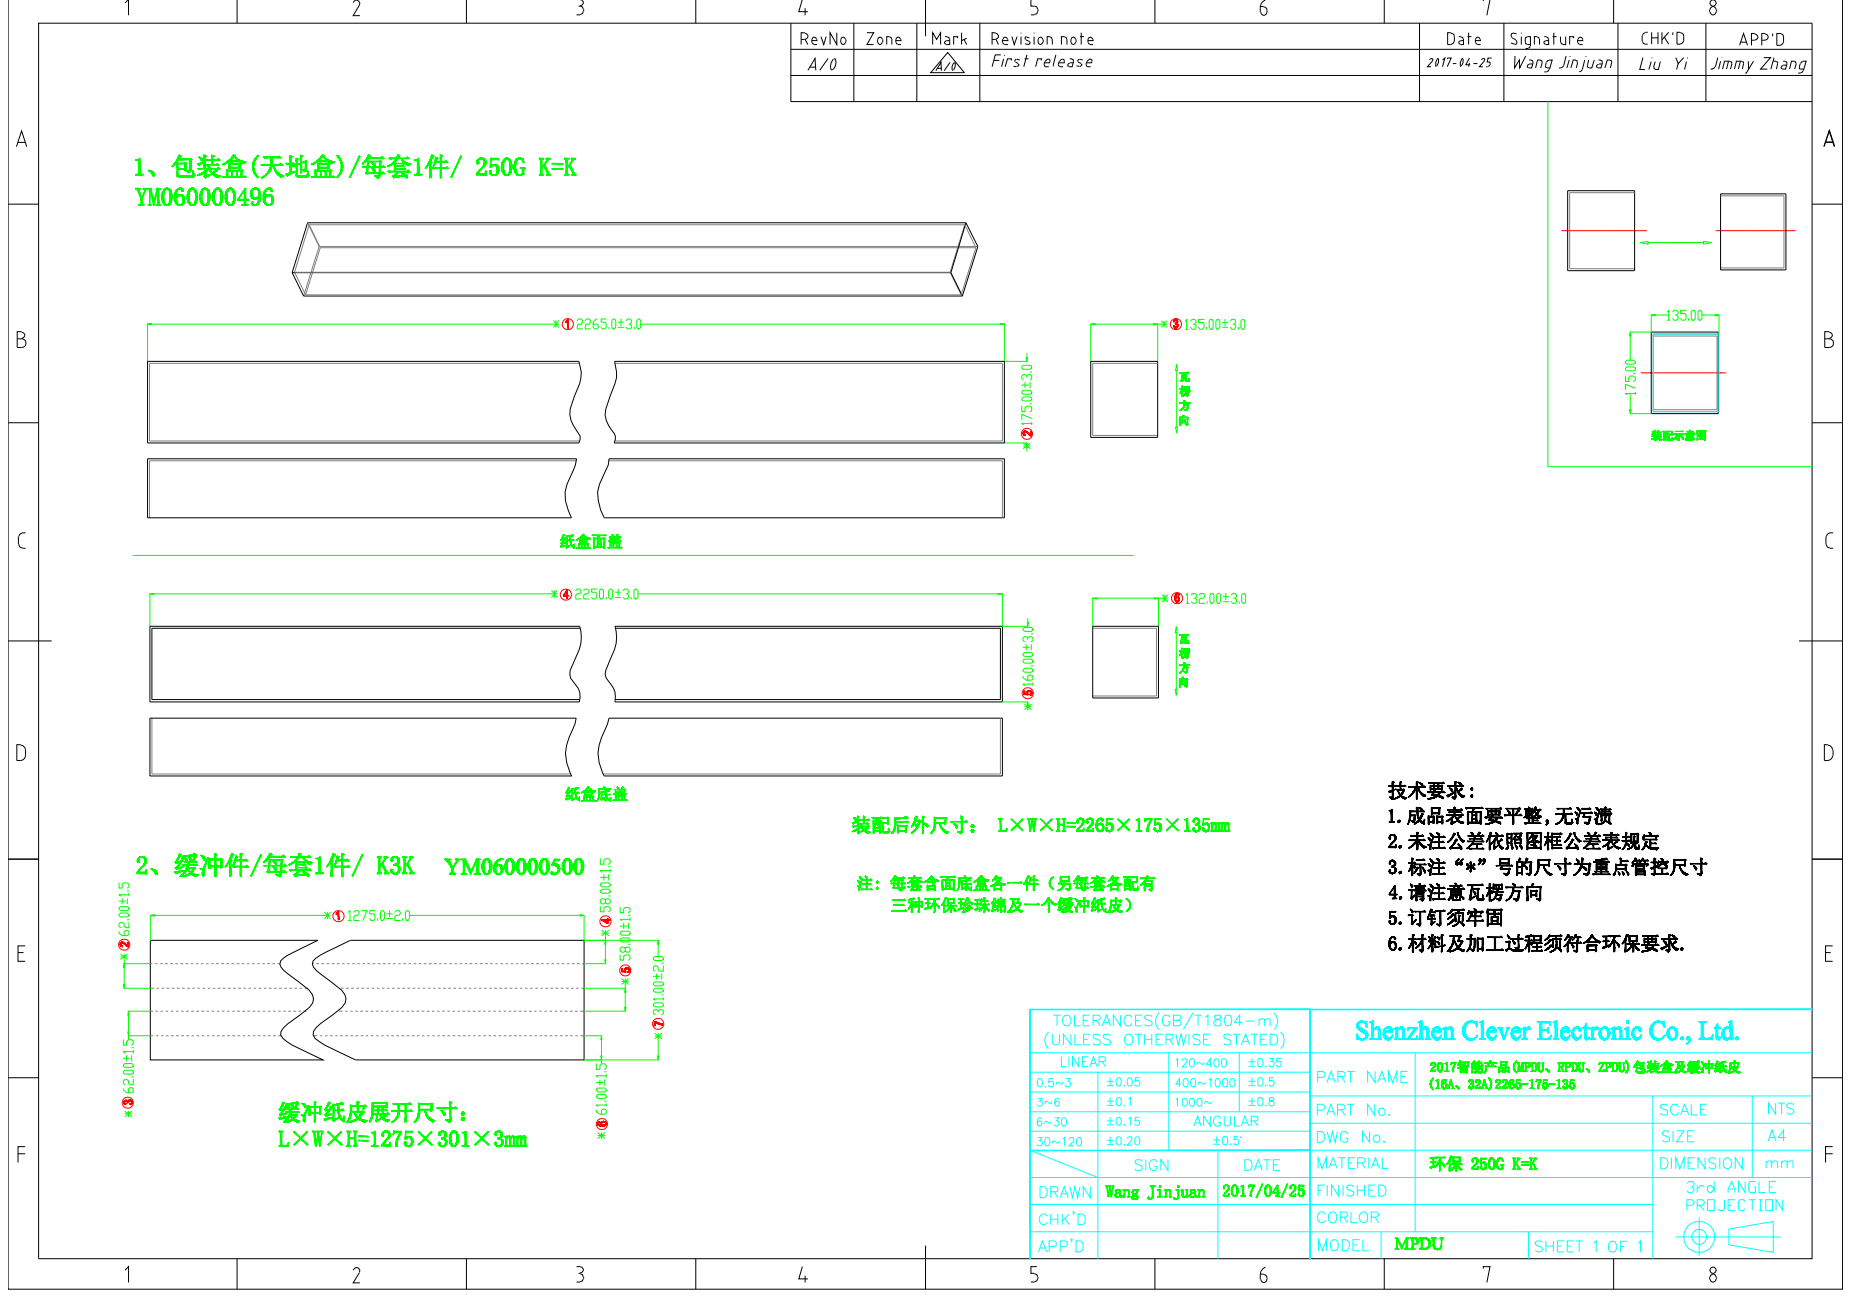
[picture p125: page 1]
