ChinaClever/CleverDoc/MPDU/MPDU 2017产品资料/包装图纸/2017智能产品(MPDU、RPDU、ZPDU)包装盒及缓冲纸皮(63A)2355-175-135.pdf

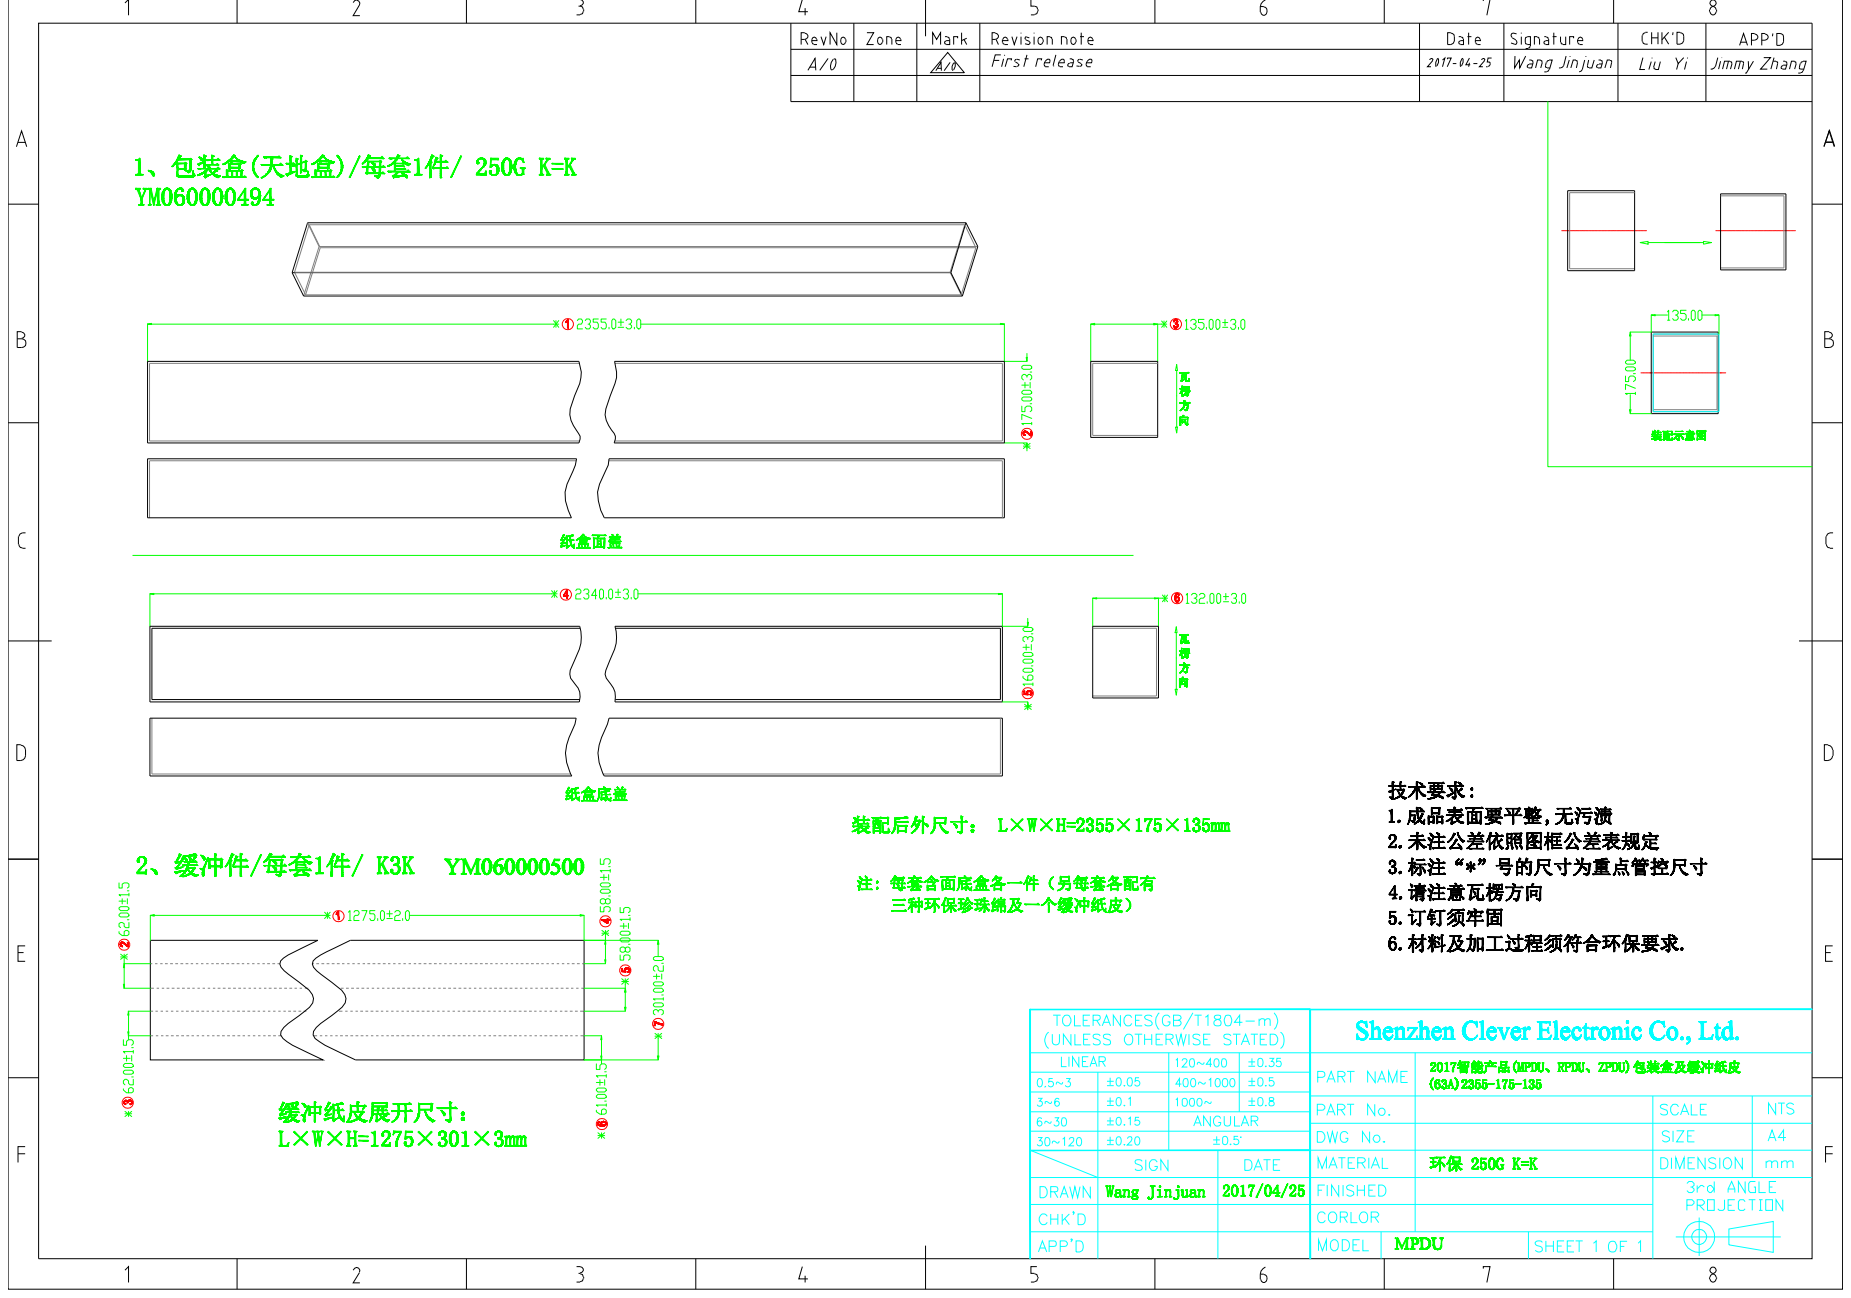
[picture p126: page 1]
