ChinaClever/CleverDoc/MPDU/MPDU 2017产品资料/包装图纸/2017智能产品(MPDU、RPDU、ZPDU)外包装箱(16A、32A)2290-385-295.pdf

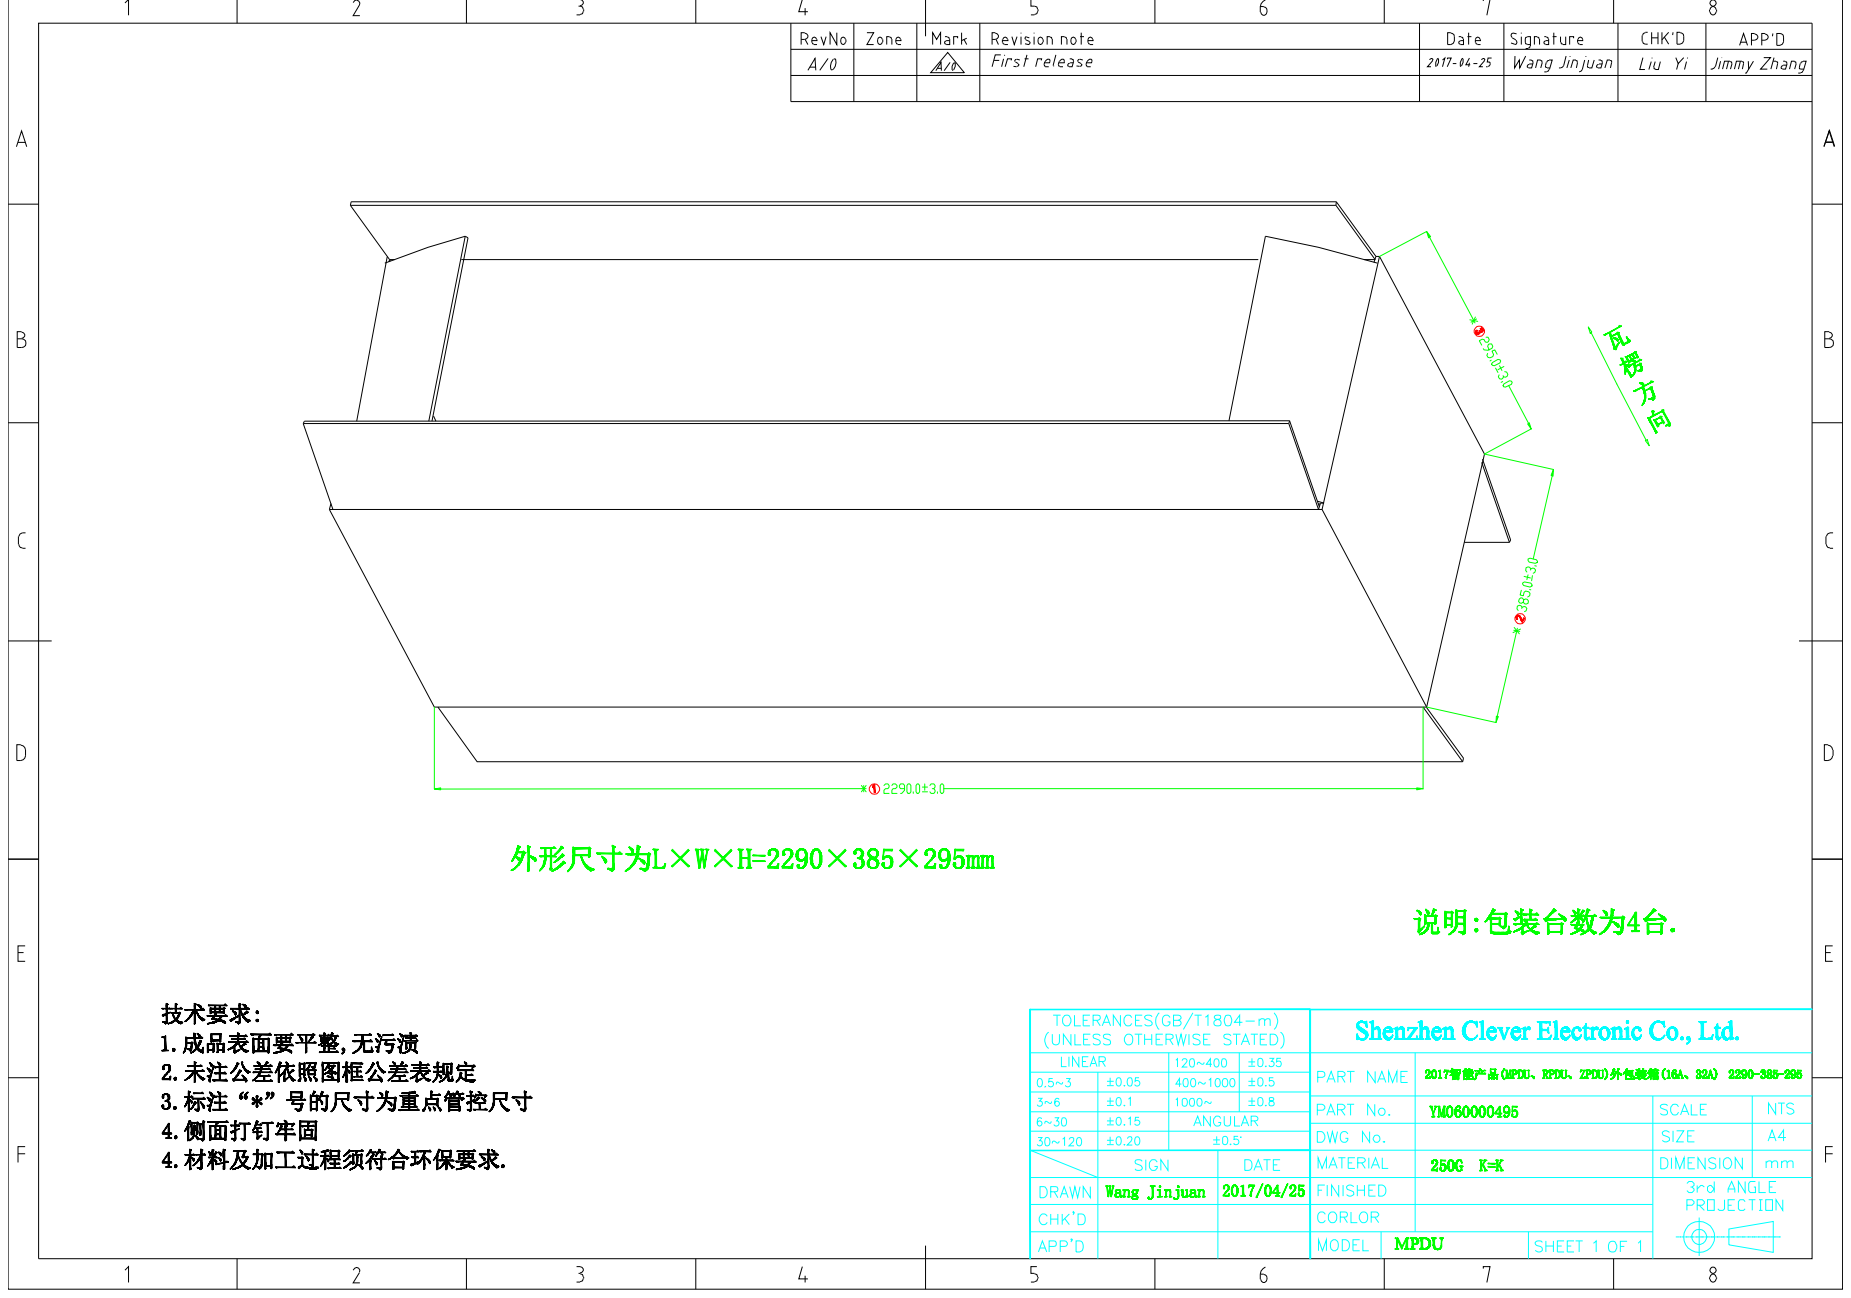
[picture p127: page 1]
