ChinaClever/CleverDoc/MPDU/MPDU 2017产品资料/包装图纸/2017智能产品(MPDU、RPDU、ZPDU)外包装箱(63A)2380-385-295.pdf

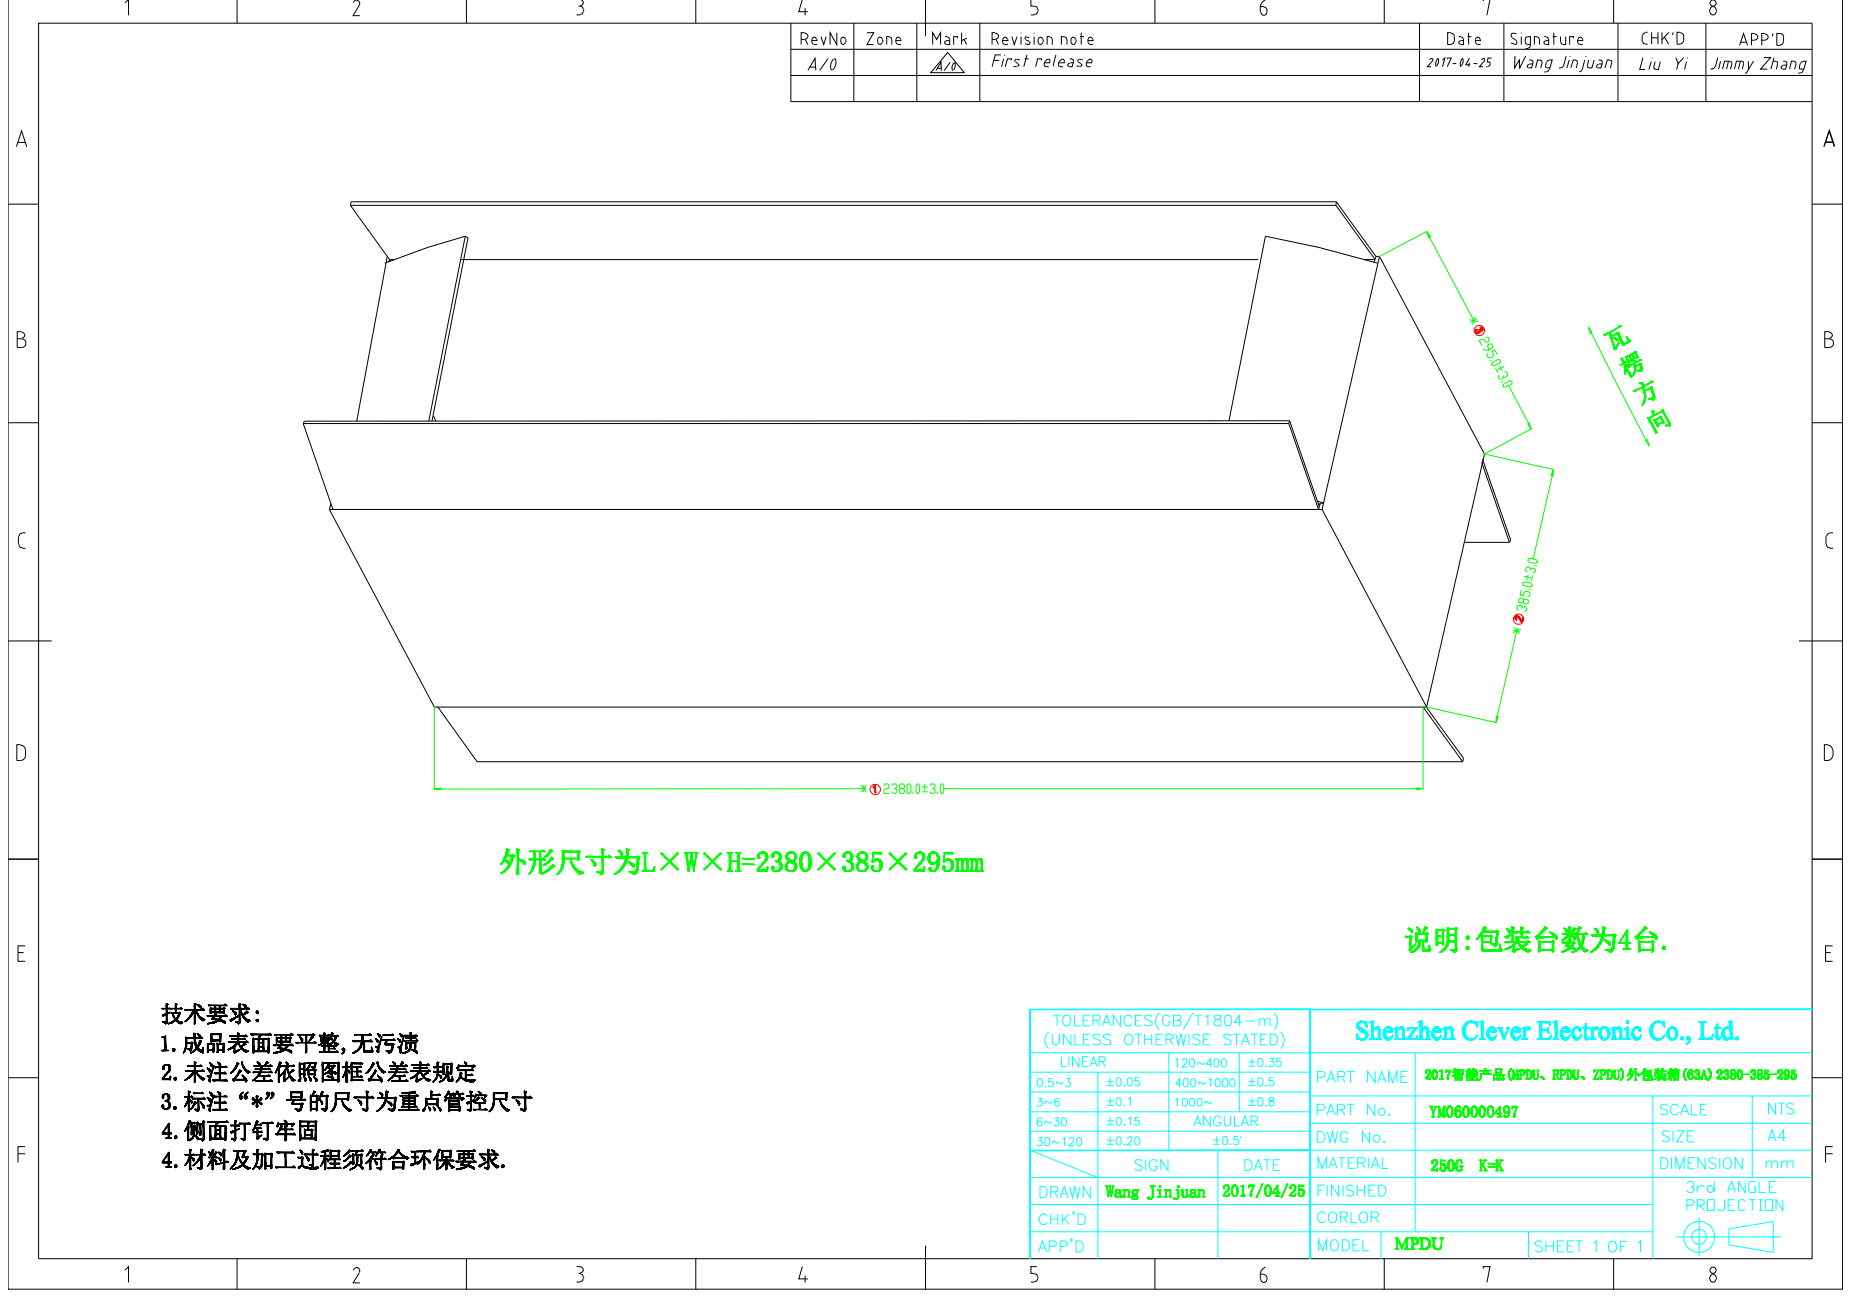
[picture p128: page 1]
