ChinaClever/CleverDoc/MPDU/MPDU 2017产品资料/包装图纸/2017智能产品(MPDU、RPDU、ZPDU)盒内缓冲珍珠棉.pdf

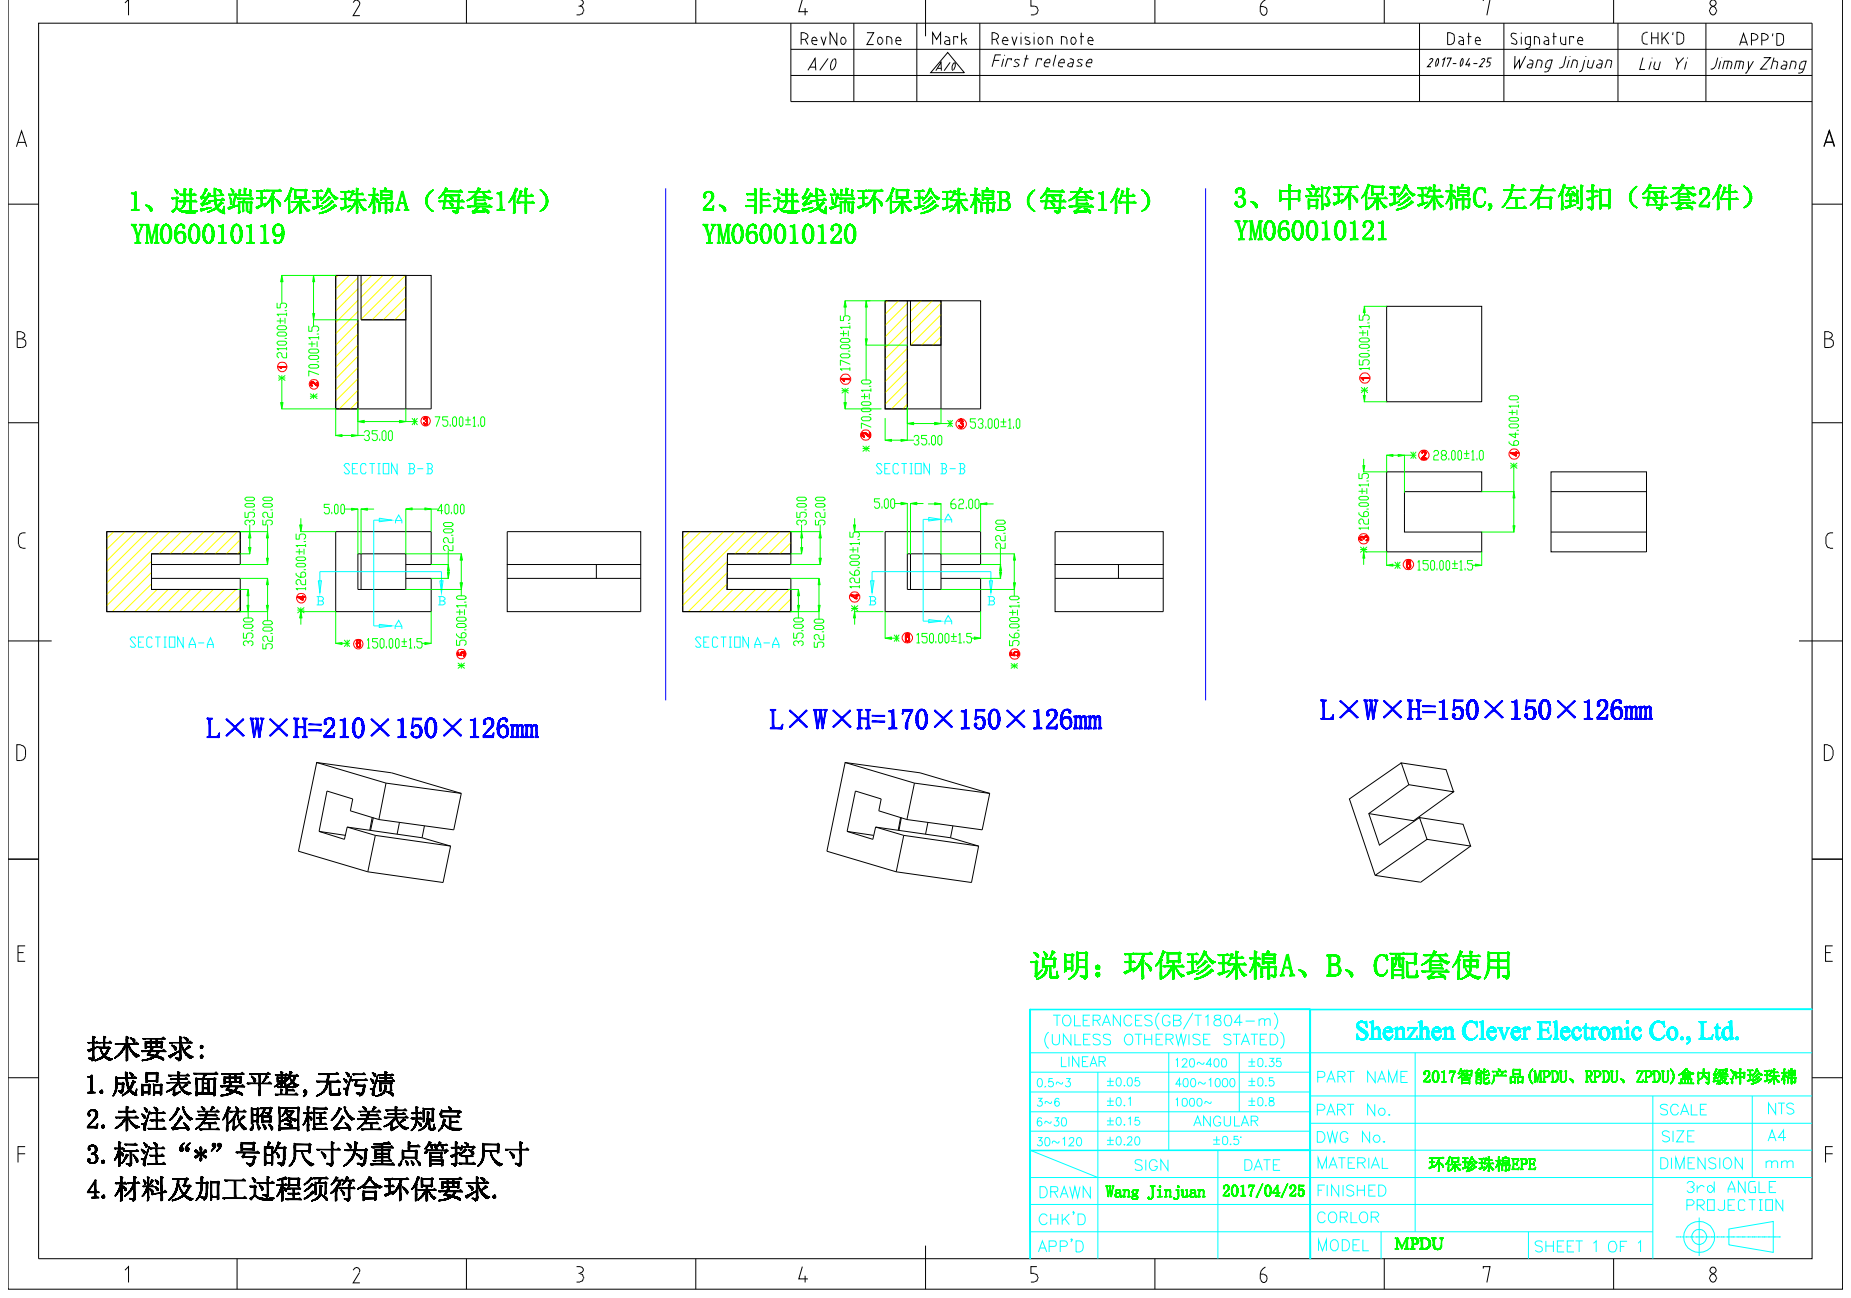
[picture p129: page 1]
