ChinaClever/CleverDoc/MPDU/MPDU 2017产品资料/包装图纸/YM060010122-2017智能产品珍珠棉堵头150-126-50.pdf

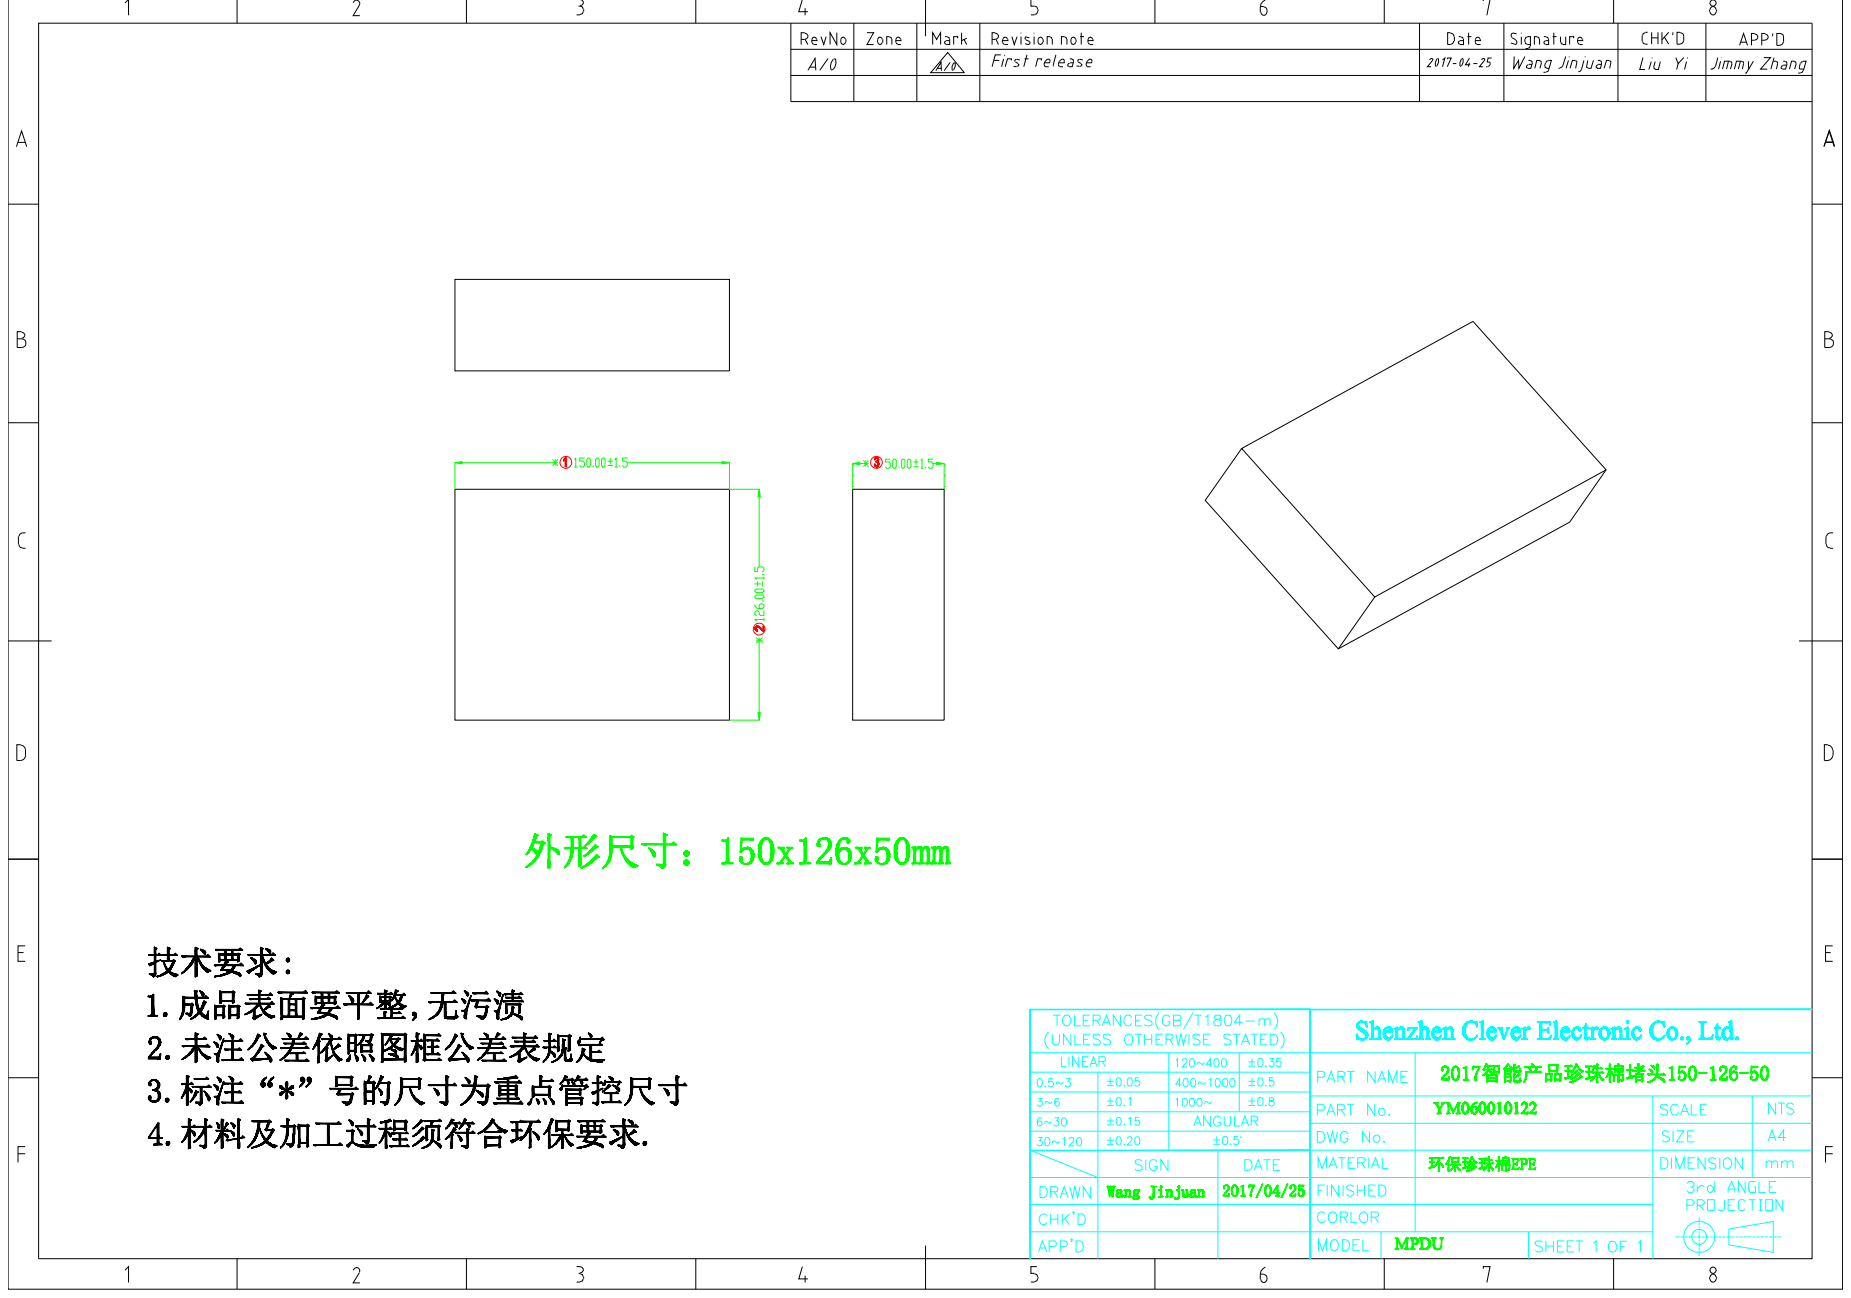
[picture p130: page 1]
