ChinaClever/CleverDoc/MPDU/MPDU 2017产品资料/原理图/MPDU 2017执行板宽版2-20170208.pdf

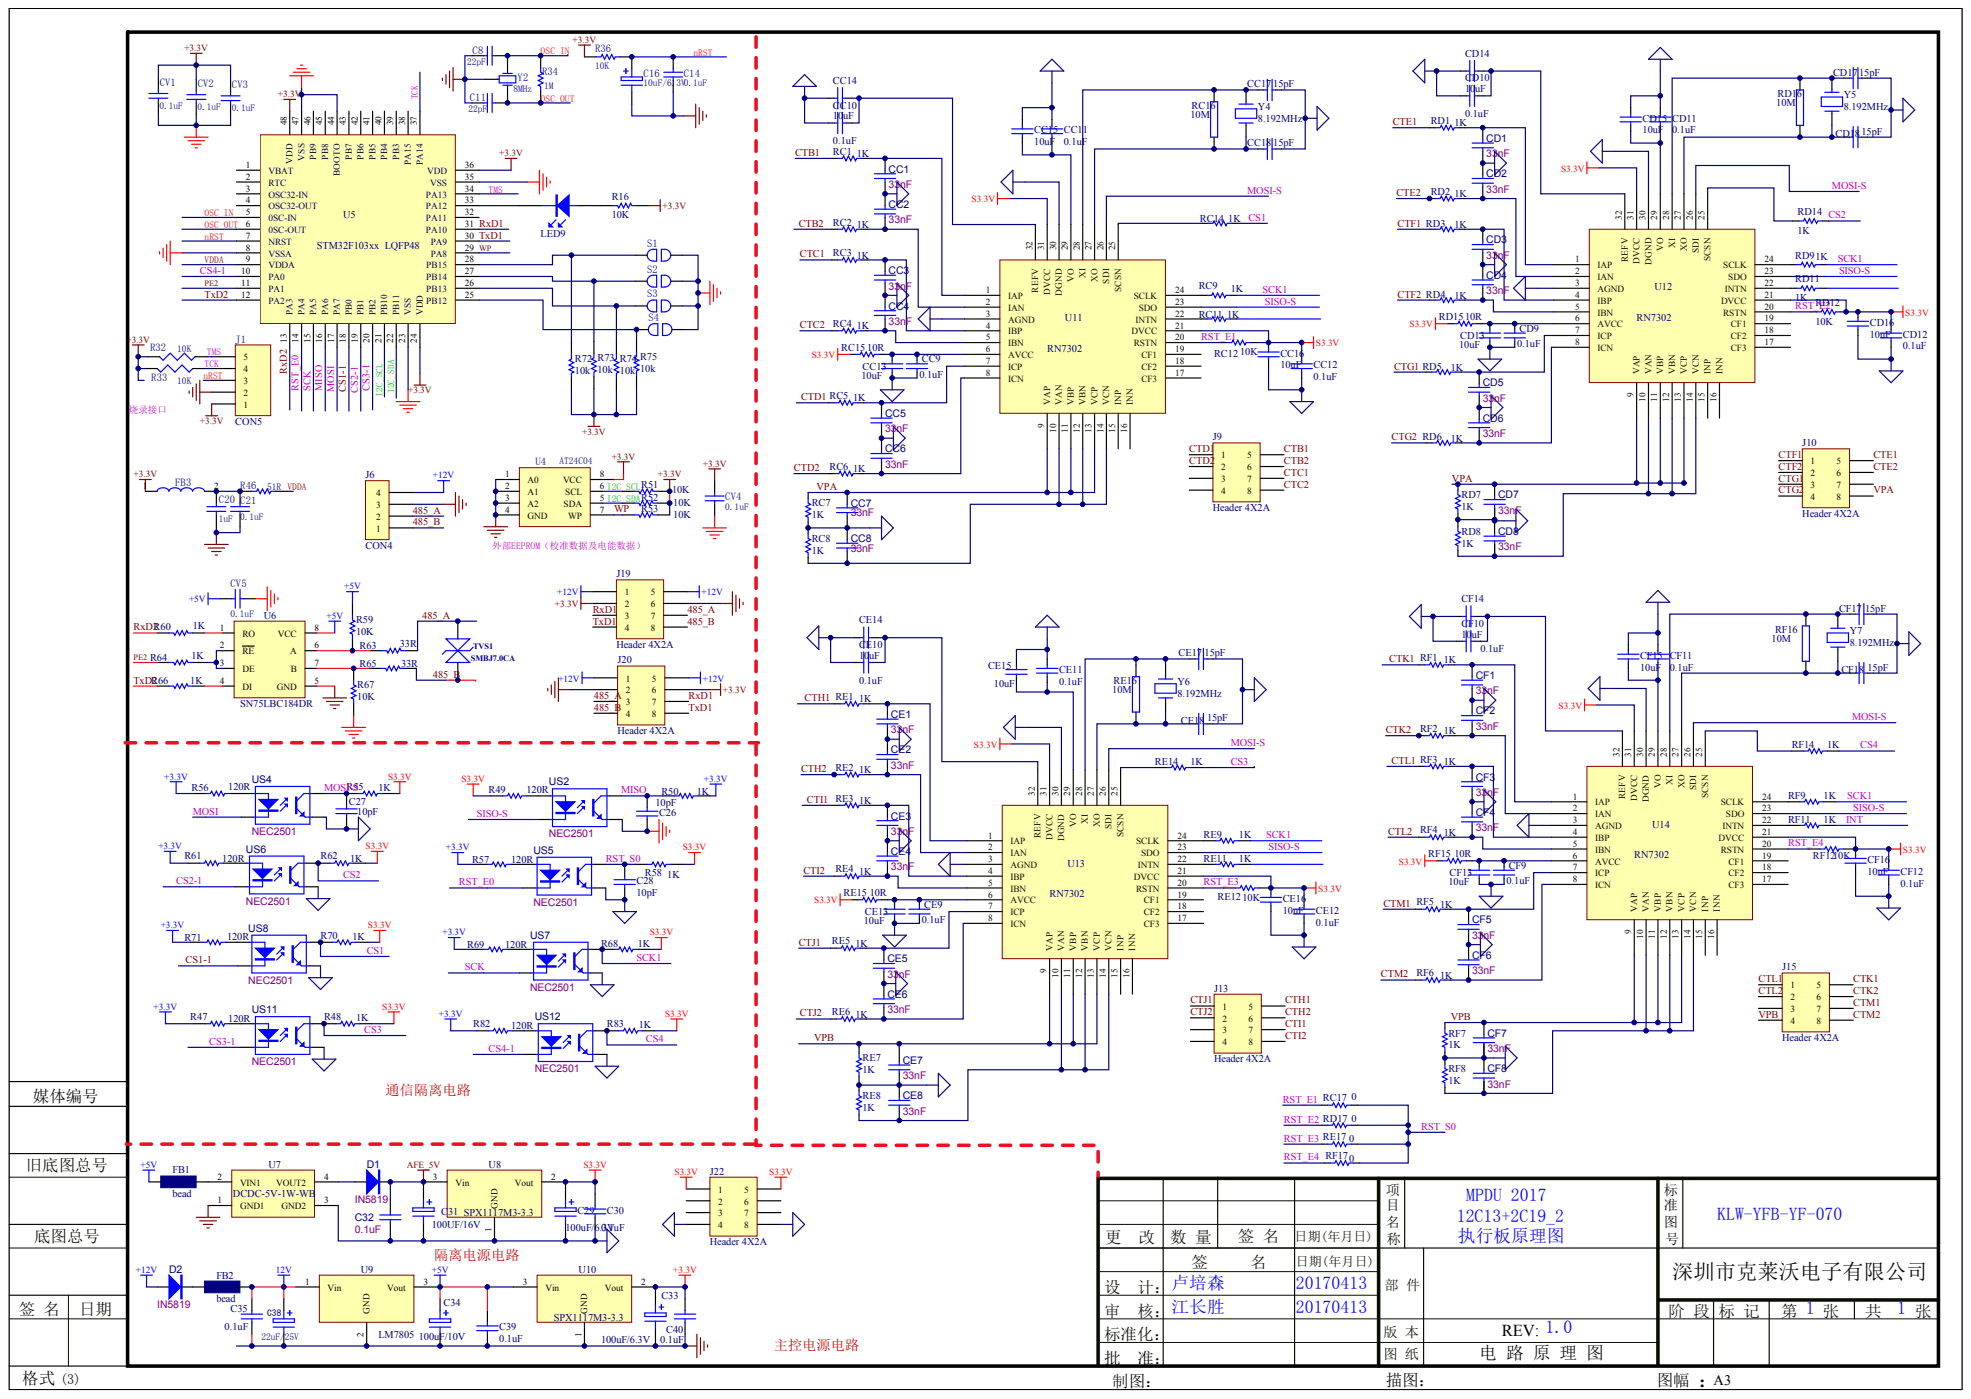
[picture p131: page 1]

AGND 3 | RC11 1K
IBP 4 | | CD9 | ICP 7

IBP 4

AGND 3 | RE11 1K

更 改 | 数 量 | 签 名 | 日期(年月日)

名 | 日期(年月日) | 部 件 | 深圳市克莱沃电子有限公司 签

标准化： | 版 本 | 1.0 REV:
批 准： | 图 纸 | 电 路 原 理 图
