ChinaClever/CleverDoc/MPDU/MPDU 2017产品资料/原理图/MPDU2017执行板4c13-4c19.pdf

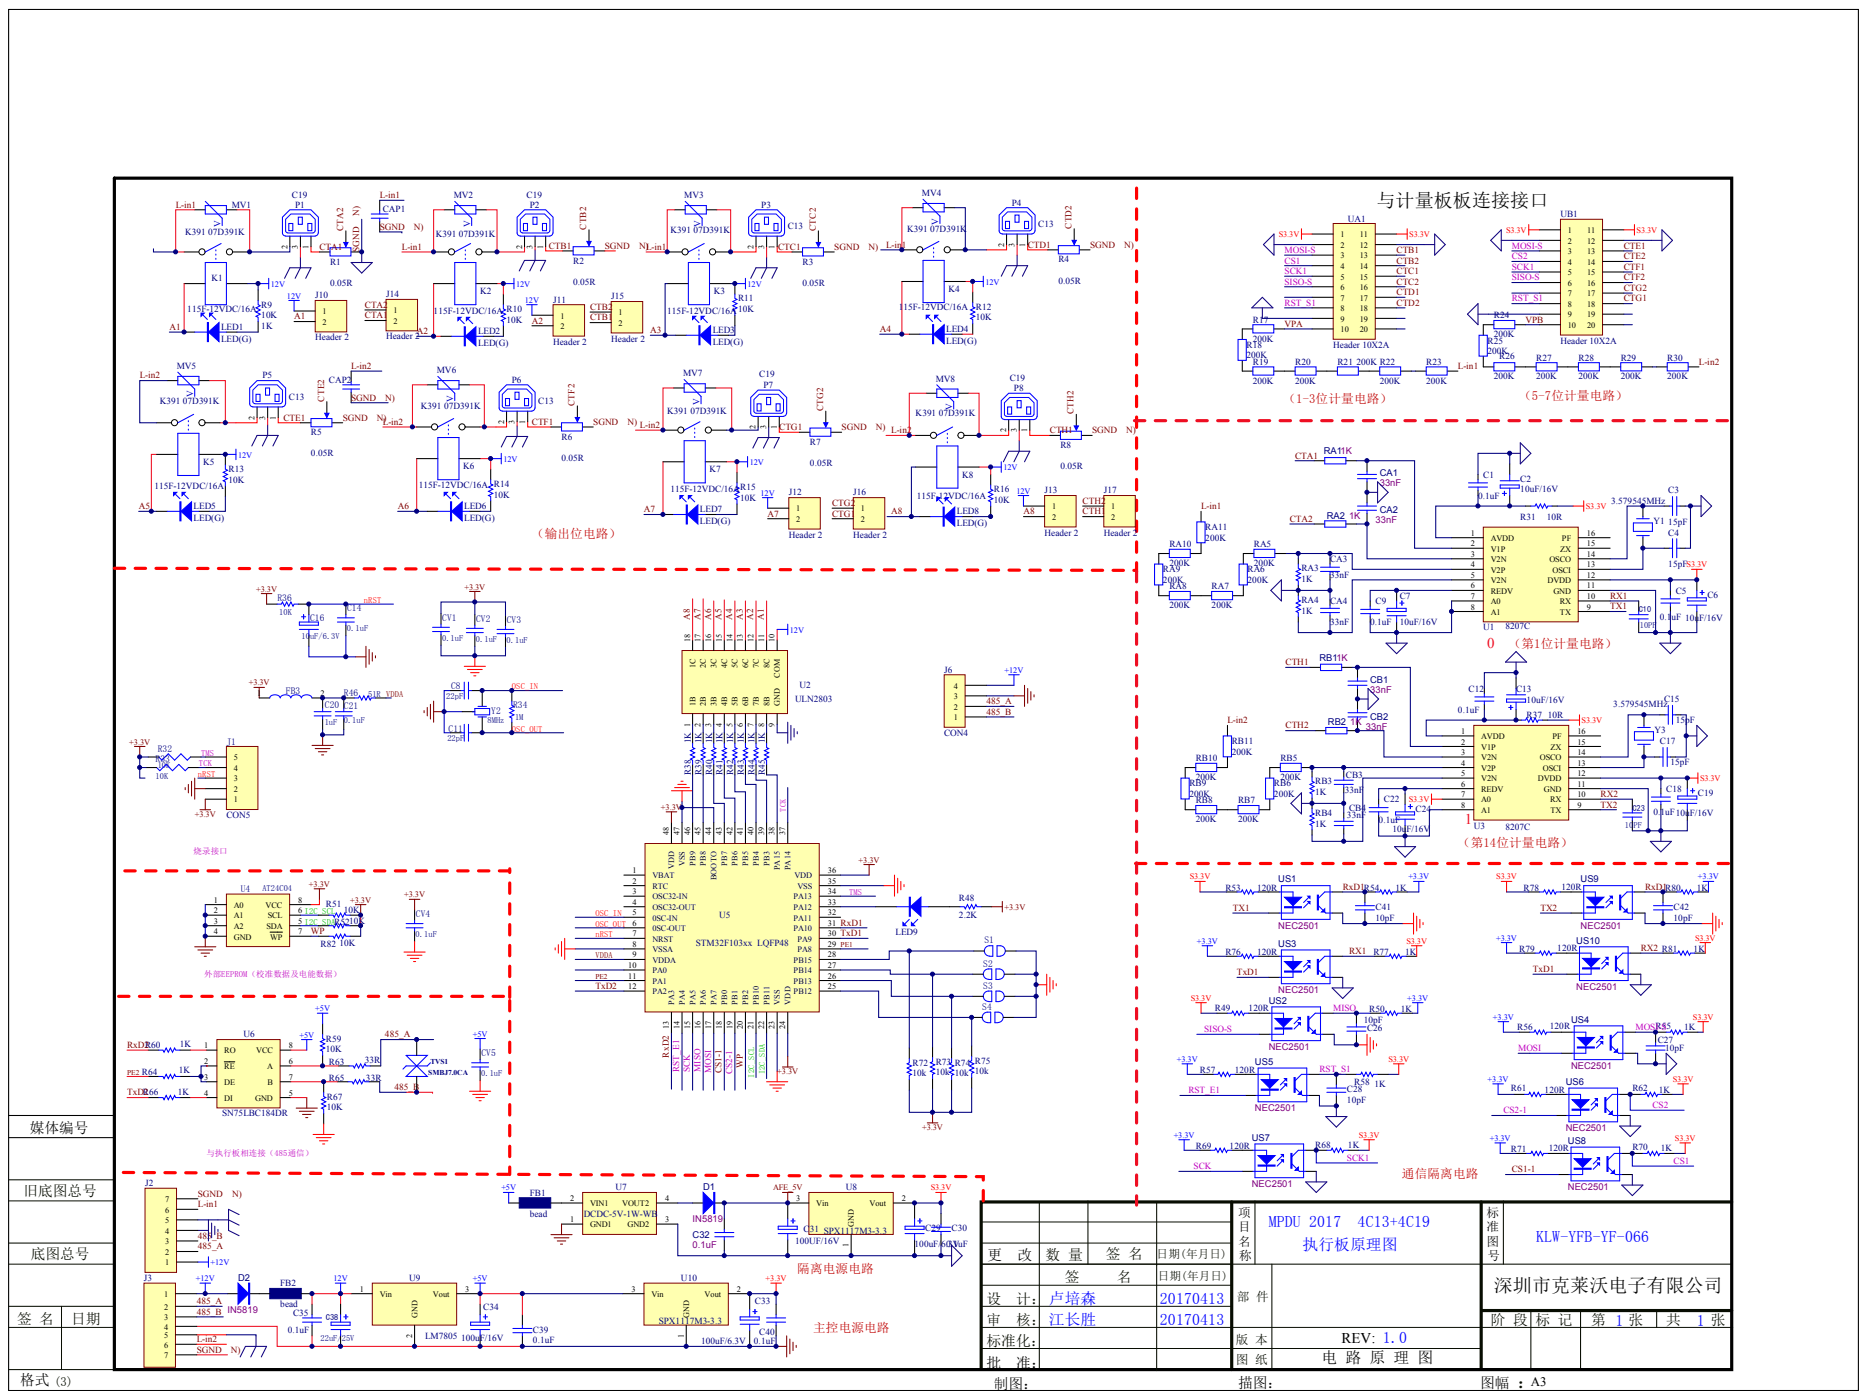
[picture p132: page 1]

REDV 6

名 | 日期(年月日) | 部 件 | 深圳市克莱沃电子有限公司 签
