ChinaClever/CleverDoc/MPDU/MPDU 2017产品资料/原理图/MPDU2017执行板宽版1-20170208.pdf

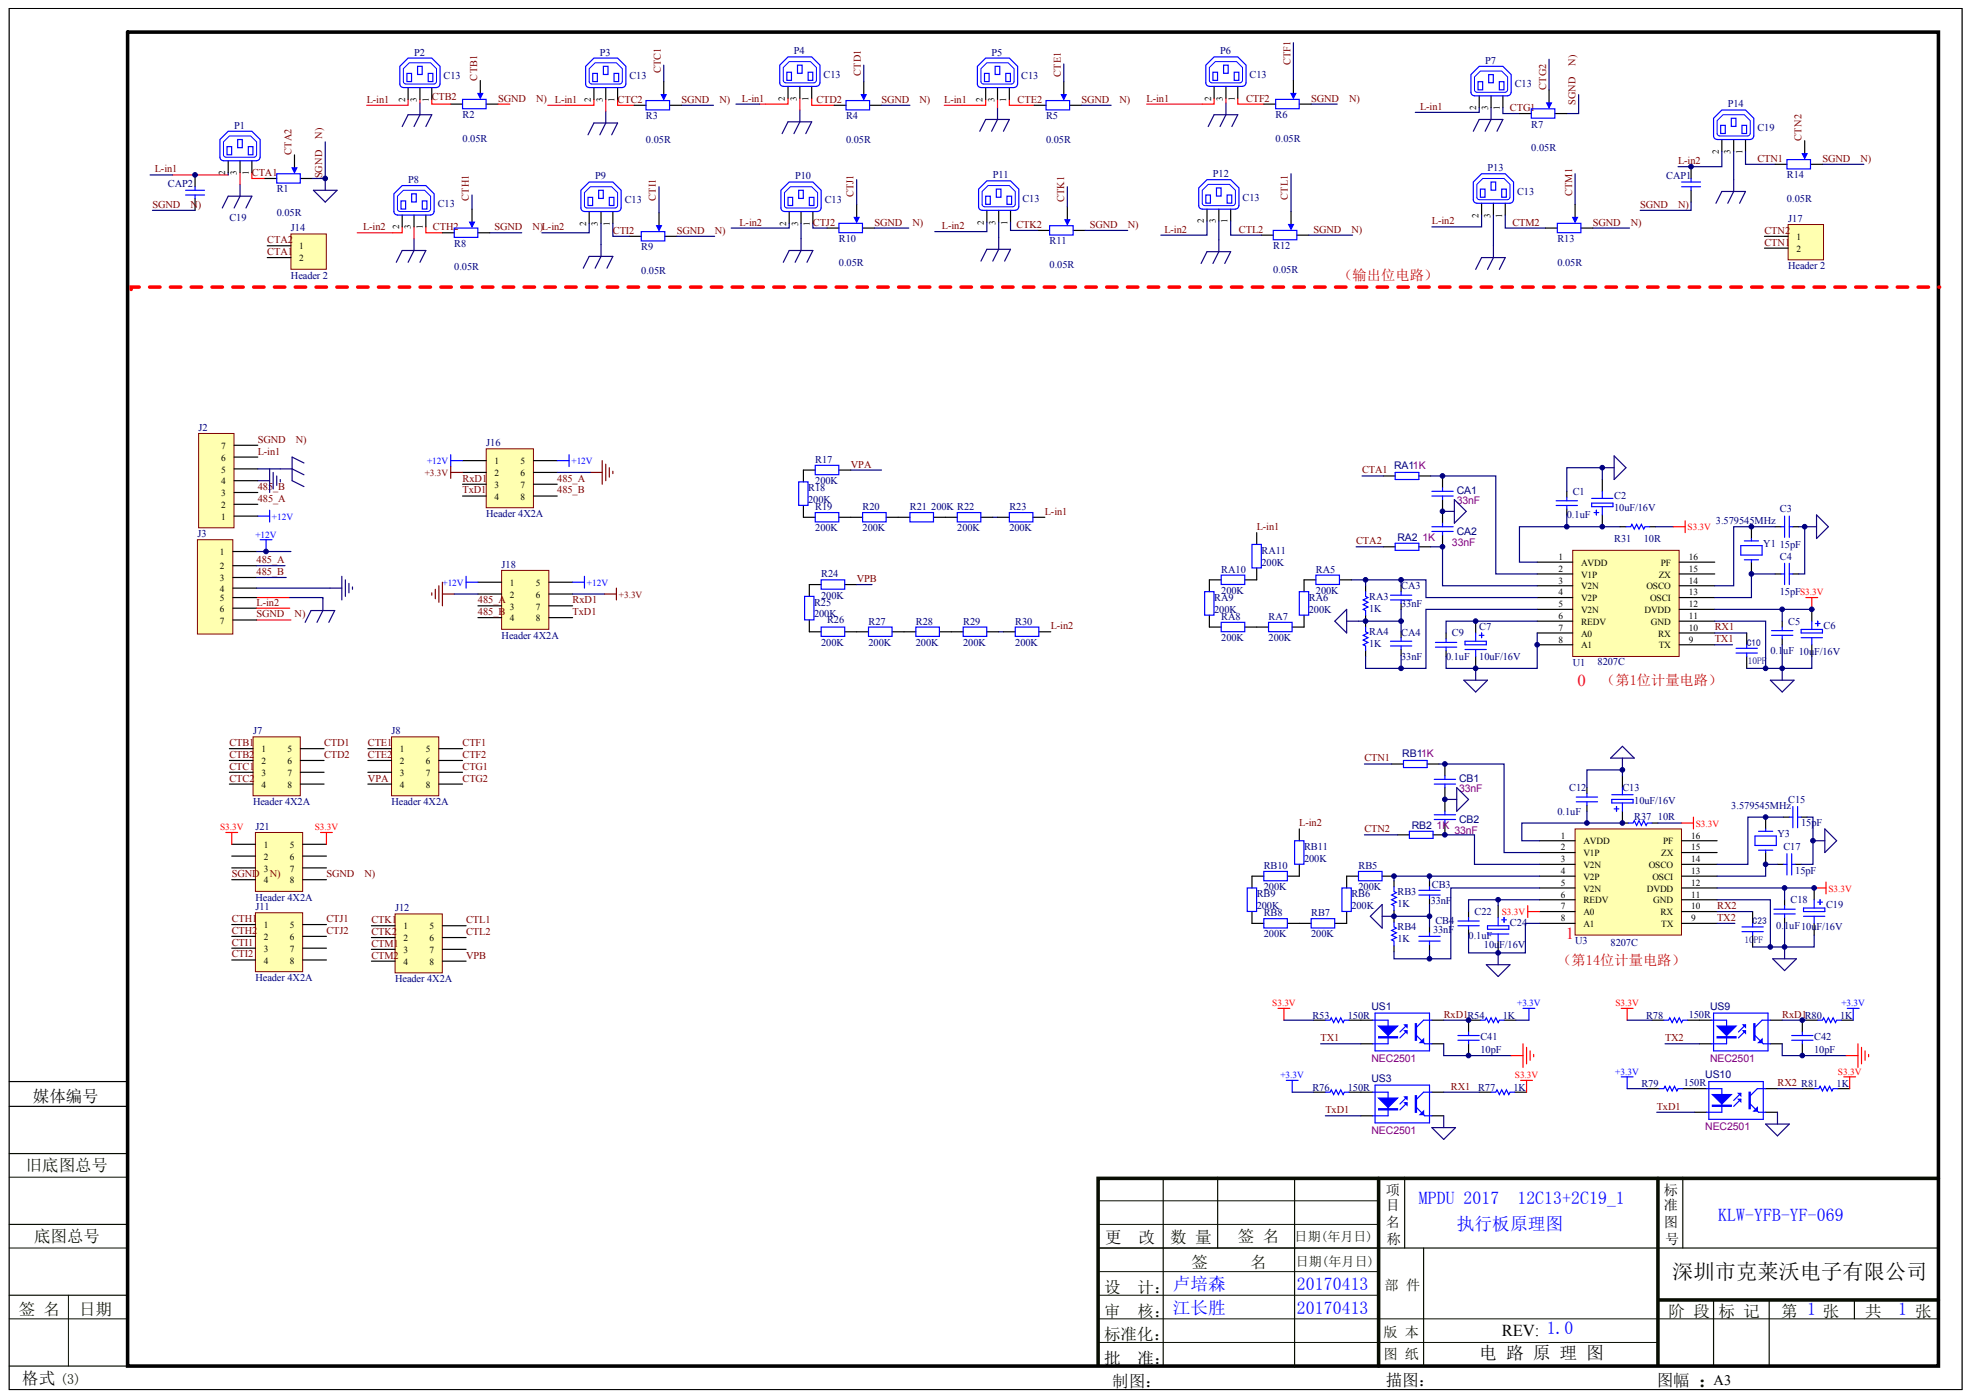
[picture p135: page 1]

REDV 6
A0 7 | RX2

项 目 名 称 | MPDU 2017 12C13+2C19_1 执行板原理图 | 标 准 图 号 | KLW-YFB-YF-069

更 改 | 数 量 | 签 名 | 日期(年月日)

名 | 日期(年月日) | 部 件 | 深圳市克莱沃电子有限公司 签

设 计： | 卢培森 | 20170413
审 核： | 江长胜 | 20170413 | | | 阶 段 | 标 记 | 1 第 张 | 1 共 张
标准化： | | | 版 本 | 1.0 REV:
批 准： | | | 图 纸 | 电 路 原 理 图
