ChinaClever/CleverDoc/MPDU/MPDU 2017产品资料/原理图/MPDU执行板 -7302.pdf

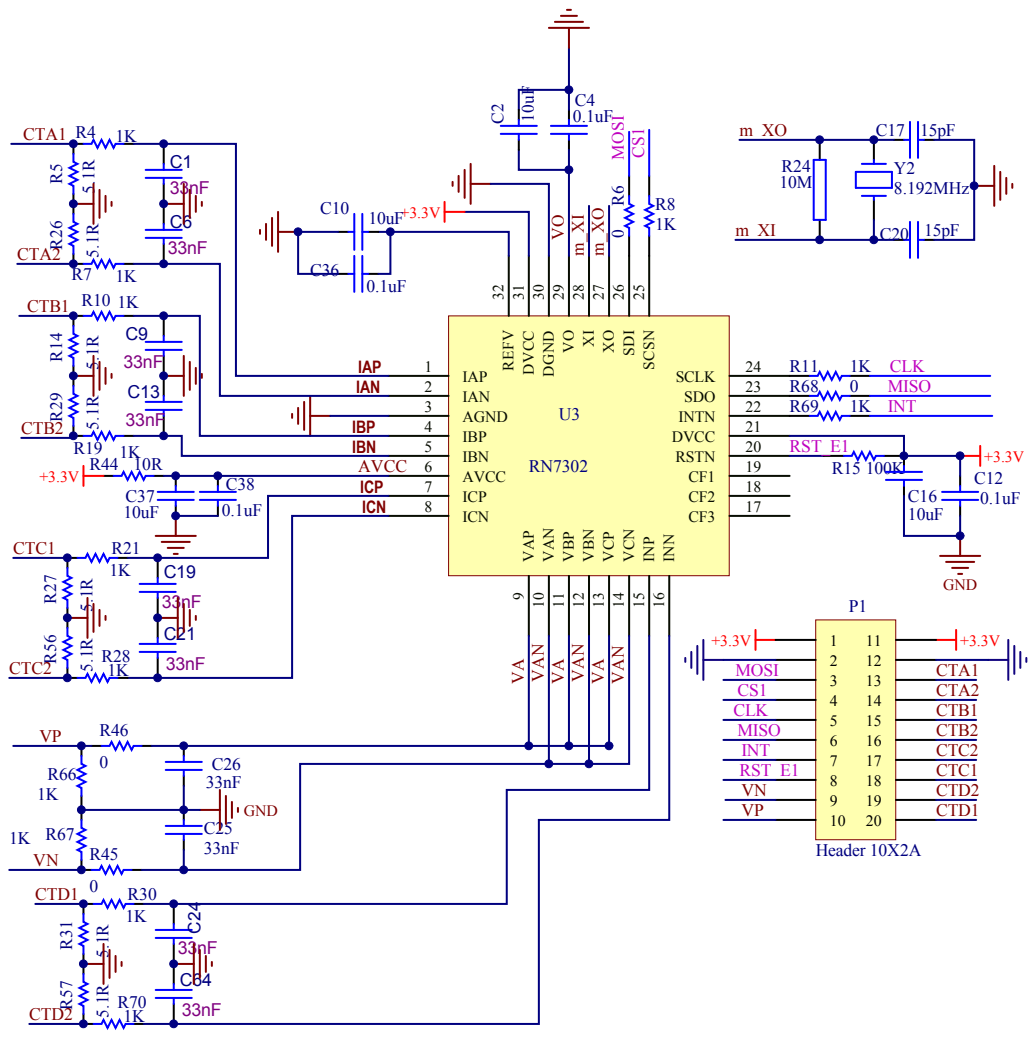
[picture p136: page 1]

C13 | IAN | IAN 2

AGND 3

C26 | INT

项 目 名 称 | MPDU 2017 -RN7302 原理图 | 标 准 图 号 | KLW-YFB-YF-071

更 改 | 数 量 | 签 名 | 日期(年月日)

名 | 日期(年月日) | 部 件 | 深圳市克莱沃电子有限公司 签

设 计： | 卢培森 | 20170413
审 核： | 江长胜 | 20170413 | | | 阶 段 | 标 记 | 第 1 张 | 共 1 张
标准化： | | | 版 本 | 1.0 REV:
批 准： | | | 图 纸 | 电 路 原 理 图
