ChinaClever/CleverDoc/MPDU/MPDU 2017产品资料/结构图/MPDU 2017结构图.pdf

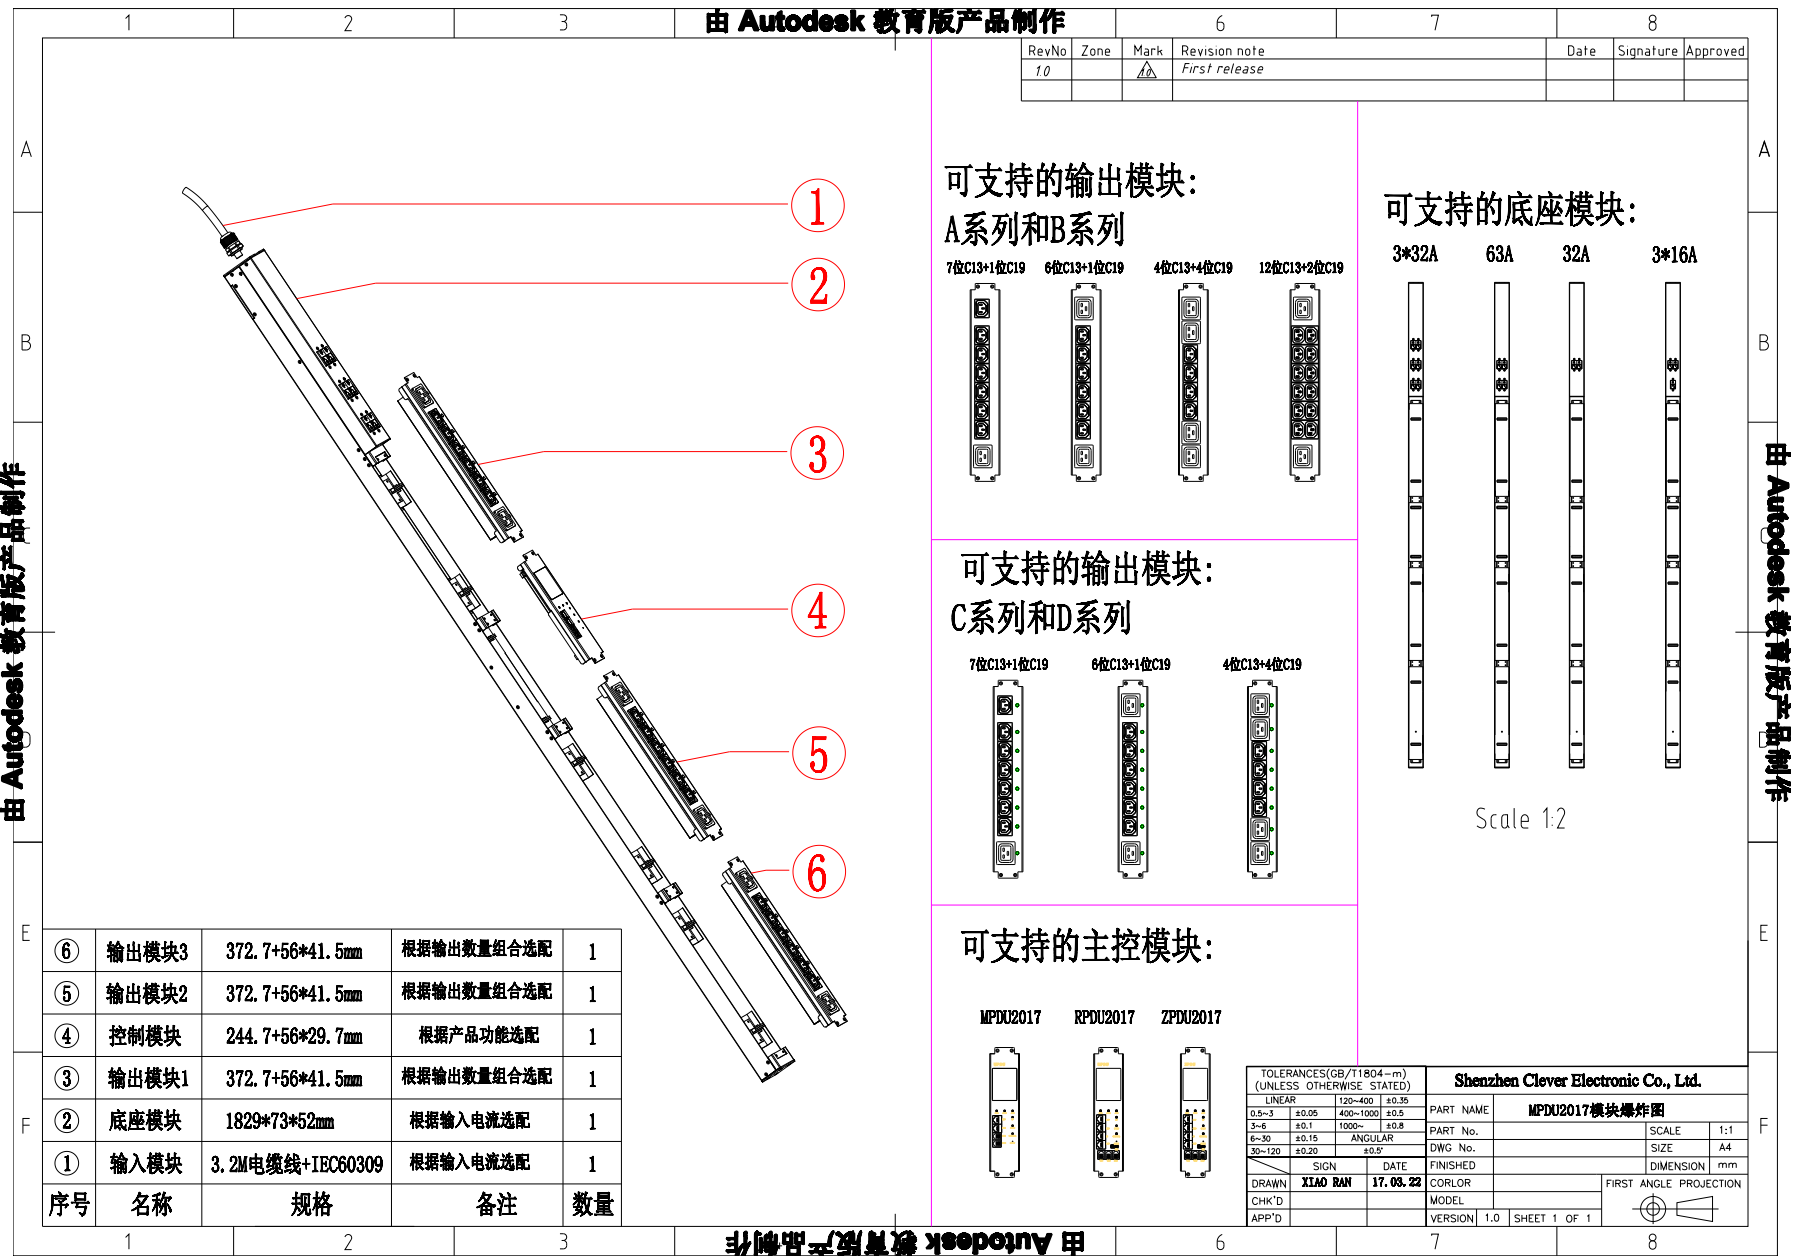
[picture p137: page 1]
