ChinaClever/CleverDoc/MPDU/MPDU 2017产品资料/丝印图纸/输入模块/20170516--2017智能产品输入面壳丝印图-32A.pdf

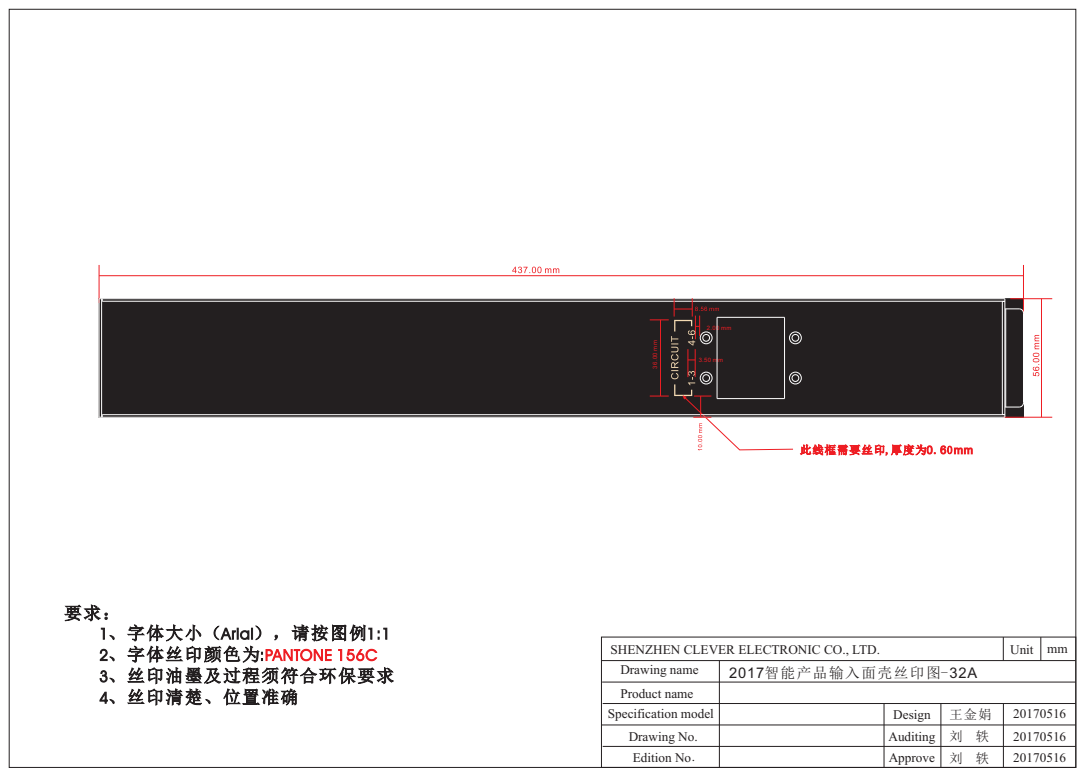
[picture p138: page 1]
Product name; Specification model; Design; Auditing; Approve; Edition No.; Drawing No.; Unit; 2017智能产品输入面壳丝印图-32A; 王金娟; 要求： 1、字体大小（Arial），请按图例1:1 2、字体丝印颜色为: 3、丝印油墨及过程须符合环保要求 4、丝印清楚、位置准确; PANTONE 156C

SHENZHEN CLEVER ELECTRONIC CO., LTD.
Drawing name
