ChinaClever/CleverDoc/MPDU/MPDU 2017产品资料/丝印图纸/插座模块/12+2/20170207--2017智能产品B系列输出模块丝印图-12位C13+2位C19  15-28.pdf

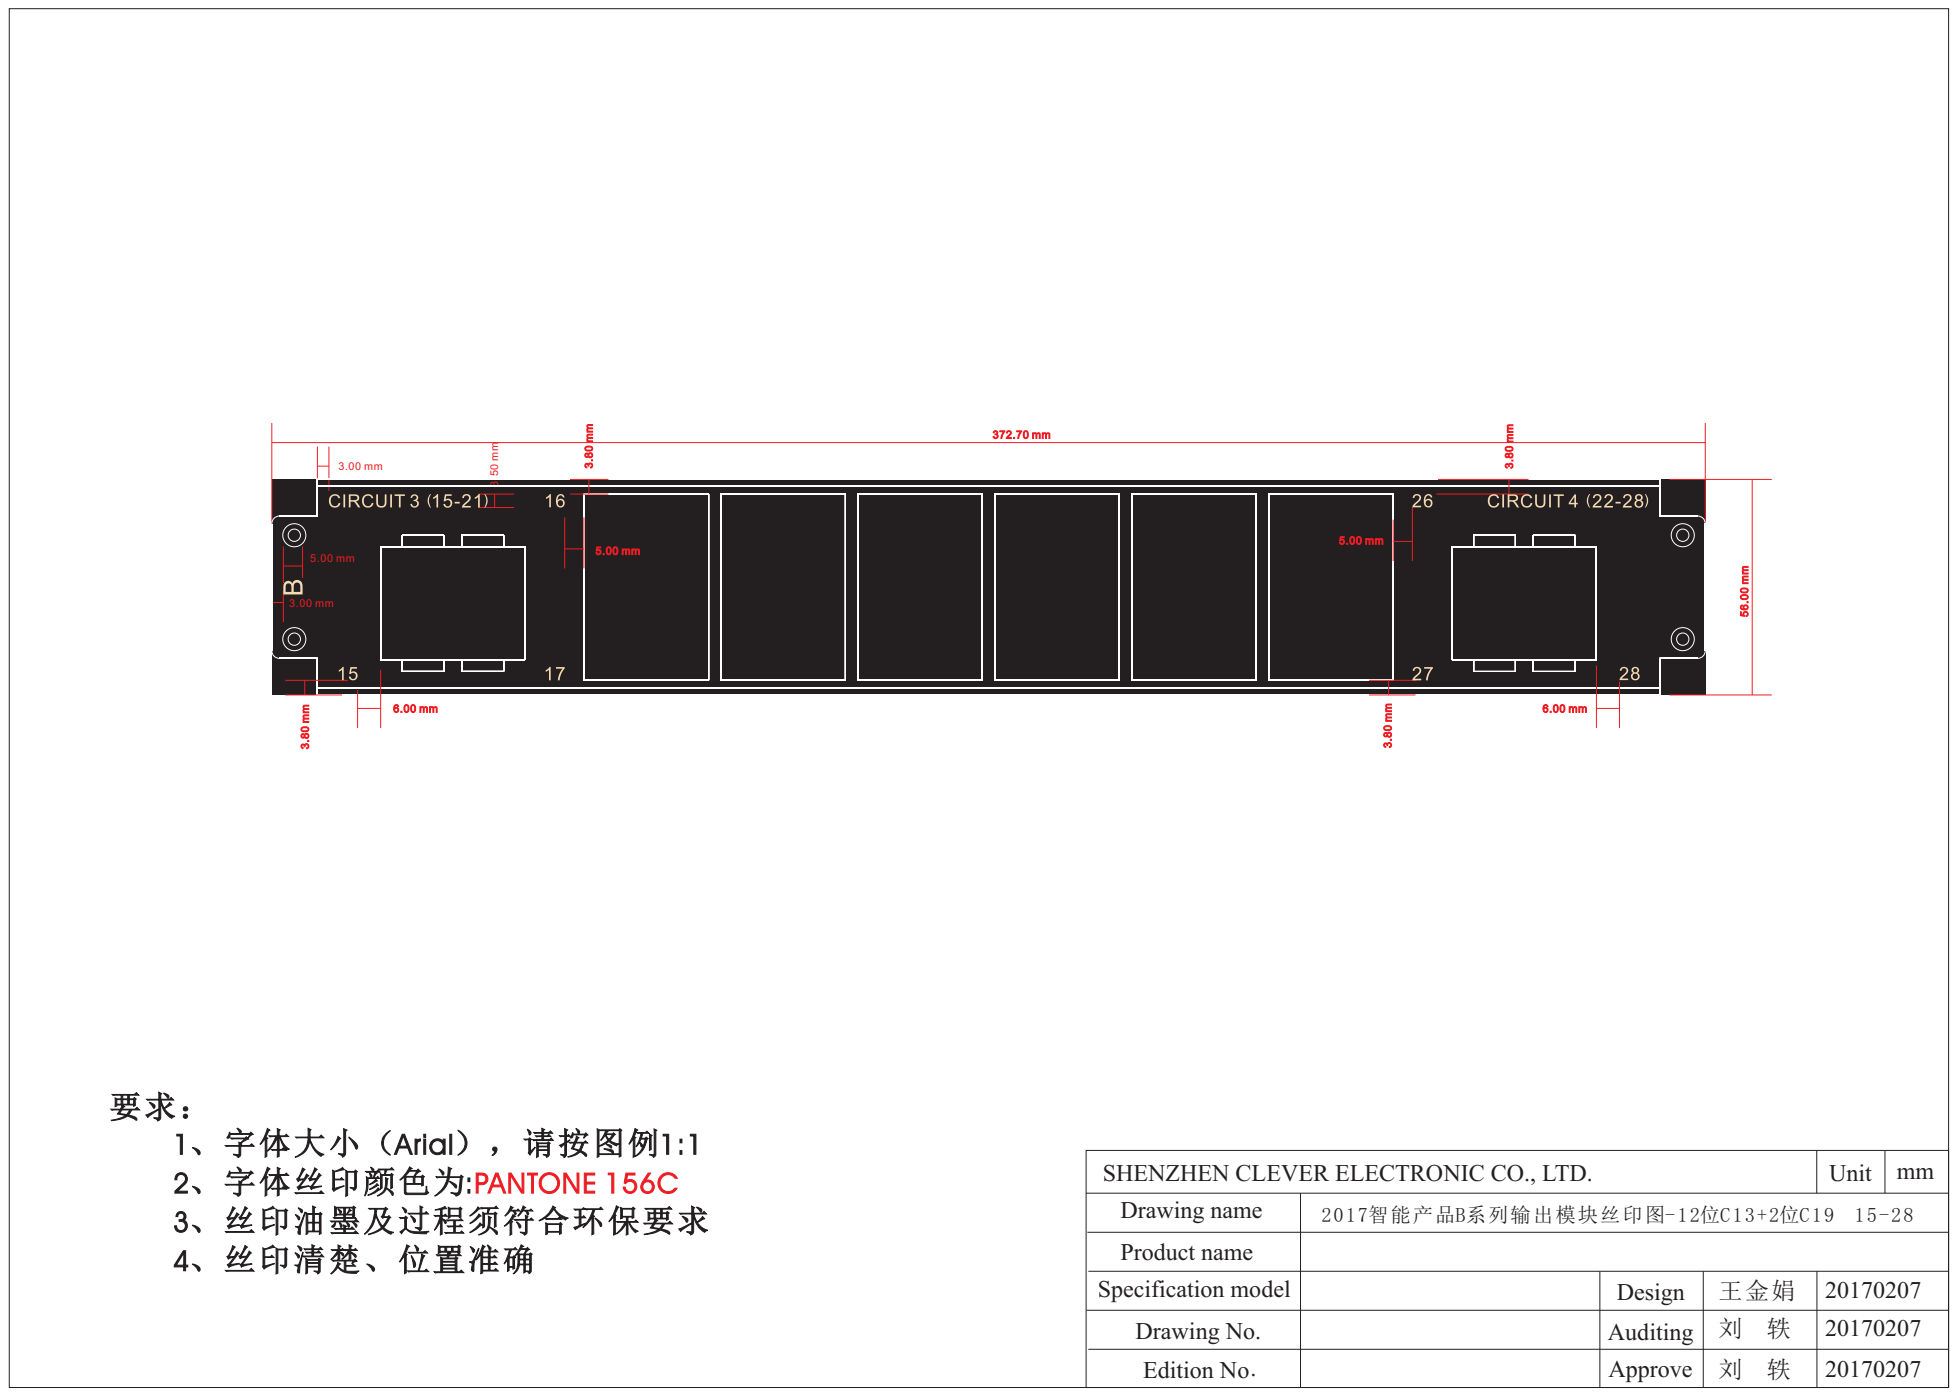
[picture p140: page 1]
Product name; Specification model; Design; Auditing; Approve; Edition No.; Drawing No.; Unit; 2017智能产品B系列输出模块丝印图-12位C13+2位C19 15-28; 王金娟; 要求： 1、字体大小（Arial），请按图例1:1 2、字体丝印颜色为: 3、丝印油墨及过程须符合环保要求 4、丝印清楚、位置准确; PANTONE 156C

SHENZHEN CLEVER ELECTRONIC CO., LTD.
Drawing name
