ChinaClever/CleverDoc/MPDU/MPDU 2017产品资料/PCB图/旧/C19-1-20170401.pdf

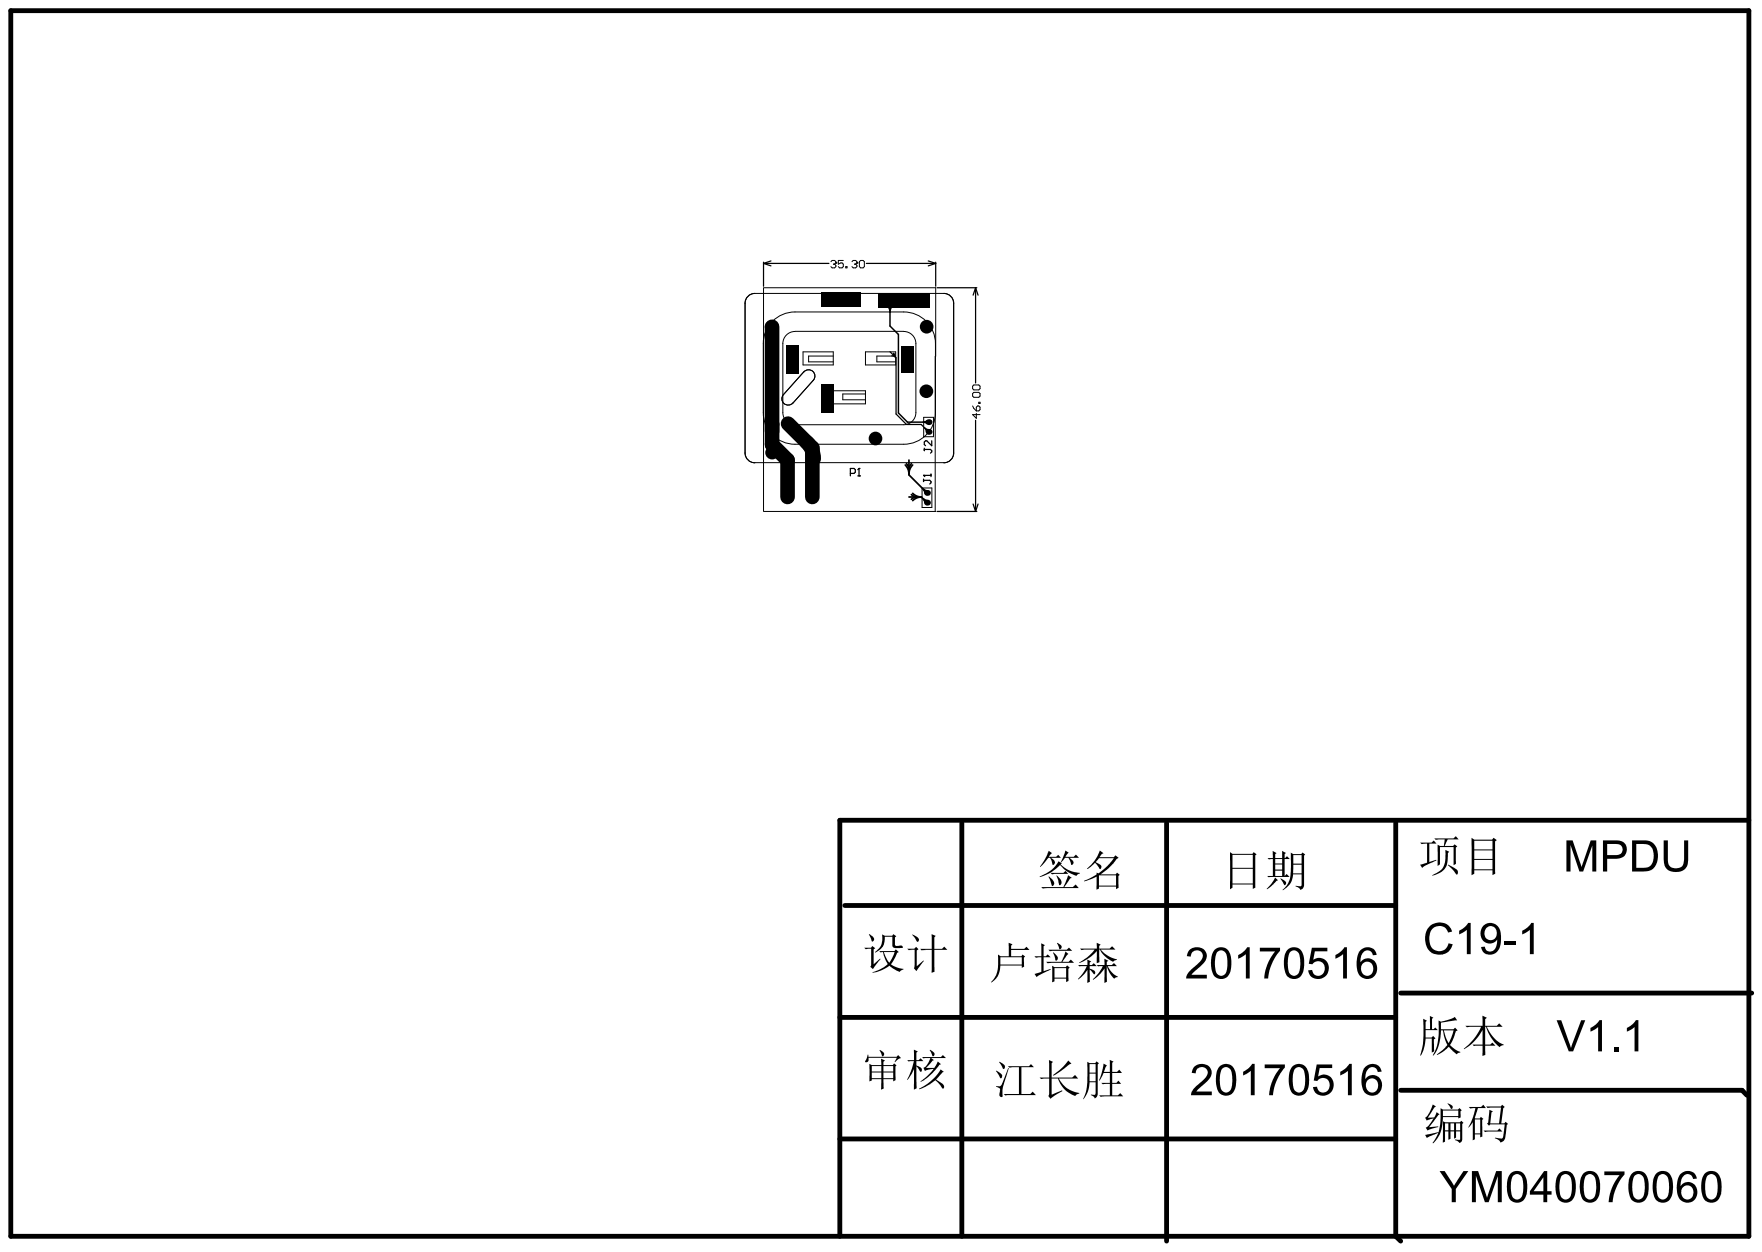
[picture p141: page 1]

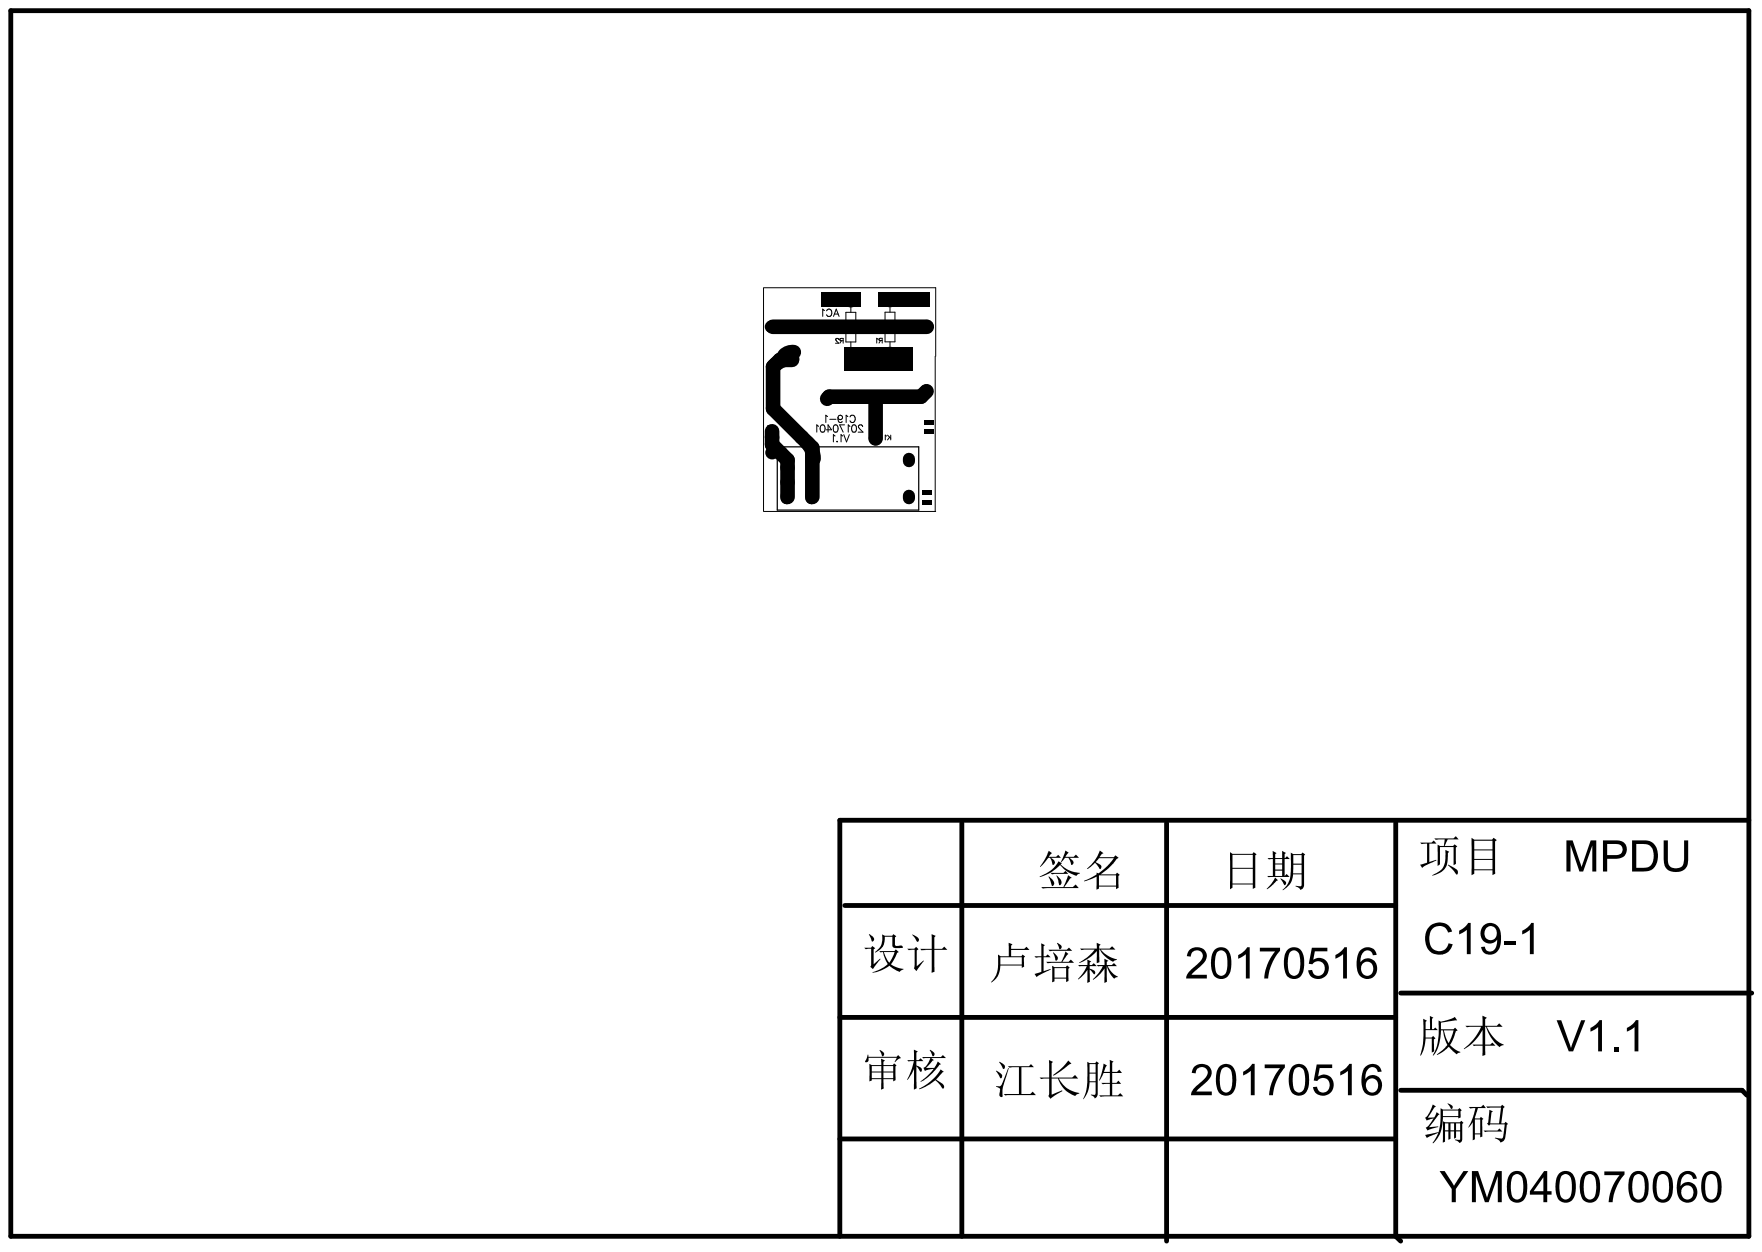
[picture p142: page 2]
