ChinaClever/CleverDoc/MPDU/MPDU 2017产品资料/PCB图/旧/MPDU 2017-XS PCB V1.0.pdf

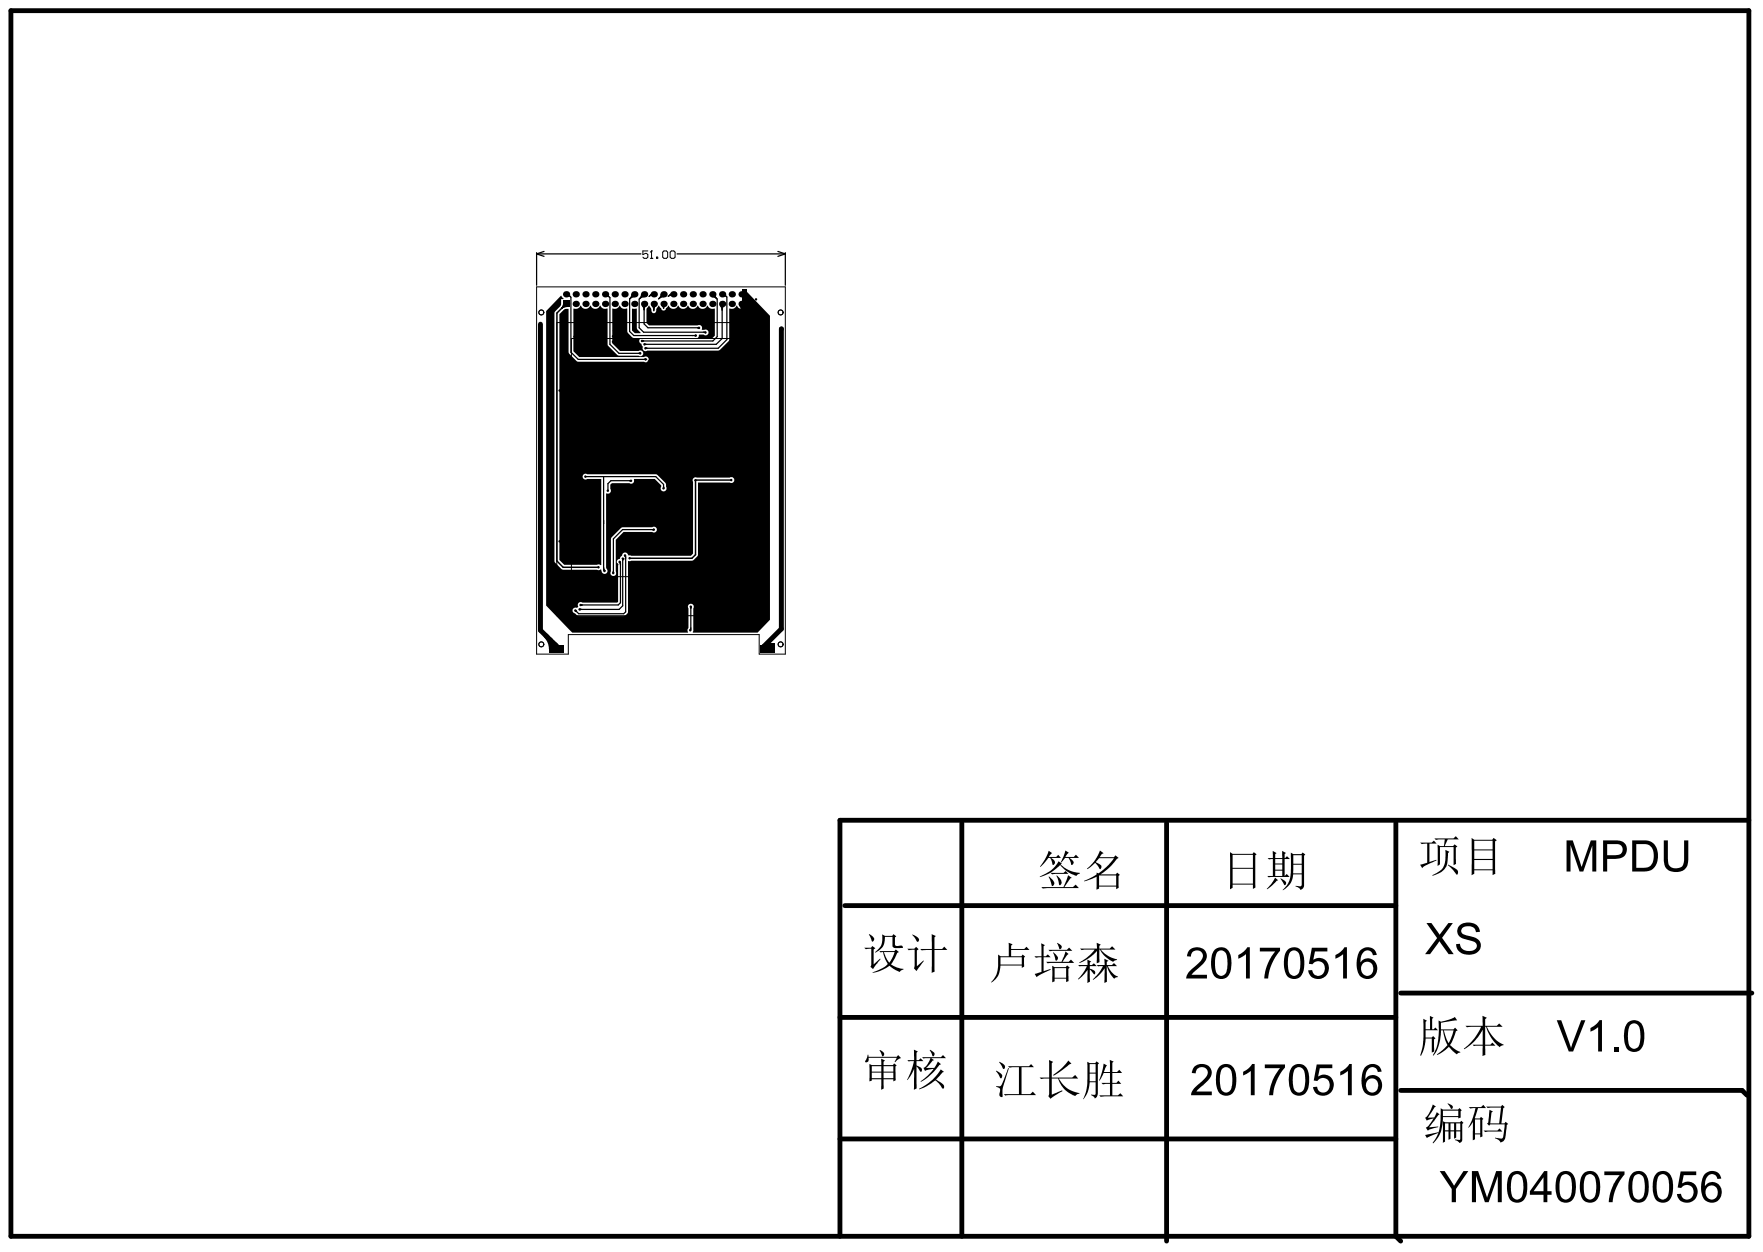
[picture p143: page 1]

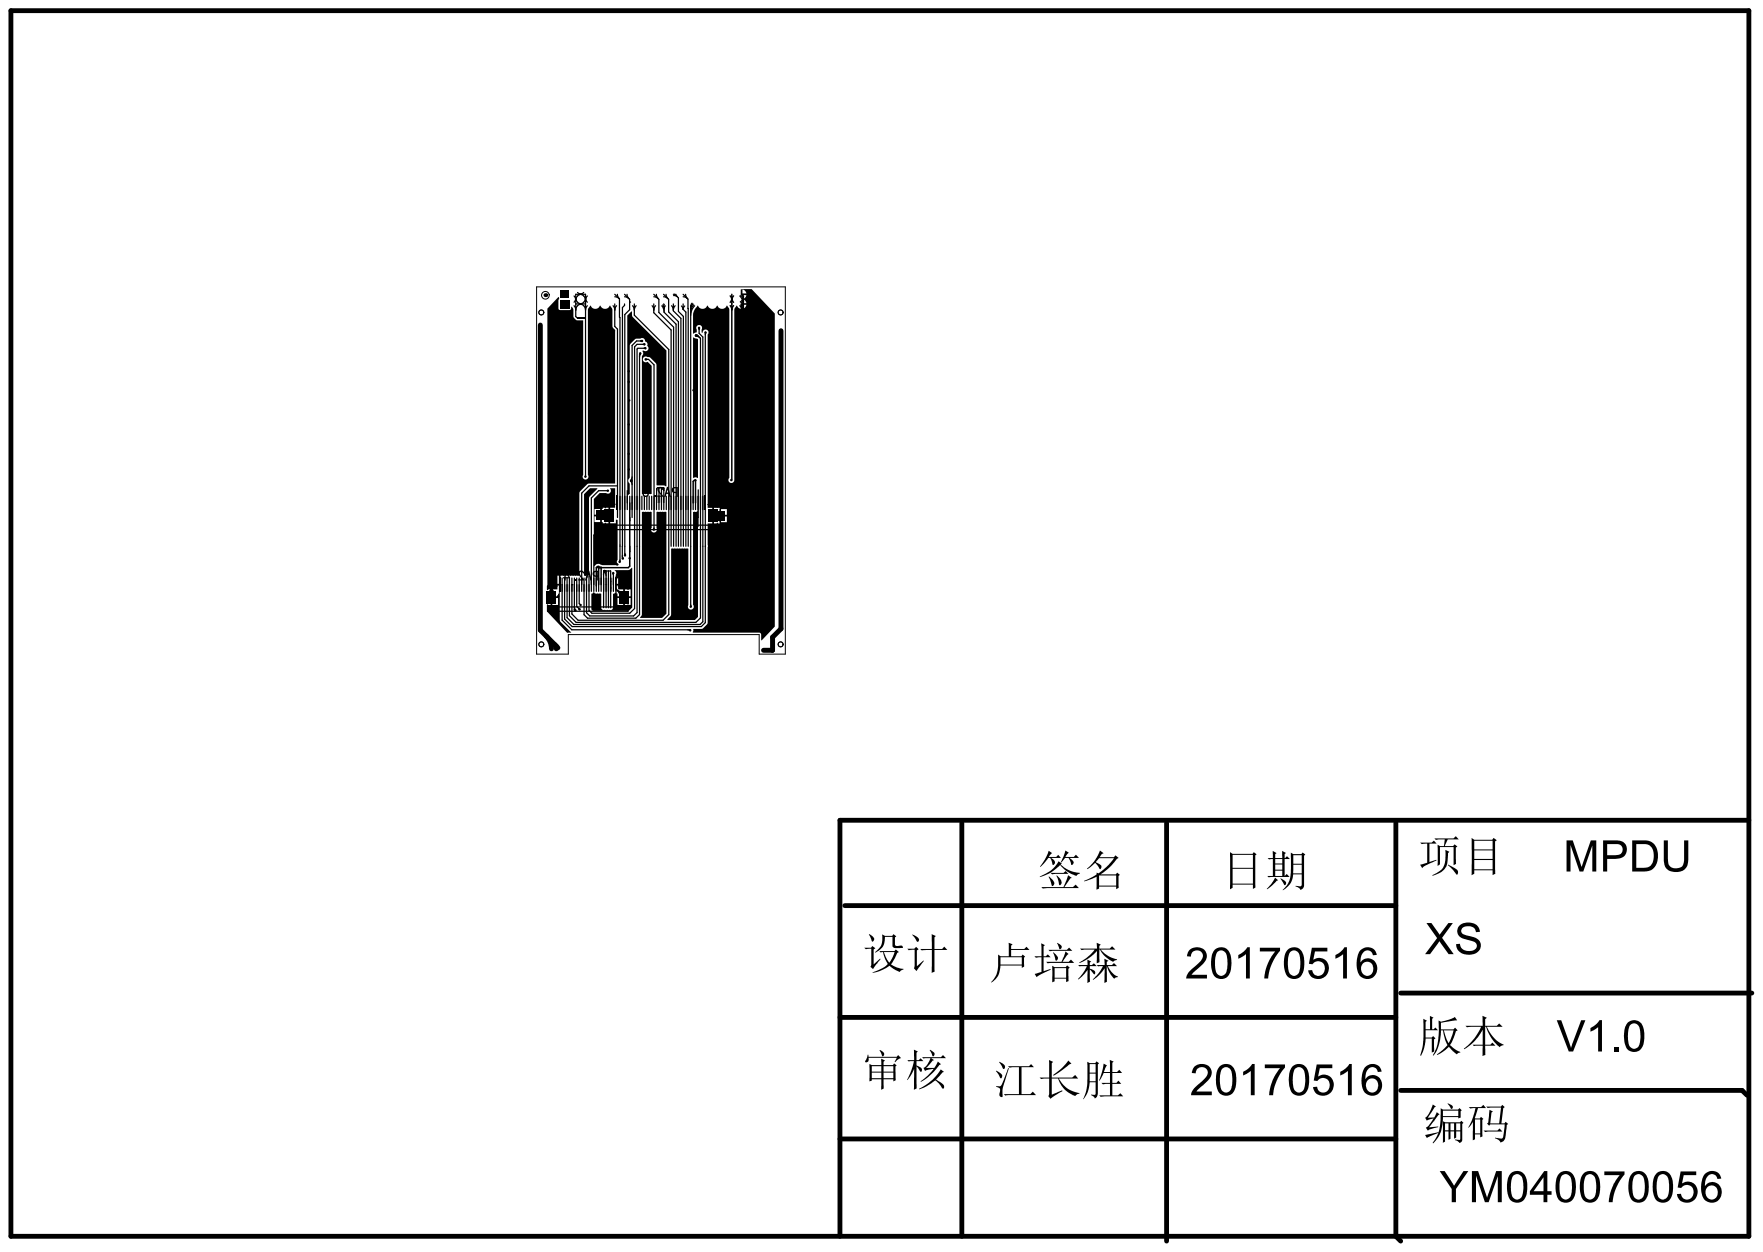
[picture p144: page 2]
