ChinaClever/CleverDoc/MPDU/MPDU 2017产品资料/PCB图/旧/MPDU 2017-ZJ PCB V1.0.pdf

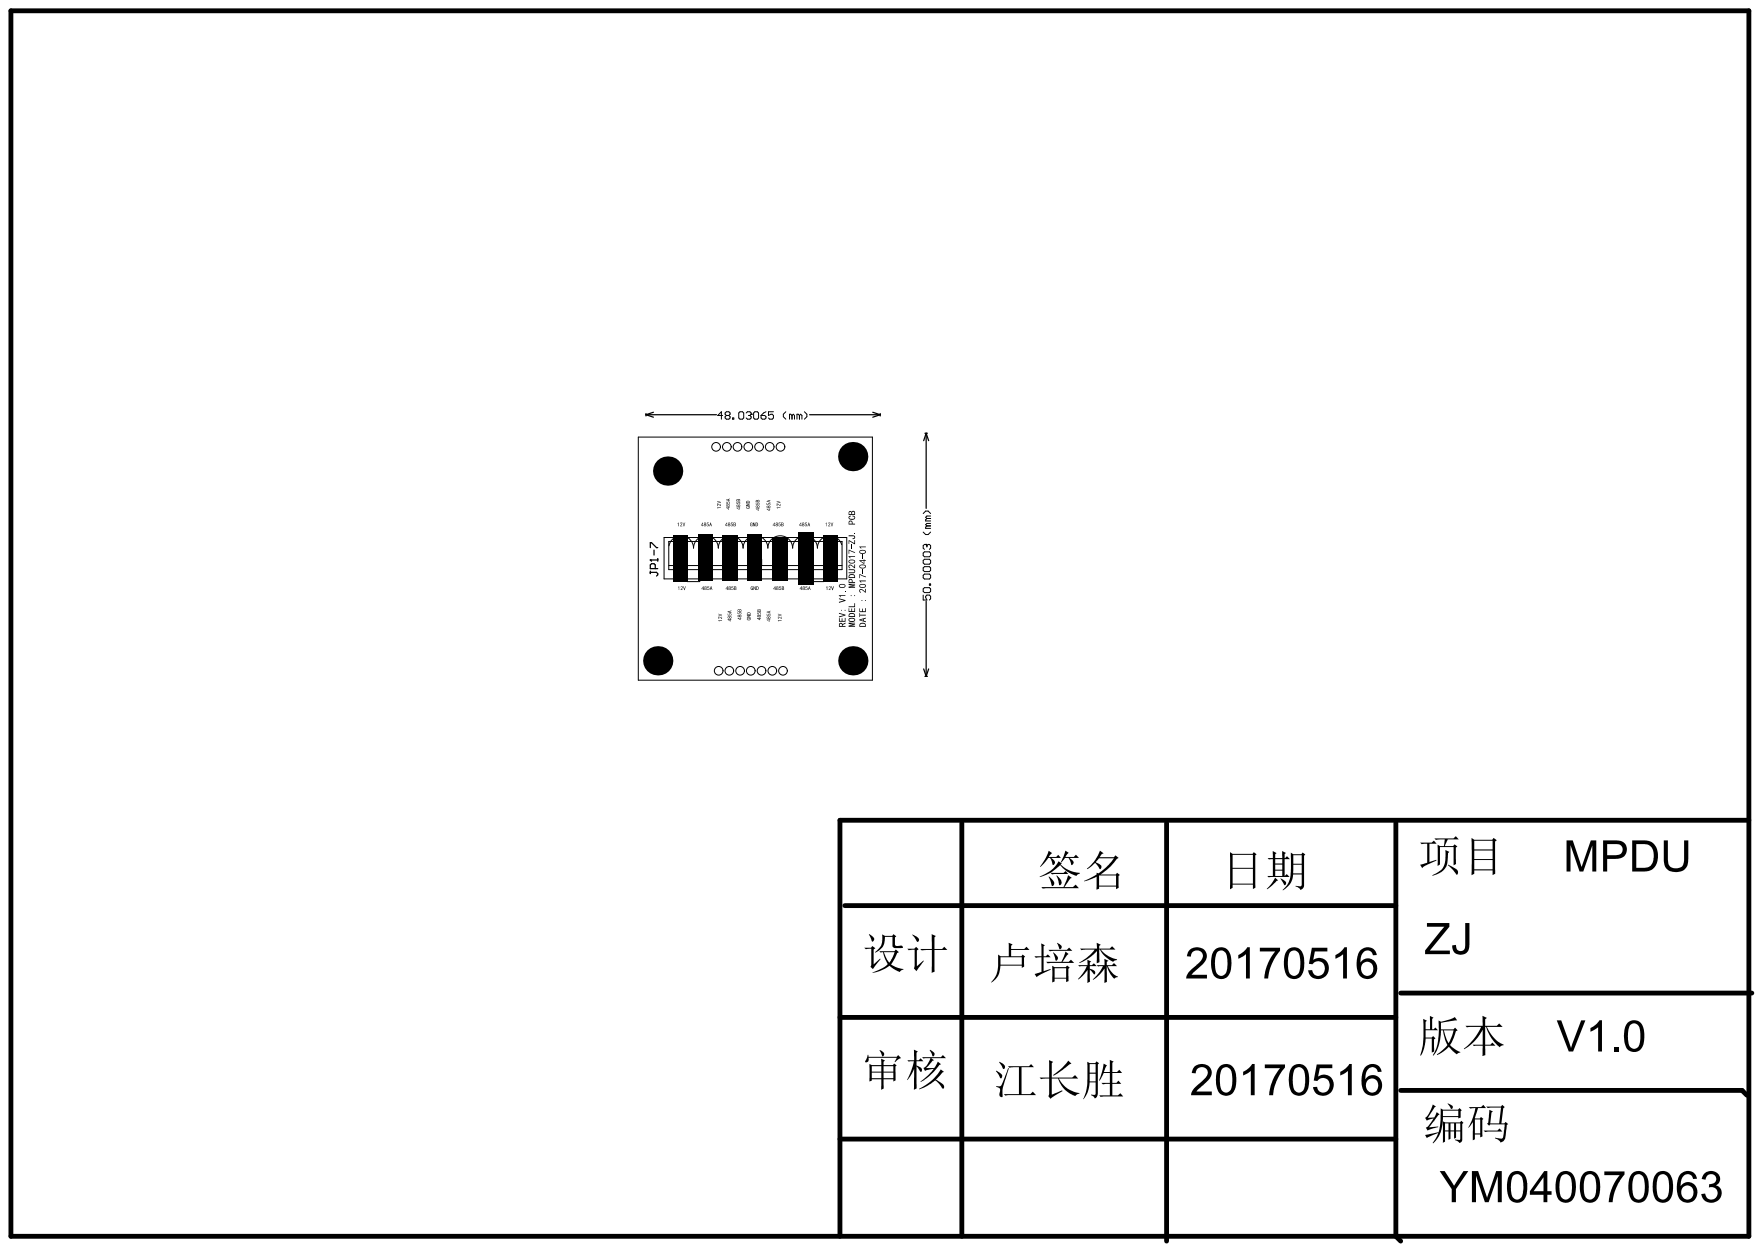
[picture p145: page 1]

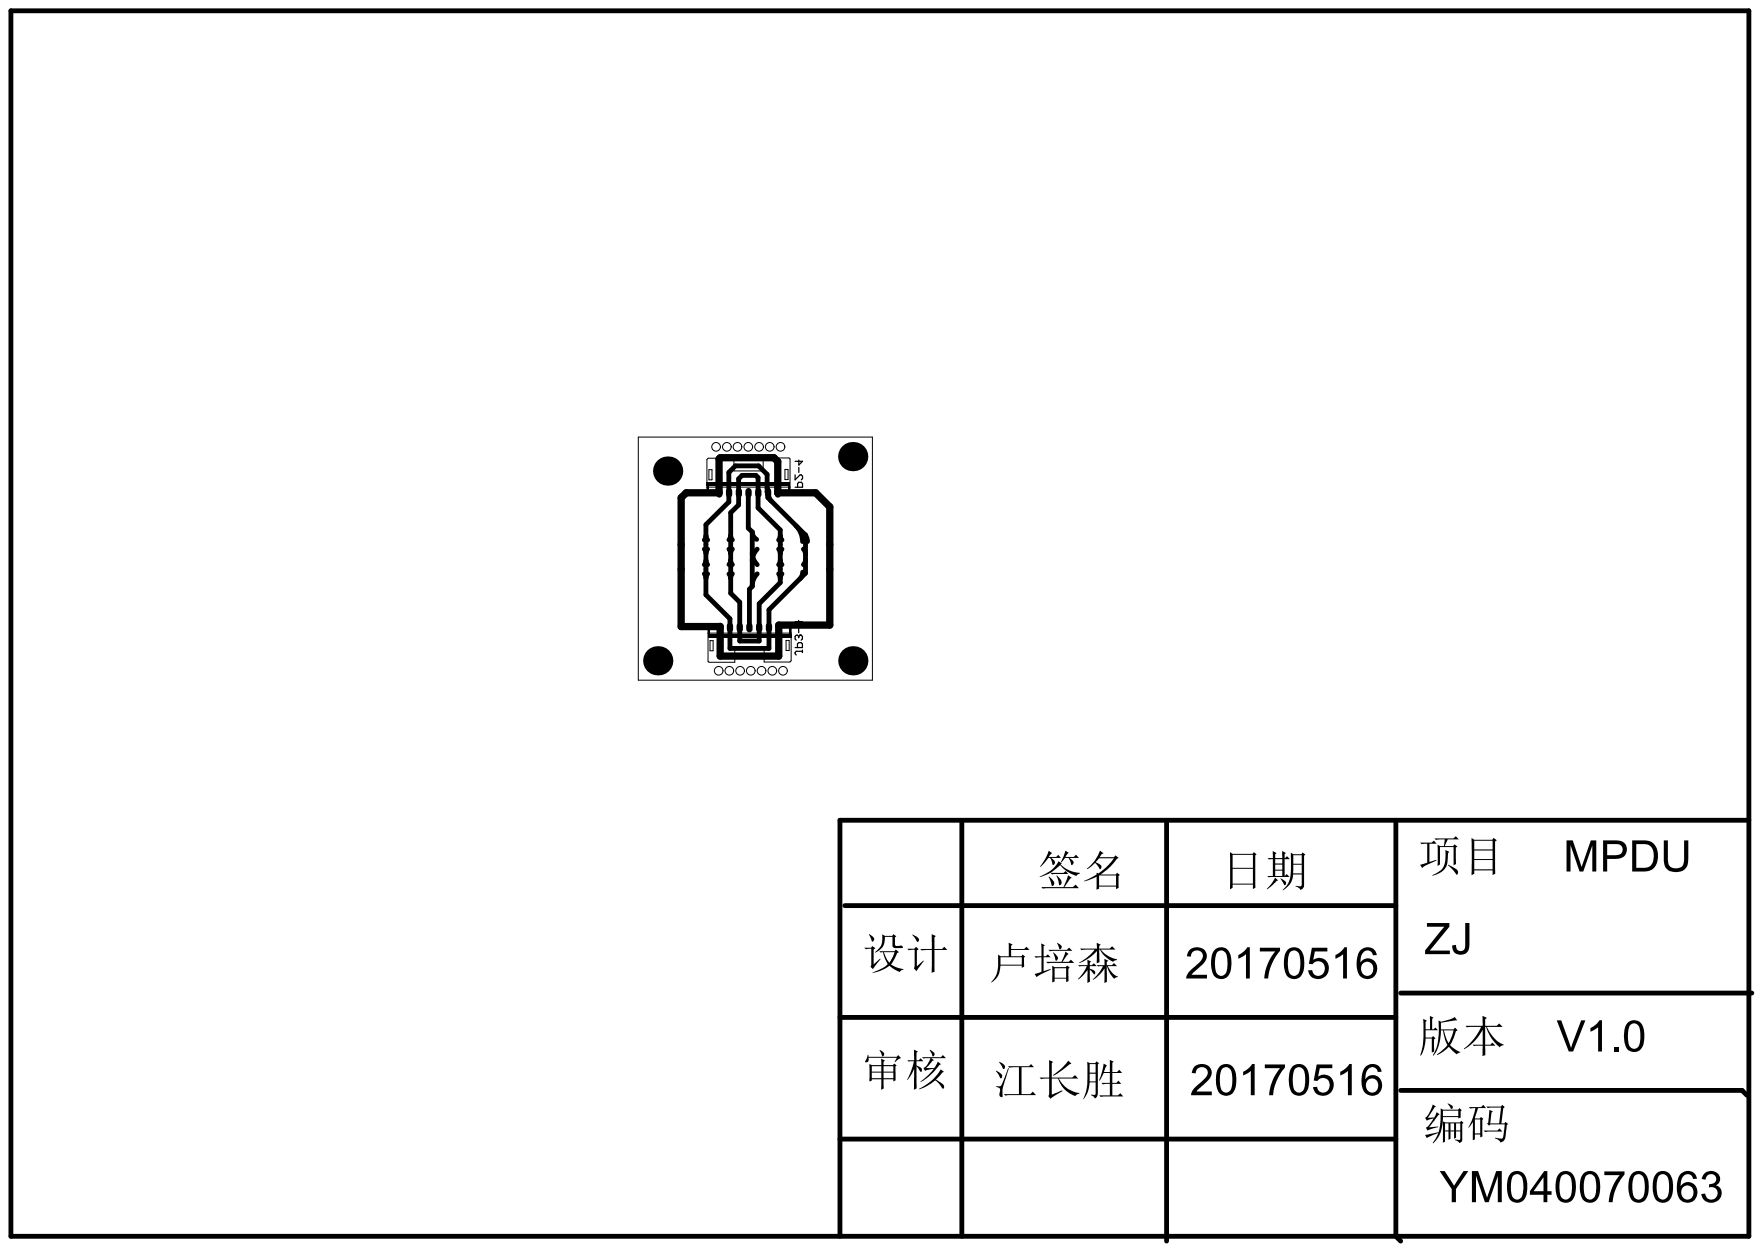
[picture p146: page 2]
