ChinaClever/CleverDoc/(commit log)

2017-07-28 CleverManager项目文档
    [Clever Manager测试用例.xls, clever_manager功能测试纪录.xlsx, 产品P3阶段软件设计QA检查表.xlsx, 功能码表.xlsx, 软件版本移交登记表.xlsx, 通讯测试.xlsx]
2017-07-28 项目文件
    [MPDU 2017与RPDU 2017功能表.xlsx, SNMP版本功能对比表.xlsx, 产品研发P3阶段结构设计QA检查表.xlsx, 产品研发P3阶段软件设计QA检查表.xlsx, 管理型PDU对照表.xlsx]
2017-08-04 文档增加
2017-08-18 临时文件
2017-09-15 项目文档
    [12+2结构部分物料清单(A1-14).xlsx, 12+2结构部分物料清单(B1-14).xlsx, 12+2结构部分物料清单（A15-28）.xlsx, 12+2结构部分物料清单（A29-42）.xlsx, 12+2结构部分物料清单（B15-28）.xlsx, 12+2结构部分物料清单（B29-42）.xlsx, 4+4-结构部分物料清单(A1-8).xlsx, 4+4-结构部分物料清单(B1-8).xlsx]
